Franknakub/driver-drowsiness-detection/hardware/README.md

# Hardware

## ไฟล์ล่าสุด (v2, 3 ต.ค. 2026)

| ไฟล์ | ใช้ทำอะไร |
|---|---|
| `fabrication/2026-10-03_v2/Gerber_PCB1_1_v2_2026-10-03.zip` | อัปโหลดสั่งผลิต PCB ที่ JLCPCB |
| `fabrication/2026-10-03_v2/BOM_PCB1_1_v2_2026-10-03.xlsx` | รายการชิ้นส่วน + รหัส LCSC สำหรับ PCBA |
| `fabrication/2026-10-03_v2/PickAndPlace_PCB1_1_v2_2026-10-03.xlsx` | ตำแหน่งวางชิ้นส่วนสำหรับ PCBA |
| `easyeda/DriverDrowsiness_v2_2026-10-03.epro2` | ไฟล์โปรเจกต์ EasyEDA Pro เปิดด้วย File → Import |

## บอร์ด PCB1_1 v2

| รายการ | ค่า |
|---|---|
| ขนาด | 58.55 × 73.03 มม. 2 ชั้น FR4 |
| ชิ้นส่วน | 37 ชิ้น ประกอบด้านบนทั้งหมด |
| DRC | 0 error |
| กฎออกแบบ | เส้นสัญญาณ 0.30 มม. · ระยะห่าง 0.20 มม. · via 0.61/0.30 มม. |
| เส้นไฟ | 0.80 มม. เท่าที่ระยะห่างยอมให้ (ความยาวที่ได้ 0.80 มม.: 5V 62% · GND 46% · 3V3 38% · VIN 34%) ส่วนที่เหลือ 0.30–0.60 มม. |
| ทองแดง | GND เททั้งสองชั้น + via เย็บ GND 58 ตัว (ห่างกัน ~8.4 มม.) รวม via 82 ตัว |
| รูยึด | M3 (Ø3.2) 4 มุมที่ (11.2, −19.5), (61.8, −19.5), (11.2, −84.5), (61.8, −84.5) + MOUNT1 Ø7.5 ที่ (36.4, −83.2) สำหรับขาตั้งกระจก |
| ไฟเข้า | USB-C (USB1) → CH221K ขอ 5V → สวิตช์ SW1 → ราง 5V |

### เปลี่ยนจาก v1

| # | v1 (31 ส.ค.) | v2 |
|---|---|---|
| 1 | **header U5/U6 เป็นภาพกระจกของโมดูล** เสียบโมดูลหงายแล้วขาไม่ตรง | สลับ U5/U6 ให้ตรงกับโมดูลที่เสียบหงาย (กล้องขึ้น) ปลาย USB หันขอบบน |
| 2 | บอร์ดยาว 65.66 มม. | ยาว 73.03 มม. ย้าย MOUNT1 ลงให้พ้นปลายโมดูลที่ยื่น ~10 มม. |
| 3 | ไม่มีรู M3 | เพิ่มรู M3 สี่มุม และย้าย H2 เป็นแนวนอนที่ (14.1, −24.5) |
| 4 | H2 (buzzer) เลี้ยงด้วย 5V | เลี้ยงด้วย **3V3** ให้ GPIO 3.3V ปิดเสียงได้แน่นอน |
| 5 | เส้นตามกฎ JLCPCB ขั้นต่ำ | เส้น 0.30 มม. / ระยะห่าง 0.20 มม. ตามกฎอาจารย์ |
| 6 | — | silkscreen ลูกศร `MODULE USB` + `CAMERA SIDE UP` และ `DDD v2 2026-10` |

⚠️ **ห้ามเสียบโมดูลบนบอร์ด v1** ขา 5V/GND ของโมดูลไปตกที่เน็ต GND/5V ของบอร์ด ไฟจะเข้ากลับขั้ว

### การวางโมดูล ESP32-S3-CAM

- เสียบหงาย กล้องหันขึ้น ปลาย USB หันขอบบนของบอร์ด (ตามลูกศรบน silkscreen)
- ปลาย USB เสมอแถวขาบนสุด ปลายฝั่ง 3V3 ยื่นเลยแถวขาล่าง ~10 มม. กว้าง ~20 มม. ส่วนนี้คือเสาอากาศ WiFi
- ตอนเสียบสายคอมเข้าพอร์ต USB ของโมดูล ให้เลื่อน SW1 ไปที่ OFF ก่อน (ขา 5V ของโมดูลต่อตรงกับราง 5V ของบอร์ด)

## ไฟล์เก่า

| โฟลเดอร์ | เนื้อหา |
|---|---|
| `fabrication/archive/2026-08-31_v1_ordered/` | v1 ที่สั่งผลิตไปแล้ว (header เป็นภาพกระจก) |
| `fabrication/archive/2026-08-31_1142/` | export ระหว่างทาง ก่อนแก้ C7/H2 |
| `fabrication/archive/2026-08-28/` | ชุดแรก |
| `easyeda/archive/DriverDrowsiness_v1_2026-08-31.epro2` | โปรเจกต์ v1 |

## ประเด็นที่ยังเปิดอยู่

1. **โมดูล buzzer จริง** ยังไม่ได้ดูว่าใช้ทรานซิสเตอร์ PNP หรือไม่ ถ้าไม่ใช่ เสียงที่ไฟ 3V3 อาจเบากว่าเดิม และต้องเช็คลำดับขาก่อนเสียบ
2. **ไฟเขียว LED1 หรี่** R11 = 470Ω ได้กระแส ~1 mA ถ้าต้องการให้สว่างขึ้น เปลี่ยนเป็น 120Ω ตอนบัดกรีได้
3. **IR LED ใน BOM** TSAL6200 เป็น 940 nm (Vishay doc 81010) ไม่ใช่ 850 nm ถ้าต้องการ 850 nm ใช้ TSHG6400 แทน เป็น through-hole เปลี่ยนเองได้
4. **IR-cut filter ของกล้อง** ยังทดสอบไม่จบ ถ้ากล้องมีฟิลเตอร์ IR LED จะไม่มีผล ใช้ `firmware/DrowsinessDiag` ทดสอบ
5. **อุณหภูมิ** ชิปรับได้ถึง 65°C แต่ในรถกลางแดดถึง 70–80°C ต้องถอดเก็บเมื่อจอด
