Franknakub/driver-drowsiness-detection/enclosure/README.md

# กล่อง 3D

> ⚠️ **ไฟล์ใน `cad/out/` เป็นฉบับร่าง (18 ต.ค. 2026) ยังห้ามสั่งปริ้นตัวจริง** — ยังมีค่าสมมติ (ดูหัวข้อ "ก่อนสั่งปริ้น")

| ไฟล์ | เนื้อหา |
|---|---|
| [DESIGN_INPUTS.md](DESIGN_INPUTS.md) | ค่าที่เชื่อได้ (Gerber v2 + ค่าวัดจริง) · ค่าที่ขัดกัน C1–C6 · ค่าที่ต้องวัดใหม่ |
| [DESIGN_PROPOSAL.md](DESIGN_PROPOSAL.md) | แบบที่ผู้ใช้อนุมัติแล้ว 17 ต.ค. (ผังรวม, หน้าตัดความสูง, รายละเอียดทุกช่อง) |
| `cad/enclosure.py` | สคริปต์ build123d — ค่าทุกตัวอยู่หัวไฟล์ พร้อมป้าย `MEAS` / `DESIGN` / `ASSUMED` |
| `cad/check.py` | ตรวจการชนกับหุ่นจำลองชิ้นส่วน + ส่ง SVG มุมมองบน |
| `cad/out/` | `lid` (ฝาหน้า) · `base` (ฐาน) · `sw1_extender` (ด้ามต่อสวิตช์) เป็น `.step` และ `.stl` (สร้างใหม่ทุกครั้งที่รันสคริปต์) |
| `print_2026-10-18/` | **ชุดส่งร้านปริ้น** (สำเนาคงที่ของ cad/out 18 ต.ค.) + `ข้อความส่งร้าน.txt` · ด้ามต่อ SW1 ในชุดนี้ใช้ไม่ได้ (ดูแถวล่าง) |
| `print_2026-10-26/` | **ด้ามโยก SW1** (`sw1_rocker`) + **ขาแขวนหมุด** (`sw1_bracket`) แทนด้ามต่อแบบเลื่อน + `ข้อความส่งร้าน.txt` · ฝา/ฐานใช้ชุด 18 ต.ค. · **ปริ้นแล้วพัง (4 พ.ย.) ไม่ได้ใช้** |

แบบร่างเก่า https://claude.ai/artifact/W44j3wrijPSJBLZRLcjgHY ใช้ขนาดเดา **เลิกใช้แล้ว**

## สร้างไฟล์ใหม่หลังแก้ค่า

```bash
uv venv --python 3.12 "$LOCALAPPDATA/ddd-enclosure-venv"
uv pip install --python "$LOCALAPPDATA/ddd-enclosure-venv/Scripts/python.exe" build123d
cd enclosure/cad
PYTHONIOENCODING=utf-8 "$LOCALAPPDATA/ddd-enclosure-venv/Scripts/python.exe" enclosure.py
PYTHONIOENCODING=utf-8 "$LOCALAPPDATA/ddd-enclosure-venv/Scripts/python.exe" check.py
```

ต้องได้ `lid solids 1 valid True` และ `no clashes` ก่อนส่งไฟล์ (venv ที่ `%LOCALAPPDATA%\ddd-enclosure-venv` ติดตั้งไว้แล้ว)

## ฉบับร่างปัจจุบัน

- ภายนอก **64.5 × 120.3 × 36.8 มม.** (ค่าวัดถึง 18 ต.ค.) (ไม่รวมหูรัดสาย USB1 ที่ยื่นจากฐาน 12 มม.)
- ความสูง (z จากผิวพื้นใน): หลังกล่อง −6 · ผิวบน PCB 7.69 · ยอดเลนส์ 28.46 · ผิวในฝา 28.76 · ผิวนอกฝา 30.76
- หูรัดสาย USB-C ยกขึ้นเป็นก้อนตันถึงใต้หัวสาย ห่าง 0.8 มม. (18 ต.ค.) · เคเบิลไทร์ลอดร่องบนหู อ้อมปลายหู แล้วพาดข้ามหัวสาย
- จอ OLED หมุน 90° ในส่วนต่อขยาย (18 ต.ค.): ตอนติดตั้ง ขาจออยู่บน ภาพแนวนอน 128×64 ปกติ ไม่ต้องหมุนภาพใน firmware
- ติดตั้งแนวนอน **แถว IR อยู่บน** (ผู้ใช้เลือก 18 ต.ค.): น็อตขาดูดอยู่บน · สาย USB-C เข้าจากล่าง · จอ OLED อยู่ขวามือคนขับ · ช่อง USB โมดูลอยู่ซ้าย · ป้ายสลักอ่านแนวนอน
- **ทดสอบแล้ว 18 ต.ค.:** ทิศนี้ (กล้องหันหาคนขับ ช่อง USB โมดูลอยู่ซ้าย) ภาพดิบตะแคง 90° → firmware ใช้ `CAM_ROTATE_CW 270` ตามเดิม ภาพบน `/snapshot.jpg` ตั้งตรง · ผู้ใช้ยืนยันเลือกแนวนอน (ยอมเสียเวลาหมุนภาพ ~31 ms/เฟรม ที่ HVGA) แทนกล่องแนวตั้ง

### ขาติดตั้ง (ผู้ใช้เลือก 18 ต.ค.)

ขาดูดกระจกแบบกล้องหน้ารถ: ถ้วยดูด ~70–80 มม. + คันโยก PRESS → ข้อพับปรับมุมด้วยน็อตปีก 2 ข้อ → แป้นกลมลายตาข่าย **Ø30.36** (วัด) กับเกลียวตัวผู้ **1/4"-20** (วัด Ø 6.3–6.4)

- **หลังกล่องหันเข้ากระจก** หน้ากล่อง (กล้อง/IR/จอ) หันหาคนขับ กล่องห้อยจากขาดูด
- น็อต 1/4"-20 ฝังในฐานที่ (48.0, 47.5) คือราวกลางแนวยาว เยื้องไปฝั่ง IR ห่างขอบโมดูลและเสาอากาศ ~5.5 มม. ในแนวราบ และต่ำกว่าเสาอากาศ ~20 มม.
  - ศูนย์กลางกล่องจริงอยู่ตรงเสาอากาศพอดี จึงไม่ใช้จุดนั้น
- หลังกล่องหนาขึ้นทั้งแผ่นอีก 6 มม. น็อตจึงจมอยู่ใต้ผิวพื้นในทั้งตัว
  - พื้นในเหนือน็อตมีขา THT ของ header/IR โผล่ใต้บอร์ด ทำเสานูนขึ้นไปไม่ได้
  - ทำเป็นแป้นนูนแค่ตรงจุดขันก็ไม่ได้ เพราะต้องใช้ support ตอนปริ้น
- **ความยาวเกลียวที่ใช้ได้:** วัดจากหน้าแป้นลายตาข่ายถึงปลายเกลียว ต้องอยู่ระหว่าง **5.8–11.5 มม.**
  - 5.8 มม. กินเกลียว 3 รอบ ถ้า ≥ 7.6 มม. กินเต็มน็อต
  - ถ้ายาวเกิน 11.5 มม. ปลายเกลียวจะชนใต้ PCB ให้หมุนแหวนล็อกบนขาลงมาบังส่วนเกิน
  - **วัดแล้ว 10.16 มม.** (18 ต.ค.) → กินเต็มน็อต ปลายเกลียวยังห่างใต้ PCB ~1.3 มม.

## อะไหล่

| ของ | จำนวน |
|---|---|
| ✅ ซื้อแล้ว · น็อต M3 × 10 หัวจมหกเหลี่ยม**ทรงกระบอก** (DIN 912 · HSHMS-M3x10 · หัว Ø5.5 สูง 3 · ไม่ใช่หัวเตเปอร์) (MH1–MH4) | 4 |
| ✅ ซื้อแล้ว · น็อต M3 × 6 หัวจมหกเหลี่ยมทรงกระบอก (DIN 912 · HSHMS-M3x6) (มุมส่วนต่อขยาย) | 2 |
| ✅ ซื้อแล้ว · heat-set insert M3 × 5.7 (D1 4.6 · formflex ใน Shopee · รูเจาะ 4.0 ลึก 6.7) · สั่ง 10 ชิ้นเผื่อเสีย | 6 |
| ✅ ซื้อแล้ว · สกรูเกลียวปล่อยหัวจมหกเหลี่ยม M2 × 5 (HSHTS-M2x5 · จอ OLED · จอร่นจากผิวในฝา 0.8 ให้ปลายสกรูเหลือเนื้อหน้าฝา 0.8) | 4 |
| ✅ ซื้อแล้ว · สกรูเกลียวปล่อยหัวจมหกเหลี่ยม M3 × 6 (HSHTS-M3x6 · buzzer) | 1 |
| ✅ ซื้อแล้ว · น็อตหกเหลี่ยม 1/4"-20 ขนาด 7/16" (11.1 มม.) หนา ≤ 5.6 (ฝังในฐาน ใส่จากด้านในก่อนวาง PCB) | 1 |
| ✅ ซื้อแล้ว · แท่งอะคริลิกใส Ø3 (light pipe) · LED1 ยาว ~23.4 มม. ใส่เอียง 15° · LED2 ~22.6 มม. · วัด Ø จริงตอนของถึง (รูบนฝา 3.2) | 2 |
| ✅ ซื้อแล้ว · เคเบิลไทร์เล็ก (รัดสาย USB-C ที่หูฐาน) | 1 |
| ✅ มีแล้ว · ประแจหกเหลี่ยม 2.5 (M3 หัวจม) และ 1.5 (M2 เกลียวปล่อย) | 1 ชุด |
| ✅ ซื้อแล้ว · หัวแร้งปรับอุณหภูมิได้ (TASKTOOL 150W ชุด 18 ชิ้น) | 1 |
| ✅ ซื้อแล้ว · กระดาษทรายน้ำเบอร์ 600 | 1 |
| ✅ ซื้อแล้ว · กาวอีพ็อกซี UHU 5 นาที สีใส (ยึดแท่งอะคริลิก ห้ามกาวตราช้าง) | 1 |

## สั่งปริ้น (ส่งร้าน)

- **ASA สีดำทึบ** (ผู้ใช้เลือก · ทน UV และ ~95°C) — ห้าม PLA (นิ่มที่ 55–60°C รถกลางแดด 70–80°C)
- FDM หัว 0.4 · ชั้น 0.2 มม. · ผนัง (perimeter) ≥ 4 เส้น ให้ผนัง 2 มม. ทึบทั้งหมด (แสง IR 940 nm ทะลุพลาสติกบางได้) · infill 30%
- `lid`: คว่ำหน้าฝาลงฐานพิมพ์ · `base`: วางพื้นลง · ไม่ต้องมี support ทั้งสองชิ้น (ช่อง USB โมดูลเป็นสะพาน ~24 มม.)
- `sw1_rocker`: วางตั้ง ง่ามลงพื้น · `sw1_bracket`: ใส่ support ได้ · `sw1_pin`: วางตั้ง หัวลงพื้น (สั่ง 2 ชิ้น สำรอง 1) · infill 100% ทุกชิ้น · รูหมุดต้องทะลุ
- **ด้ามต่อแบบเลื่อน (18 ต.ค.) ใช้ไม่ได้** (ทดสอบ 26 ต.ค.): ดันที่ปลายแล้วด้ามเอียงงัดก้าน สวิตช์ไม่เลื่อน (ดันที่โคนเลื่อนได้) · ก้าน SW1 เองก็โยกเอียงในตัวสวิตช์ได้ · แบบแผ่นยาวใต้ฝา (commit ce36122) ก็ไม่พอ: หัวด้ามสูงกว่าก้าน ~18 มม. แผ่นยาว 12 มม. → แรงเสียดทานกินแรงดัน (μ ~0.3 ต้องออกแรง ~10 เท่า) ไม่ได้ปริ้น
- **ก้าน SW1 งอ/เอียงได้มาก** (ผู้ใช้ 26 ต.ค.): ดันปลายก้าน ก้านแค่เอียงจนเกือบหัก สวิตช์ไม่เลื่อน · ดันโคนก้านชิดตัวสวิตช์เลื่อนได้ → อะไรก็ตามที่ขับ SW1 ต้องดันที่โคนก้าน
- **ด้ามโยก (26 ต.ค.):** คันโยกหมุนรอบหมุดปริ้น ASA (`sw1_pin` Ø1.8 หัว Ø3.2 × 0.8 · รูแก้ม 1.9 · รูด้าม 2.1 ในปุ่มกลม R2.15 ยอดปุ่มต่ำกว่าแผ่นติดกาว 0.4 · ผู้ใช้เลือกปริ้นหมุดแทนลวดคลิป) ที่สูง z 25.0 ในขาแขวนซึ่งติดอีพ็อกซีใต้ฝารอบร่อง (เดือยสองปลายเข้าร่องฝาไว้จัดตำแหน่ง) · ง่ามแตะก้าน**เฉพาะแถบล่างสูง 1 มม.** (ช่อง 1.95 ผนัง 0.8) ก้นง่ามสูงกว่าหลังตัวสวิตช์ 0.4 · เหนือแถบเว้นช่อง 3.5 ไม่ให้แตะปลายก้าน (ห่าง ≥ 0.28 ตอนโยกสุด) · โยก ±8.9° = ก้านเลื่อน ±1.88 · หัวด้ามขยับ ±1.17 **กลับทิศกับก้าน** (บนโต๊ะ: หัวด้ามไปทางโมดูล = OFF) · แรงที่หัวด้าม ~1.6 เท่าแรงสวิตช์ · โยกได้สุด ~15° ก่อนชนขาแขวน · ง่ามห่างตัวสวิตช์ ≥ 0.28 ทุกมุม · `check.py` ไม่ชนทุกมุม ขาแขวนห่างเสา MH3 0.28 มม. · ขาแถบสัมผัสบาง 0.8 อาจเปราะ · **ปริ้นแล้วพัง (4 พ.ย.)**
- ประกอบ: สอดหัวด้ามขึ้นผ่านช่องขาแขวน → เสียบหมุดจากแก้มฝั่ง y น้อย (ฝั่งไกลจากเสา MH3) ผ่านแก้ม-ด้าม-แก้ม ปลายหมุดโผล่ 0.3 แต้มอีพ็อกซีติดแก้ม (ห้ามโดนด้าม) → สอดหัวด้ามขึ้นร่องฝาจากด้านใน ให้เดือยลงร่อง → ทาอีพ็อกซีเฉพาะผิวแผ่นติดกาว (ห้ามโดนหมุด) · ตอนปิดฝา โยกด้ามให้ง่ามตรงก้าน (SW1 = OFF) · สาย dupont ห้ามพาดผ่านขาแขวน
- **ที่ใช้จริงตอนนี้:** **4 พ.ย. (ผู้ใช้): ชิ้น SW1 ที่ปริ้น 3D พัง และสวิตช์ใหม่ที่ซื้อมาใช้ไม่ได้ → ใช้ SW1 เดิมบนบอร์ด เลื่อนด้วยไม้จิ้มฟันแหย่ผ่านร่องฝา ดันที่โคนก้าน**

## ประกอบ

1. ใส่ insert M3 ในเสาของฝา 6 ตัว (หัวแร้ง) · ใส่น็อต 1/4"-20 ในช่องหกเหลี่ยมของฐานจากด้านใน
2. ยึดจอ OLED ใต้ฝา (กระจกแนบหน้าต่าง) ด้วย M2 × 4 · ยึด buzzer บนเสาฐาน
3. เสียบโมดูลบน PCB → วาง PCB บนเสาฐาน · ต่อสาย dupont H1→จอ, H2→buzzer (ลำดับขาตาม CLAUDE.md ประเด็นค้าง #1, #7)
4. SW1 ไม่ต้องใส่ด้ามต่อ (เปิด/ปิดด้วยไม้จิ้มฟันแหย่ผ่านร่องฝา ดันที่โคนก้าน) · สอดแท่งอะคริลิกในรู LED · ปิดฝา ขันน็อตจากด้านหลัง 6 ตัว
5. ขันกล่องเข้าเกลียวขาดูด หมุนให้ภาพตั้งตรงแล้วล็อกแหวน
6. ⛔ **SW1 = OFF ก่อนเสียบสาย USB เข้าโมดูลเสมอ** (มีป้ายสลักบนฝา)

## ก่อนสั่งปริ้น

ผู้ใช้ตัดสิน 18 ต.ค.: **ไม่ปริ้นทดลอง · วัดค่าสมมติให้ครบก่อน แล้วสั่ง ASA** (ระยะเผื่อ 0.45 มม.)

1. กรอกช่องป้าย "วัดใหม่" ใน[ตารางวัดขนาด](https://claude.ai/artifact/4DLjDZ4ykqrCnTMR8mrWsw) แล้วให้ Claude อ่าน db ใส่หัว `enclosure.py`:
   ก้าน SW1 (`sw_lw`, `sw_lt`) · แผ่น PCB จอ (`oled_pt`) · ตำแหน่งรูจอ (`oled_hx`, `oled_hy`) · พื้นที่แสดงผล (`view_w/h`, `view_dx/dy`) · หัว dupont ของ buzzer (`bz_dup`) · (insert เลือกแล้ว: M3 × 5.7 ไม่ต้องกรอก `ins_spec`)
2. ~~ทดสอบทิศภาพ~~ ✅ ทำแล้ว 18 ต.ค. (firmware ไม่ต้องแก้)
3. ทดสอบมุมกล้องในรถจริงด้วยขาดูด — กล่องจะอยู่สูงกว่าตาคนขับและมองลง ซึ่งยังไม่เคยทดสอบหาหน้า (ทดสอบแล้วแค่ระดับตา 100% และมองขึ้นจากต่ำ 20%)
4. รัน `enclosure.py` + `check.py` ใหม่ ต้องได้ `no clashes` และ LED rod ทั้งสองข้าง `ok`

ค่าวัดชุด 17 ต.ค. (ความสูงเลนส์, ตำแหน่งเลนส์, USB, SW1, หัวสาย) และความยาวเกลียวขาดูด 10.16 ใส่แล้ว · LED1 อยู่ใต้มุมโมดูล จึงใช้แท่งเอียง 15° ไปทางขอบล่างบอร์ด (ยาว ~23.4 มม.)
