Franknakub/driver-drowsiness-detection/enclosure/DESIGN_INPUTS.md

# ข้อมูลตั้งต้นสำหรับออกแบบกล่อง (17 ต.ค. 2026)

แหล่งข้อมูล: Gerber/PickAndPlace `FinalV2/` (3 ต.ค.) · db ของตารางวัดขนาด (`plan/measure` v332, กรอกล่าสุด 14 ต.ค.) · CLAUDE.md ชั้นบน · ผลทดลองหาหน้า (FaceSpike)

**ระบบพิกัด:** วางบอร์ดด้านชิ้นส่วนขึ้น ลูกศร `MODULE USB` ชี้ขึ้น · x = มม. จากขอบซ้าย · y = มม. จากขอบบน · z = สูงจากผิวบน PCB
**สูตรแปลงจาก EasyEDA ยืนยันจาก Gerber แล้ว** (ขอบบอร์ด X 7.239…65.786, Y −15.494…−88.519): `x = X − 7.239` · `y = −15.494 − Y` → รูยึดห่างขอบ 4.00 มม. จริง ไม่ใช่ค่าสมมติแล้ว

---

## 1. ค่าที่มีแล้วและเชื่อได้

### จากไฟล์ผลิต v2 (Gerber + PnP)

| ชิ้น | x, y (มม.) | หมายเหตุ |
|---|---|---|
| บอร์ด | 58.55 × 73.03 | |
| MH1–MH4 NPTH Ø3.20 | (4.00, 4.00) (54.55, 4.00) (4.00, 69.02) (54.55, 69.02) | **v1 ไม่มีรูเหล่านี้** |
| MOUNT1 NPTH Ø7.50 | (29.21, 67.69) | |
| U6 header (ซ้าย) | รู x 13.08 / 15.62 · y 2.29 … 50.55 | 2×20 ระยะ 2.54 |
| U5 header (ขวา) | รู x 41.02 / 43.56 · y 2.29 … 50.55 | ขาโมดูลลงแถวใน (15.62 / 41.02 ห่าง 25.40) → แนวกลางโมดูล x = 28.32 |
| IR1–IR4 | x 53.76 · y 12.51 / 26.51 / 40.51 / 54.51 | ขา x 52.49 / 55.03 |
| LDR (R2) | (5.59, 31.37) | ขา y 29.67 / 33.07 |
| USB1 (USB-C รับไฟ) | (3.68, 17.40) หมุน 270° | รูยึดเปลือก x 2.38 / 6.08, y 13.08 / 21.72 |
| SW1 SS-12D01 | (7.49, 62.49) | ขาเรียงแนว x 4.99 / 7.49 / 9.99 → ก้านเลื่อนแนวซ้าย–ขวา |
| H1 (OLED 4 ขา) | x 5.33 · y 38.23 … 45.85 | แนวตั้ง |
| H2 (buzzer 3 ขา) | y 9.02 · x 4.32 / 6.86 / 9.40 | แนวนอน |
| LED1 เขียว / LED2 แดง | (41.15, 58.04) / (46.48, 57.92) | SMD 0805 / 0603 |
| C7 (ตัวเก็บประจุทรงกระบอก Ø5) | (4.95, 54.99) | ความสูงยังไม่ได้วัด (ต่ำกว่า header แน่นอน) |

### จากการวัดจริง (ผู้ใช้ · ค่าในวงเล็บคือค่าที่อ่านได้)

| id | ค่า | หมายเหตุ |
|---|---|---|
| pcb_t | 1.69 | |
| pcb_w | 58.55 (58.547) | ตรงแบบ |
| ir_h1–4 | 9.31 (11 − 1.69) | ตั้งตรงทั้ง 4 ดวง |
| ir_d | 5.9 | ปีกโคน TSAL6200 (ค่าแบบ 5.0 เป็นค่าเดาเก่า) |
| sw_h | 8.31 (10 − 1.69) | |
| usb1_h | 3.11 (4.8 − 1.69) | |
| usb1_over | 0.95 (59.5 − 58.55) | USB1 ยื่นเลยขอบซ้าย |
| hdr_h | 11.7 | |
| h12_h | 10.1 | ปลายขา H1 |
| ldr_h | 2.01 (3.7 − 1.69) | |
| bot_h | 2.6 (4.29 − 1.69) | ขาใต้บอร์ดยาวสุด |
| mod_t / mod_w / mod_l | 1.6 / 28.25 / 57 | |
| mod_pin | 8.35 | ขาใต้โมดูลรวมพลาสติก |
| ant_len | 6.1 | เสาอากาศยื่นเลยขาแถวล่าง |
| usbm_w / usbm_over | 9.1 / 0 | USB โมดูลเสมอขอบแผ่น (ผู้ใช้ยืนยัน) |
| btn_side | ด้านกล้อง | ปุ่ม BOOT/RST กดจากด้านบนได้ |
| lens_d / cam_w × cam_l | 7.1 / 8.5 × 8.5 | |
| lens_x | 28.17 | ตรงกับแนวกลางโมดูล 28.32 |
| cam_fix | วางบนฝาโลหะ สายแพพับเข้าช่องเสียบ | |
| led_block | ไม่โดนบัง | |
| oled_w × oled_h × oled_t | 28.9 × 27.46 × 3.21 | |
| glass_w × glass_h | 26.6 × 19.2 · ห่างขอบซ้าย 1.4 / ขวา 0.9 / บน 4.8 | 1.4 + 26.6 + 0.9 = 28.9 ตรงกัน |
| oled_hd / oled_cx / oled_cy | 2.1 / 23.04 / 23.59 | |
| oled_pins | VCC GND SCL SDA · ขาชี้ไปด้านหลังจอ | |
| bz_w × bz_h / bz_d / bz_hgt | 12.95 × 32 / 12 / 11 | |
| bz_hole | Ø3.24 ที่ (6.36, 15.58) | 1 รู กลางแผ่น |
| bz_pins | VCC I/O GND | |

**ค่าที่คำนวณได้:**
- โมดูลวางกลาง header → ขอบซ้าย 14.20 ขวา 42.45 (ดู conflict C1)
- ปลายเสาอากาศ = แถวขาล่าง 50.55 + 6.1 = **y 56.65** → ปลาย USB = 56.65 − 57 = **y −0.35** (USB โมดูลเสมอขอบบน PCB โดยประมาณ ยื่นออก ~0.35)
- LED1 อยู่ใต้ปลายเสาอากาศแค่ **1.4 มม.** (y 58.04 vs 56.65) และอยู่ในแนว x ของโมดูล → light pipe ต้องเลี่ยงหรือสอดใต้

---

## 2. ค่าที่ขัดกัน

| # | เรื่อง | รายละเอียด |
|---|---|---|
| C1 | `mod_left` 13.2 | แบบ (กลาง header) ให้ 14.20 ต่างกัน 1.0 มม. → วัดซ้ำ หรือเชื่อแบบ |
| C2 | ความสูงชุดโมดูล (ขั้น 4 vs ขั้น 2–3) | `st_mod` 14.2 · `st_can` 15.7 · `st_lens` 20.66 → ฝาโลหะสูงเหนือแผ่น 1.5 แต่ `mod_top` = 3.27 · เลนส์สูงเหนือแผ่นโมดูล 6.46 แต่ `lens_h` = 7.1 (8.7 − 1.6) หรือ 11.97 ตามที่ form คำนวณ (ใช้สูตรผิด) · และ `hdr_h` 11.7 + พลาสติกขาโมดูล + 1.6 น่าจะ ≥ 15 ไม่ใช่ 14.2 · **`st_lens` กำหนดความสูงฝา ต้องได้ค่าที่ลงตัวก่อน** |
| C3 | `pcb_h` 73.03 และ `mh_*` | คัดลอกจากแบบ ไม่ได้วัด (บอร์ดในมือคือ v1 = 65.66) — ตอนนี้ไม่ใช่ปัญหาแล้วเพราะ Gerber ยืนยันให้ แต่ต้องวัด v2 ยืนยันเมื่อมาถึง |
| C4 | `view_w` 26.66 > `glass_w` 26.6 | พื้นที่แสดงผลกว้างกว่ากระจกเป็นไปไม่ได้ → น่าจะวัดขอบดำของกระจก ไม่ใช่ส่วนที่ติดสว่าง |
| C5 | `sw_travel` 8.6 | SS-12D01 ก้านเลื่อนได้ราว 2 มม. ตามปกติ (ยังไม่ได้ดู datasheet) · 8.6 น่าจะเป็นค่าอื่น → วัดซ้ำ |
| C6 | `lens_x` N/F = 25.34 / 31 → กว้าง 5.66 | แต่ `lens_d` = 7.1 · ศูนย์กลางใช้ได้ แต่ Ø ไม่ตรงกัน |

---

## 3. ค่าที่ต้องวัดใหม่ / ยังไม่ได้วัด

ทำบน **บอร์ด v1 ได้ทุกข้อ** (header, ขอบบน/ซ้าย และชิ้นส่วนอยู่ตำแหน่งเดียวกับ v2) **ห้ามจ่ายไฟ v1 ขณะเสียบโมดูล**

| ลำดับ | id | ทำไมต้องใช้ |
|---|---|---|
| 1 | `st_mod`, `st_can`, `st_lens` (วิธี C หนีบจากใต้ PCB, อ่าน − 1.69) | ความสูงฝา + ตำแหน่ง z ของปุ่ม/USB โมดูล |
| 2 | `lens_y` (จากขอบล่าง v1 = 65.66 แล้วแปลง) | ตำแหน่งช่องกล้อง — ตอนนี้มีแค่ค่าประเมิน y ≈ 42.5 |
| 3 | `usbm_x`, `usbm2_x` + ทั้งสองพอร์ตอยู่ด้านกล้องหรือด้านใต้โมดูล + `usbm_hh` | ช่องแฟลชที่ผนังบน · ตอนนี้มี 20.3 / 8.93 จากขอบซ้ายโมดูล แต่ CLAUDE.md ให้วัดใหม่ |
| 4 | `boot_x/y`, `rst_x/y` | ช่องกดปุ่ม · ตอนนี้ (6.07, 12.78) / (23.24, 12.78) |
| 5 | `mod_left`, `mod_topedge`, `mod_bot` บนบอร์ด v1 | ยืนยันตำแหน่งโมดูล + ระยะเสาอากาศถึง LED1 |
| 6 | `view_w`, `view_h` (ส่วนที่ติดสว่างตอนจอเปิด) | ขนาดหน้าต่าง OLED |
| 7 | `sw_travel` + หน้าตัดก้าน SW1 (กว้าง × หนา) | ร่องบนฝา + รูสวมของด้ามต่อ (ตอนนี้สมมติ 3.0 และ 2.0 × 1.6) |
| 8 | ขั้น 7 ทั้งหมด: หัว USB-C สายไฟ (`usbc_w/t/l`) · หัวสายแฟลช (`usbm_plug`) · `dup_l` | ขนาดช่อง USB1, ช่องแฟลช และความสูงสาย dupont ที่ H1/H2 |
| 9 | ความสูง C7 | ถ้าจะทำผนังกั้นใกล้ C7 |
| — | FOV (ขั้น 8) | ข้ามได้ ใช้ช่องกรวย 120° ตามที่ตกลงไว้ |

---

## 4. อัปเดต 18 ต.ค. — ค่าชุดใหม่จากหน้าเว็บ (db v466 กรอกล่าสุด 17 ต.ค.) ใส่ใน `cad/enclosure.py` แล้ว

| id | เดิม | ใหม่ | หมายเหตุ |
|---|---|---|---|
| pcb_t | 1.69 | **1.6** | |
| hdr_h | 11.7 | **8.51** | |
| st_mod / st_can / st_lens | 14.2 / 15.7 / 20.66 | **12.68 / 15.85 / 20.77** | **C2 ปิดแล้ว**: 12.68 + mod_top 3.27 = 15.95 ≈ 15.85 · 15.85 + เลนส์เหนือฝา 4.95 = 20.80 ≈ 20.77 |
| lens_x, lens_y | 28.17, (ประเมิน 42.5) | **28.79, 40.11** | |
| mod_left | 13.2 | 13.2 | **C1: ใช้ค่าวัด** (แบบกลาง header ให้ 14.20) |
| mod_topedge / mod_bot | (คำนวณ −0.35 / 56.65) | **0.65 / 58.22** | ยาวรวม 57.57 เทียบ mod_all 57 ต่าง 0.57 |
| sw_travel · ตัว SW1 | (8.6 ขัดกัน) | **3.76** · 8.55 × 3.85 × 4.3 | **C5 ปิดแล้ว** |
| หัว USB-C ไฟเข้า / สายแฟลช | สมมติ 12.5 × 7 | **11 × 6.52** ทั้งคู่ | ยาว 21.6 |
| dup_l | สมมติ 17 | **18.05** | |
| glass_dx | 1.4 | **0.72** | |
| ir_d / ir_h / ldr_h / usb1_h / bot_h / sw_h | 5.9 / 9.31 / 2.01 / 3.11 / 2.6 / 8.31 | 5.8 / 9.05 / 2.1 / 3.2 / 2.69 / 8.3 | |
| พื้นที่แสดงผล OLED | สมมติ 22 × 11.2 | ค่าสเปก 21.74 × 10.86 | หน้าเว็บตกลงให้ข้ามการวัด (C4) |

**ยังเป็นค่าสมมติ:** หน้าตัดก้าน SW1 (2.0 × 1.6) · ความหนาแผ่น PCB จอ (1.0) · รูจออยู่กึ่งกลางแผ่น · พื้นที่แสดงผลอยู่กึ่งกลางกระจก · ระยะหัว dupont บนขางอของ buzzer (ใช้ dup_l แทน) · ขนาด heat-set insert M3

**⚠️ ปัญหาใหม่: LED1 อยู่ใต้มุมโมดูล** — ตามค่าวัดใหม่ โมดูลกินพื้นที่ x 13.2–41.45, y 0.65–58.22 แต่ LED1 อยู่ที่ (41.15, 58.04) คือเข้าไปใต้มุมขวาล่างของโมดูล (ปลายเสาอากาศ) 0.3 × 0.18 มม. แท่งนำแสง Ø3 ที่ตั้งตรงจะทะลุแผ่นโมดูล (ชน 4 mm³ จาก `check.py`) · LED2 ไม่มีปัญหา

## 5. อัปเดต 18 ต.ค. (รอบ 2) — ช่องค่าสมมติที่ผู้ใช้กรอก (db v485)

| id | ค่า | ใช้ใน CAD |
|---|---|---|
| sw_lw × sw_lt | 1.5 × 1.5 | รูสวมด้ามต่อ SW1 |
| oled_pt | 1.6 | เสายึดจอสูง 3.21 − 1.6 = 1.61 |
| oled_hx | ขอบรู 1.2 / 4.55 → **2.875** | ตรงกับสมมติฐานรูกึ่งกลาง (2.93) |
| oled_hy | ขอบรู 1.2 / 4.55 → 2.875 | **ไม่ใช้**: ค่าเท่ากับแนวนอนทุกตัว และถ้าจริง รูล่างจะห่างขอบแผ่นแค่ 0.99 กับรัศมีรู 1.05 คือทะลุขอบ → ยังใช้กึ่งกลาง 1.935 (ASSUMED) |
| view_dx / view_dy | 0.8 / 3.9 | dy ขัดกับรูปถ่าย (~1.1) → หน้าต่างจอครอบทั้งแผ่นดำ (กว้างกระจก − 1.0, สูง 15 มม. จากขอบบนกระจก) ซึ่งครอบพิกเซลได้ทั้งสองกรณี |
| bz_dup | 17.45 | + 3 ที่ให้สายงอ → ส่วนต่อขยายยาวขึ้น กล่องเป็น 120.3 มม. |
| ins_spec | M3 × 5.7 · Ø4.6 | รูเจาะ 4.0 ลึก 6.7 ผนัง 1.6 |
