Franknakub/driver-drowsiness-detection/docs/reviews/2026-08-14_review-schematic1-pcb1_1.md

# Review — Schematic1 + PCB1_1 (ตรวจใหม่ทั้งหมด)
**วันที่:** 14 ส.ค. 2026 · **โปรเจกต์:** `Driver drowsiness detection` (`6e6f4621...`)
**ช่องทาง:** raw bridge พอร์ต 49620 (easyeda-agent MCP หลุด — ใช้ bridge แทน)

> เอกสารนี้**แทนที่** ข้อ B3 และรายละเอียดวงจรปุ่มใน `REVIEW_2026-08-14.md` ทั้งหมด — ดูหัวข้อ "แก้ข้อมูลเดิม" ท้ายเอกสาร

---

## เอกสารในโปรเจกต์ — ต้นตอของความสับสนทั้งหมด

| ประเภท | uuid | ชื่อ | ผูกกับ Board |
|---|---|---|---|
| Schematic | `9caf9f1539bfeee8` | **Schematic1** (หน้า P1 = `6dd8b81d63c2c1a9`) | Board1 |
| PCB | `efaaedaf8f524fe3` | **PCB1_1** | **Board1** ✅ |
| PCB | `9c4a26bbfe44b0bd` | **PCB1** | ❌ **ไม่ผูกกับ board ใดเลย — เอกสารกำพร้า** |

`Board1` = Schematic1 + PCB1_1 → **คู่นี้เท่านั้นที่เป็นของจริง**

⚠️ **`PCB1` เป็นไฟล์ลอย** ที่มี layout คนละแบบ (บอร์ดใหญ่กว่า, 33 ชิ้นส่วน, มี `C3`) ข้อมูลที่ผมรายงานไปรอบก่อนหน้าปนกันระหว่าง PCB1 กับ PCB1_1 เพราะ MCP กับ bridge เกาะคนละหน้าต่าง
**แนะนำ: ลบ PCB1 ทิ้ง** ถ้าไม่ได้ใช้แล้ว ไม่งั้นจะสับสนซ้ำอีก

---

## ผลการตรวจอัตโนมัติ

| การตรวจ | คำสั่ง | ผล |
|---|---|---|
| Schematic ERC | `eda.sch_Drc.check()` | `true` |
| PCB DRC | `eda.pcb_Drc.check()` | `true` |
| **SCH ↔ PCB netlist** | `eda.sys_Tool.netlistComparison()` + เทียบเน็ตลิสต์ตรง | ✅ **ตรงกันทุก net ทุกขา ไม่มีข้อต่างเลย** |
| จำนวนชิ้นส่วน | — | Schematic 31 · PCB1_1 31 ✅ |

> ค่า `true` ที่ ERC/DRC คืนมายังไม่มีเอกสารระบุความหมายแน่ชัด แต่ทั้งสองตัวคืนค่าเดียวกันและไม่มี error object กลับมา — น่าจะหมายถึงผ่าน ถ้าอยากชัวร์ให้เปิดหน้าต่าง DRC/ERC ใน EasyEDA ดูว่ารายการว่างจริง

---

# 🔴 BLOCKER

## B1 — SW2 ใช้ tact switch มาตัดไฟหลัก (ใหม่ ร้ายแรงสุด)

**Netlist:** `VIN ; R7.1 SW2.1 USB1.A9 USB1.B9` และ `5V ; R16.1 R17.1 R18.1 R19.1 SW2.2 U1.1 U5.39 U5.40`

SW2 ต่อ**อนุกรมคั่นระหว่าง VBUS กับราง 5V** = เป็นสวิตช์เปิด/ปิดไฟทั้งบอร์ด แต่ตัวที่เลือกคือ **TS-1088-AR02016**

| ประเด็น | สเปกจริงของ TS-1088-AR02016 | ภาระจริงบนบอร์ด | ผล |
|---|---|---|---|
| ชนิดสวิตช์ | **tact switch แบบกด-ปล่อย (SPST-NO momentary)** | ต้องการค้างสถานะเปิด | ❌ **ไฟติดเฉพาะตอนกดค้างเท่านั้น บอร์ดทำงานต่อเนื่องไม่ได้** |
| กระแสหน้าสัมผัส | **50mA @ 12VDC** | โมดูล ESP32-S3 พีคตอน WiFi TX ~500mA + IR 116mA | ❌ **เกินพิกัด ~10 เท่า** → หน้าสัมผัสไหม้/เชื่อมติด |
| อายุใช้งาน | ~100,000 ครั้ง (ที่โหลด logic-level) | สวิตช์กำลัง | ❌ ลดฮวบเมื่อใช้เกินพิกัด |

แหล่งข้อมูลระบุตรงๆ ว่าเหมาะกับ *"logic-level circuits and microcontroller applications rather than direct power switching"*

**ทางแก้ (เลือกอย่างใดอย่างหนึ่ง):**
1. เปลี่ยนเป็น **slide switch / latching switch** ที่รับได้ ≥1A (เช่น SS-12D00 series) — ง่ายสุด
2. เก็บ tact switch ไว้แต่ให้ไปคุม **P-MOSFET high-side** แทน (SW2 → gate driver → MOSFET ตัดไฟ) — กระแสไหลผ่าน MOSFET ไม่ผ่านสวิตช์
3. ถ้าไม่ได้ตั้งใจให้มีสวิตช์ตัดไฟ ให้ลัด VIN↔5V ตรงๆ แล้วเอา SW2 ออก

**หมายเหตุที่ออกแบบถูกแล้ว:** `R7.1` (ตัวป้อน VDD ของ CH221K) อยู่ฝั่ง **VIN คือก่อนสวิตช์** → ชิป PD ยังมีไฟตอนสวิตช์ปิด ทำให้เจรจา PD ได้ปกติ ✅ ถูกต้อง

---

## B2 — บัซเซอร์จะดังตลอดเวลา ปิดไม่ได้ (ยังคงอยู่)

**Netlist:** `5V ; ... U1.1 ...` · `GND ; ... U1.2 ...` · `GPIO14 ; U1.3 U5.37 U5.38` — **ยืนยันว่ายังไม่ได้แก้**

โมดูล Active Buzzer ขับด้วย **S8550 = PNP** ต่อ high-side + active-LOW

| GPIO14 | V_EB | ผล |
|---|---|---|
| LOW (0V) | 5.0V | ดัง (ตามต้องการ) |
| HIGH (3.3V) | **1.7V** > V_BE(on) 0.7V | **ยังดังอยู่** |

**แก้:** ย้าย `U1.1` จาก net `5V` → `3V3` (สเปกโมดูลรองรับ 3.3V)

---

## B3 — ขั้ว OLED สลับ เสียบแล้วจอพัง (ยังคงอยู่)

**Netlist:** `3V3 ; P1.1 ...` · `GND ; ... P1.2 ...` · `GPIO01 ; P1.3 ...` · `GPIO42 ; P1.4 ...`

| ตำแหน่ง | P1 บนบอร์ด | โมดูล SSD1315 | ผล |
|---|---|---|---|
| 1 | 3V3 | **GND** | ❌ |
| 2 | GND | **VCC** | ❌ |
| 3 | GPIO1 | SCL | ✅ |
| 4 | GPIO42 | SDA | ✅ |

**แก้:** สลับ P1 pin1 ↔ pin2

---

## B4 — ไม่มีรูสกรู M3

ทั้งบอร์ดมีรูเจาะ ≥2mm อยู่ **รูเดียว** คือ MOUNT1 (⌀7.5mm ขาตั้งกระจก)

**แก้:** เพิ่ม pad non-metallized ⌀3.2mm ที่ 4 มุม เว้นขอบ ~3.5mm

---

# ❓ ต้องยืนยันเจตนา

## Q1 — ปุ่ม USER หายไปจากดีไซน์

`GPIO41 ; U6.11 U6.12` — เหลือแค่ขา header ไม่มีอะไรต่อ

ดีไซน์เดิมเคยมี `SW1` + `R10` (pull-up 10k) + `C5` (debounce 100nF) บน GPIO41 แต่**ตอนนี้ไม่มีทั้ง 3 ตัวแล้ว** ทั้งใน Schematic1 และ PCB1_1

ตั้งใจเอาออกเพื่อเปลี่ยนไปใช้ SW2 เป็นสวิตช์ไฟแทนหรือเปล่า? ถ้ายังต้องการปุ่มสั่งงาน ต้องเพิ่มกลับเข้าไป (GPIO41 ว่างอยู่ ใช้ได้เลย)

---

# 🟡 WARNING

| # | หัวข้อ | รายละเอียด | ข้อเสนอ |
|---|---|---|---|
| W1 | **LED1 หรี่มาก** | KT-0805G เขียว Vf 2.6–3.1V + R11 470Ω → **0.96mA** (แย่สุด 0.43mA) สเปกใช้ที่ 5mA | ลด R11 → **100–150Ω** |
| W2 | **ไม่มี bulk cap บนราง 5V** | ราง 5V เลี้ยงโมดูล WiFi (พีค ~500mA) + IR พัลส์ 116mA + บัซเซอร์ แต่ไม่มี cap เลย (C1 อยู่ที่ VDD ของ CH221K, C2 = ฟิลเตอร์ LDR) | เพิ่ม **10–100µF + 100nF** ใกล้ U5.39/40 |
| W3 | **ไม่มี decoupling บนราง 3V3** | 3V3 เลี้ยง OLED + pull-up + LDR | เพิ่ม **100nF + 10µF** ใกล้ P1 |
| W4 | **ไม่มี Net Class เลย** | `pcb_Drc.getNetByNetRules()` → `{"Safe Spacing":[], "Creepage Distance":[]}` — ว่างเปล่า | สร้าง POWER = {VIN, 5V, 3V3, GND} @ 0.80mm |
| W5 | **track power ไม่ถึง 0.80mm** | 5V/VIN = 0.61mm · 3V3 = 0.486/0.61 · CC1/CC2 = 0.479/0.61 · **GND ปนกัน 3 ค่า (0.479/0.585/0.61)** | ตั้ง Net Class แล้ว re-route |
| W6 | **มุม 90° 3 จุด** (อยู่บนราง 5V ทั้งหมด) | (881, −2905) · (2337, −2480) · (2332, −1929) หน่วย mil | แก้เป็น 45° |
| W7 | มุมองศาแปลก 1 จุด | ไม่ใช่ทั้ง 45° และ 90° | ตรวจและแก้ |
| W8 | **GPIO3 เป็น strapping pin** | ESP32-S3 strapping = GPIO0, **GPIO3**, GPIO45, GPIO46 — มี LDR divider คาอยู่ | ไม่กระทบ boot mode (เสี่ยงต่ำ) — ถ้าย้ายได้ใช้ GPIO41 (ว่างแล้ว) หรือ GPIO47 |
| W9 | **ใช้ขา JTAG 2 เส้น** | GPIO40 = MTDO (LED2), GPIO42 = MTMS (I2C) | debug ผ่าน JTAG ไม่ได้ — ถ้าโปรแกรมผ่าน USB ก็ไม่มีปัญหา |
| W10 | **IR ส่องไม่แรงนัก** | TSAL6200 ให้ 40mW/sr @100mA แต่ขับที่ ~29mA → ~11mW/sr | ถ้าระยะ 50–70cm ไม่พอ ค่อยลด R16–19 |

---

# 🟢 PASS — ตรวจแล้วถูกต้อง

## โครงสร้าง PCB1_1

| รายการ | ค่าที่วัดได้ | ผล |
|---|---|---|
| **Board outline** | polyline layer 11, สี่เหลี่ยม `R 285,−610,2305,2585` mil = **58.55 × 65.66 mm** | ✅ **มีจริง** |
| Copper pour GND | POUR1 (Top) + POUR2 (Bottom) กรอบเท่ากับ outline เป๊ะ | ✅ |
| ชิ้นส่วนอยู่ในกรอบบอร์ด | bbox ชิ้นส่วน 10.9–61.1mm × −21.7 ถึง −77.0mm — **ไม่มีตัวไหนหลุดออกนอก outline** | ✅ |
| MOUNT1 (ขาตั้งกระจก) | ⌀7.5mm, pad 8.99mm @ (35.6, −72.5)mm — กึ่งกลางแนวนอนพอดี, ห่างขอบล่าง 8.6mm | ✅ |
| MOUNT1 clearance | ห่าง track ใกล้สุด **2.58mm** (net 5V) | ✅ ปลอดภัย |
| Routing | 321 track (layer 1: 206, layer 2: 115) + 29 via — **ทุก net มีความยาว > 0 ไม่มี net ค้าง** | ✅ |
| มุม 45° | 195 จาก 199 จุด (98%) | ✅ |
| via | 29 ตัว ขนาดเดียวกันหมด | ✅ |

## การจ่าย GPIO — ไม่ชนขากล้องแม้แต่ขาเดียว

| GPIO | ใช้ทำอะไร | สถานะบนโมดูล | ผล |
|---|---|---|---|
| 1 | I2C → OLED | ADC1_CH0 / T1 | ✅ |
| 3 | LDR (ADC) | JTAG EN / **strapping** / **ADC1_CH2** | ⚠️ ดู W8 — แต่เป็น **ADC1** ใช้ร่วมกับ WiFi ได้ ✅ |
| 14 | บัซเซอร์ | ว่าง | ✅ |
| 21 | ขับ IR ผ่าน Q3 | ว่าง | ✅ |
| 40 | LED2 | SD_DATA / MTDO | ✅ |
| 42 | I2C → OLED | MTMS | ✅ |
| 47 | LED1 | ว่าง | ✅ |

**ปล่อยว่างถูกต้องครบ:** GPIO4–13, 15–18 (ขากล้อง CAM_*) · 35/36/37 (PSRAM octal) · 19/20 (USB D±) · 43/44 (UART0) · 0/45/46 (strapping) · 48 (WS2812) · 2 (LED ON) · **41 (ว่างแล้ว)**

## วงจรขับ IR — คำนวณผ่านทุกจุด

`5V → R16-19 (120Ω) → IR1-4 → Q3.3 (C) → Q3.2 (E) → GND`, `GPIO21 → R3 1kΩ → Q3.1 (B)`

| รายการ | คำนวณ | เกณฑ์ | ผล |
|---|---|---|---|
| กระแสต่อดวง | (5 − 1.35 − 0.15)/120 = **29mA** | TSAL6200 If max 100mA | ✅ |
| กำลังที่ R16–19 | 0.029² × 120 = **0.10W** | R1206 = 0.25W | ✅ |
| Ic รวมที่ Q3 | **116mA** | SS8050 Ic max 1.5A | ✅ |
| forced β | 116 / 2.55mA = **45** | hFE 200–350 | ✅ อิ่มตัวสบาย |
| Pd ที่ Q3 | ~17mW | max 300mW | ✅ |

## USB-PD

| รายการ | ผล |
|---|---|
| **R6 = 10kΩ (CFG→VDD) = ขอ 5V** | ✅ ถ้าใส่ผิดเป็น 20k/47k จะขอ 9V/12V แล้วเผาทั้งโมดูลและ IR |
| CH221K ขาครบ `1=VDD 2=GND 3=PG 4=CC1 5=CC2 6=CFG` | ✅ ขา 3 = Power Good ติดธง No-Connect ตั้งใจ |
| R8/R9 = 5.1kΩ บน CC1/CC2 | ✅ Rd มาตรฐาน sink |
| R7 1kΩ + C1 1µF ที่ VDD | ✅ ตรงวงจรอ้างอิง |
| USB1 A9 + B9 อยู่บน net VIN ทั้งคู่ | ✅ **แก้แล้ว** (รอบก่อนแยกเป็น 2 net) |

## วงจรอื่น

| วงจร | ผล |
|---|---|
| **LDR** `3V3 → R1 10k → GPIO3 → GL5528 → GND` + C2 100nF | ✅ สว่างจัด ≈0.3V, 10 lux ≈2.0V, มืด ≈3.27V, RC = 1ms |
| **I2C pull-up** R4/R5 = 4.7kΩ | ✅ |
| **LED2** แดง R12 470Ω → 2.55mA | ✅ |
| **GND** ครบทุกจุดรวม USB1.A12 + B12 | ✅ |

---

# รอบตรวจเพิ่มเติม — Manufacturing & Mechanical (PCB1_1)

## ✅ ผ่าน

| การตรวจ | ค่าที่วัดได้ | เกณฑ์ | ผล |
|---|---|---|---|
| **Track → ขอบบอร์ด** | ต่ำสุด **0.637mm** (net GPIO3, layer 1 @ 41.5, −16.4mm) | design rule 0.30mm | ✅ |
| **Via → ขอบบอร์ด** | ต่ำสุด **4.06mm** (net CC1) | 0.30mm | ✅ |
| **Pad → ขอบบอร์ด** | ต่ำสุด **0.683mm** (ขายึด USB1) | 0.30mm | ✅ |
| **Silkscreen** | 140 ชิ้น (string 47 + attribute 93) **อยู่บน Top Silkscreen ทั้งหมด ไม่มีตกไปชั้นล่าง** | — | ✅ |
| **Copper pour → ขอบบอร์ด** | กรอบ pour วาดทับ outline พอดี แต่ design rule Copper Zone→Board Outline = 10 mil และ DRC ผ่าน | 10 mil | ✅ (ยืนยันจาก gerber อีกทีจะชัวร์กว่า) |
| **กระแสที่ราง 5V รับได้** | track 0.61mm บน 1oz → **~1.65A** (IPC-2221, ΔT 10°C) | ต้องการพีค ~0.7A | ✅ เหลือเฟือ |

## ✅ ไม่มีชิ้นส่วนชนใต้โมดูล — จุดนี้ออกแบบดีมาก

โมดูลเสียบบน header (insulation height 8.5mm) → แผ่น PCB ของโมดูลลอยสูงจากบอร์ดเรา **~8.5mm**

ชิ้นส่วน **14 ตัว** ที่อยู่ใต้เงาโมดูล (x 20.32–50.80mm, y −66.04 ถึง −17.78mm) เป็น **SMD ล้วน**:
`Q1 · Q3 · C1 · C2 · R3 · R4 · R5 · R6 · R8 · R9 · R11 · R12` (0402/0603/0805/SOT-23 สูงสุด ~1.3mm) + `U5 · U6` เอง

ชิ้นส่วนสูงทุกตัวถูกวางนอกเงาโมดูลหมด: `IR1–4` (5mm TH, x=61mm) · `R2` LDR · `P1` · `U1` · `USB1` (x≈11–13mm) ✅

---

## ⚠️ ประเด็นเชิงกล — ต้องวัดโมดูลจริงยืนยัน

**ตัวเลขที่วัดได้จากบอร์ด:**

| จุด | พิกัด y | ระยะจาก pin ล่างสุดของ header (y = −66.04mm) |
|---|---|---|
| pin ล่างสุดของ header | −66.04mm | 0 |
| **MOUNT1** (รูขาตั้ง ⌀7.5mm) | −72.50mm | **6.46mm** |
| **SW2** | −73.80mm | **7.76mm** |
| ขอบล่างบอร์ด | −81.15mm | 15.11mm |

- header span = **48.26mm** (2×20 pin, pitch 2.54mm) แต่โมดูล ESP32-S3-CAM ยาว **67mm** → มีตัวโมดูล **18.74mm ที่ยื่นเลย pin ออกไป** (แบ่งไปหัว-ท้ายอย่างไรขึ้นกับตำแหน่ง pin บนโมดูล)

**🔺 ความเสี่ยง: ถ้าโมดูลยื่นเลย pin ล่างสุดเกิน 6.46mm ตัวโมดูลจะบังรู MOUNT1 → เสียบสกรูขาตั้งกระจกไม่ได้** และถ้าเกิน 7.76mm จะกดทับ SW2 ด้วย

หมายเหตุใน `CLAUDE.md` เคยบันทึกว่าวัดจริงแล้วโมดูลยื่นเลย header **~2mm** — ถ้าเป็น 2mm ที่ปลายล่าง ก็**ปลอดภัย** แต่ตัวเลข 67mm vs 48.26mm บอกว่ารวมสองด้านต้องยื่น 18.74mm จึงควรวัดซ้ำว่า **แต่ละด้านยื่นเท่าไหร่**

**วิธีเช็คเร็วที่สุด:** วัดจากรูพินล่างสุดของโมดูลถึงขอบล่างสุดของแผ่นโมดูล ถ้า **< 6.4mm** ผ่าน

- ด้านบน: pin บนสุด (y = −17.78mm) ห่างขอบบอร์ดบนแค่ **2.29mm** → โมดูลจะยื่นพ้นขอบบอร์ดด้านบนแน่นอน (ปกติไม่เป็นปัญหาเพราะลอยอยู่ในอากาศ แต่ต้องเผื่อพื้นที่ตอนติดตั้งจริง)

## ⚠️ silkscreen ใกล้ pad

ข้อความ `USB1` ที่ (13.9, −28.1)mm อยู่ใกล้ pad `13` ของ USB1 มาก
**ความมั่นใจต่ำ** — วิธีตรวจของผมใช้ระยะจากจุดยึดข้อความ ไม่ได้คำนวณกล่องตัวอักษรจริง แนะนำซูมดูด้วยตา

---

# แก้ข้อมูลเดิม (`REVIEW_2026-08-14.md`)

| ข้อเดิม | สถานะ |
|---|---|
| "ไม่มี board outline" | ❌ **ผิด** — PCB1_1 มี outline จริง (58.55×65.66mm) รอบก่อน query ตอน canvas เป็น schematic ทำให้ API คืน error แล้วผมตีความว่า "ไม่มี" |
| "B3 designator C3/C5 ไม่ตรง" | ❌ **ไม่ใช่ปัญหา** — Schematic1 ↔ PCB1_1 ตรงกัน 100% ข้อมูล `C3` มาจาก **PCB1** ซึ่งเป็นไฟล์กำพร้าคนละตัว |
| "วงจรปุ่ม SW1 + R10 + C5" | ❌ ไม่มีอยู่ในดีไซน์ปัจจุบันแล้ว → กลายเป็นคำถาม Q1 |
| "W5 VBUS แยกเป็น 2 net" | ✅ **แก้แล้ว** — ตอนนี้ A9 + B9 อยู่บน VIN ทั้งคู่ |
| "W8/W9 R10/SW1 ไม่มีรหัส LCSC" | — ตกไปเพราะไม่มีชิ้นส่วนนี้แล้ว |
| B1 บัซเซอร์ / B2 OLED | ✅ **ยังจริงทั้งคู่** ยืนยันซ้ำจากเน็ตลิสต์ปัจจุบัน |

**สาเหตุรากของความสับสน:** easyeda-agent MCP กับ raw bridge เกาะคนละหน้าต่าง EasyEDA และโปรเจกต์มี PCB 2 ไฟล์ → ข้อมูลปนข้ามเอกสารโดยไม่มีสัญญาณเตือน
**วิธีป้องกัน:** เรียก `eda.dmt_SelectControl.getCurrentDocumentInfo()` ยืนยัน uuid ทุกครั้งก่อนเชื่อข้อมูล

---

# ลำดับการแก้ที่แนะนำ

1. **B1** SW2 — ตัดสินใจก่อนว่าจะเอาสวิตช์ไฟไหม (ถ้าไม่เอา ลัด VIN↔5V ง่ายสุด)
2. **B2** ย้าย U1.1 → 3V3
3. **B3** สลับ P1 pin1 ↔ pin2
4. **Q1** ตัดสินใจเรื่องปุ่ม USER
5. **W1** ลด R11 → 100–150Ω · **W2/W3** เพิ่ม cap
6. **B4** เพิ่มรู M3 4 มุม
7. **W4/W5** ตั้ง Net Class POWER 0.80mm แล้ว re-route
8. **W6/W7** แก้มุม 90° 3 จุด + มุมแปลก 1 จุด
9. รัน DRC/ERC ใหม่ → ลบ `PCB1` ทิ้ง

## แหล่งอ้างอิงเพิ่ม
- [TS-1088-AR02016 @ LCSC C720477](https://www.lcsc.com/product-detail/C720477.html) — 50mA/12VDC, momentary SPST-NO
- [TS-1088-AR02016 datasheet — GlobalSpec](https://datasheets.globalspec.com/ds/dongguan-xunpu-electronic-technology/ts-1088-ar02016/4c712a43-5dfc-4fbd-9ca2-f0bc9b29c043)
