Franknakub/driver-drowsiness-detection/GLOSSARY.md

# Driver Drowsiness Detection

อุปกรณ์ติดในรถที่เฝ้าดวงตาของคนขับ เตือนเมื่อมีอาการง่วง และเก็บประวัติให้คนขับย้อนดูทีหลัง

## ผู้เกี่ยวข้องและอุปกรณ์

**Device**:
อุปกรณ์ 1 ชุด ประกอบด้วย PCB และโมดูล ESP32-S3-CAM ติดตั้งอยู่ในรถ 1 คัน
_Avoid_: บอร์ด (ถ้าหมายถึงทั้งชุด), ตัวเครื่อง

**Driver**:
คนขับที่ Device เฝ้าดู และเป็นคนเดียวกับที่เปิดดูประวัติของตัวเอง โดย 1 Device มี 1 Driver
_Avoid_: ผู้ใช้, user (ใช้ได้เฉพาะตอนพูดถึงหน้าเว็บ)

## การเฝ้าดู

**Eye Region**:
กรอบสี่เหลี่ยมรอบตาข้างหนึ่งในภาพจากกล้อง ซึ่งเป็นส่วนที่ถูกตัดออกมาส่งให้โมเดลตัดสิน Eye State
_Avoid_: ROI, กรอบ crop

**Eye State**:
ผลตัดสินต่อเฟรมว่าตาใน Eye Region เปิด ปิด ไม่แน่ใจ หรือมองไม่เห็น
_Avoid_: สถานะตา (ถ้าหมายถึง Drowsiness Level)

**PERCLOS**:
สัดส่วนเวลาที่ตาปิดในหน้าต่างเวลาย้อนหลังที่กำหนด (ค่าเริ่มต้น 60 วินาที)
_Avoid_: P80, อัตราการปิดตา

**Drowsiness Level**:
ระดับความง่วง ณ ขณะหนึ่ง มี 4 ระดับ: 0 ปกติ, 1 เริ่มล้า, 2 ง่วง, 3 Microsleep
_Avoid_: ระดับเตือน, alert level, stage

**Microsleep**:
ตาปิดต่อเนื่องนานถึงเกณฑ์ (ค่าเริ่มต้น 3 วินาที) และเป็น Drowsiness Level 3
_Avoid_: หลับ, sleep

**Distraction**:
ช่วงที่มองไม่เห็นตาใน Eye Region ต่อเนื่องนานถึงเกณฑ์ เช่น หันหน้าออกหรือก้มดูมือถือ นับแยกจากความง่วง
_Avoid_: No Face, NO_FACE, ไม่เจอหน้า

**Unmonitored**:
ช่วงที่เห็นหน้า Driver แต่ตัดสิน Eye State ไม่ได้ต่อเนื่องนานถึงเกณฑ์ เช่น ใส่แว่นดำ หรือภาพมืด/สว่างเกินไป ระหว่างนั้นไม่มี Alert เรื่องความง่วง
_Avoid_: ตรวจไม่ได้ (ใช้ได้เฉพาะเป็นข้อความบนจอ), error, Distraction

## การเตือนและประวัติ

**Alert**:
การเตือนที่ Device ส่งออกไปยัง Driver ผ่าน buzzer, LED หรือ OLED ขณะกำลังขับ
_Avoid_: แจ้งเตือน (ถ้าหมายถึงข้อความที่ส่งเข้ามือถือ)

**Trip**:
ช่วงเวลาตั้งแต่ Device ได้รับไฟจนถึงไฟถูกตัด เป็นหน่วยของประวัติ
_Avoid_: session, การขับ, รอบ

**Sample**:
ค่าสรุปประจำ 1 วินาทีภายใน Trip (Eye State, PERCLOS, Drowsiness Level, ความสว่าง, สถานะ IR)
_Avoid_: log line, record

**Event**:
สิ่งที่เกิดขึ้น ณ จุดเวลาหนึ่งใน Trip เช่น Drowsiness Level เปลี่ยน, เกิด Microsleep หรือเกิด Distraction
_Avoid_: incident, เหตุการณ์ (ถ้าหมายถึง Sample)

**Trip Summary**:
ตัวเลขสรุปของ Trip หนึ่ง เช่น เวลาขับ, สัดส่วนเวลาที่ง่วง, จำนวน Microsleep และตาปิดนานที่สุด
_Avoid_: report, รายงานทริป

**Sync**:
การส่ง Sample, Event และ Trip Summary ที่ยังไม่เคยส่ง จาก Device ขึ้น cloud เมื่อ Device ต่อเน็ตได้
_Avoid_: upload, backup

**Device Dashboard**:
หน้าเว็บที่ Device เสิร์ฟเอง ใช้ดูสถานะสด ตั้งค่า และดู Trip ที่ยังไม่ได้ Sync
_Avoid_: local web, หน้าเว็บบนบอร์ด

**Cloud Dashboard**:
หน้าเว็บบน cloud ที่ Driver ใช้ดูประวัติทุก Trip และแนวโน้มข้าม Trip
_Avoid_: web app, หน้าประวัติ
