Franknakub/driver-drowsiness-detection/docs/STATUS.md

# สถานะโปรเจกต์ — ทำอะไรไปแล้ว · เหลืออะไร

สถานะ ณ **3 พ.ย. 2026** · กำหนดส่ง **3–5 พ.ย. 2026** · ⚠️ ส่วนที่ 1 (ทำเสร็จแล้ว) ยังเป็นข้อมูล 23 ต.ค. เป็นหลัก มีเติมแค่ไทม์ไลน์ 27 ต.ค.–3 พ.ย.

| | ตอนนี้ |
|---|---|
| บนบอร์ด | DrowsyFW **0.3.8-oled-info** (แฟลช 3 พ.ย.) |
| PCB | **v2** = บอร์ดสุดท้าย · ทดสอบฮาร์ดแวร์ผ่านครบ 23 ต.ค. |
| Cloud Dashboard | <https://franknakub.github.io/driver-drowsiness-detection/dashboard/> (GitHub Pages จาก `main` /docs) |
| branch ที่ทำงาน | `main` = งานเพื่อน (PR #6) + จอ OLED 0.3.7 (PR #7) · `oled-info` = จอ OLED 0.3.8 · `firmware` = งานเก่า เก็บไว้อ้างอิง |
| Supabase | โปรเจกต์ `iatzjmxj…` (ของเพื่อน) · บอร์ดต้องลงทะเบียนใหม่ใน Cloud Dashboard |

```
OV5640 → ESP-DL หาหน้า → ตัดตา 32×32 → CNN INT8 → Eye State
  → logic ความง่วง (PERCLOS, ระดับ 1–3, Distraction, Unmonitored) → buzzer / LED
  → ประวัติ Trip บน FFat → Sync ขึ้น Supabase → Cloud Dashboard
```

ไฟล์นี้เป็นสรุป รายละเอียดอยู่ในไฟล์ที่ลิงก์ไว้ในหัวข้อ [ข้อมูลละเอียดอยู่ที่ไหน](#ข้อมูลละเอียดอยู่ที่ไหน)

---

## ส่วนที่ 1 — ทำเสร็จแล้ว

### ไทม์ไลน์

| วันที่ | สิ่งที่เสร็จ |
|---|---|
| 31 ส.ค. | PCB v1 ผลิตแล้ว · พบว่า header ของโมดูลเป็นภาพกระจก (5V↔GND สลับ) → **ห้ามเสียบโมดูลแล้วจ่ายไฟ** ใช้วัดขนาดและทดสอบอุปกรณ์รอบตัวด้วยการต่อสาย |
| 3 ต.ค. | สั่งผลิต PCB v2 (PCB 5 + ประกอบสำเร็จ 2 แผ่น) · DRC 0 error · แก้ป้าย H2 เป็น 3V3 |
| 7 ต.ค. | ทำ v3 (ย้าย R3, R11 = 100Ω) ใน EasyEDA · **ตัดสินใจไม่สั่งผลิต** (23 ต.ค.) |
| 8 ต.ค. | DrowsyFW รุ่นแรก (PlatformIO, MobileNetV2 96×96 ~3 fps) จาก PR #1 · ภายหลังย้ายไป `firmware/archive/DrowsyFW-pio/` |
| 16 ต.ค. | ออกแบบ firmware: [GLOSSARY.md](../GLOSSARY.md), ADR 0001–0003 · ผังต่อสายบอร์ด v1 + สเก็ตช์ `BenchTest` |
| 17 ต.ค. | ทดลอง ESP-DL หาหน้าผ่าน · โครง DrowsyFW (partition custom, แบ่ง task ตาม core, OTA ผ่านเว็บ) · 0.2.3 หาหน้า + โมเดลตา + ภาพสด |
| 18 ต.ค. | 0.2.5 หมุนภาพรวมในขั้นหาหน้า + โมเดล `deep2_half` · ML pipeline + เทสต์ preprocess · CAD กล่อง + ส่งร้านปริ้น · 0.2.8–0.2.9 logic ความง่วง · 0.3.1 ประวัติ Trip + Sync Supabase + Cloud Dashboard · 0.3.2–0.3.3 แก้เตือนผิดจาก Trip #411 / #412 |
| 19 ต.ค. | 0.3.4 ปลดระดับที่ค้างเมื่อไม่เห็นตานาน (Trip #413) |
| 22 ต.ค. | merge PR #2 (`firmware` → `main`) · GitHub Pages เปลี่ยนไปดึงจาก `main` /docs |
| 23 ต.ค. | ได้รับ PCB v2 และทดสอบฮาร์ดแวร์ผ่านครบ · ปิดเรื่องทดสอบ IR-cut filter |
| 27 ต.ค. | (เพื่อน) 0.3.5-hw: จอ OLED แบบดีบัก, โหมด IR auto/on/off, ปุ่มทดสอบฮาร์ดแวร์บนเว็บ, ปุ่ม BOOT ปิดเสียง, Device Dashboard ใหม่ · ย้ายไป Supabase โปรเจกต์ใหม่ · `samples.ldr` เป็น integer · Cloud Dashboard สำหรับผู้ใช้ทั่วไป (คะแนนความปลอดภัย 0–100, คำแนะนำ, ลบ Trip ได้) · (เรา) ทดสอบห้องมืด: IR บนบอร์ดอ่อนเกินสำหรับกลางคืน |
| 28 ต.ค. | (เพื่อน) 0.3.6-wifi: หน้า `/wifi` สแกน/เพิ่ม/ลบ WiFi เก็บใน NVS |
| 2 พ.ย. | revert OLED/camtest ของเราออกจาก `main` (PR #5) แล้ว merge งานเพื่อนเข้า `main` (PR #6) · 0.3.7-oled: จอสำหรับคนขับ แสดงทีละหน้า (branch `oled-phases`) |
| 3 พ.ย. | merge 0.3.7-oled เข้า `main` (PR #7) · 0.3.8-oled-info: จอหน้าเดียว สถานะ + ตา + เสียง + ชื่อ AP + URL · แฟลชและทดสอบบนบอร์ดผ่าน |

### Firmware (DrowsyFW)

| ส่วน | สถานะ | รายละเอียด |
|---|---|---|
| โครงระบบ | ✅ | ESP32-S3 N16R8 · Arduino core esp32 3.3.12 · partition app 6 MB × 2 + FFat 3.9 MB · Core 1 = vision/alert/sensor · Core 0 = net/log/sync/เว็บ |
| หาหน้า | ✅ | ESP-DL HumanFaceDetect · หมุนภาพ 270° รวมในขั้น preprocess (rotate + detect 82.7 → 52 ms) · ~7 fps ที่ HVGA |
| โมเดลตา | ✅ | ตัดตาด้าน 0.8 × ระยะระหว่างตา → 32×32 int8 → CNN → P(ตาปิด) |
| logic ความง่วง | ✅ โค้ด + เทสต์ | นับเป็นเวลา (ไม่นับเฟรม) · PERCLOS 60 วิ (ระดับ 1 ≥15%, ระดับ 2 ≥25%) · ตาปิดต่อเนื่อง 1.5 วิ = ระดับ 2, 3 วิ = ระดับ 3 (Microsleep) · Distraction เมื่อไม่เห็นตา ≥3 วิ · Unmonitored เมื่อไม่แน่ใจ ≥5 วิ |
| การเตือน | ✅ โค้ด | ระดับ 1 = LED แดงกะพริบ · ระดับ 2 = buzzer เป็นจังหวะ (ปิดเสียงได้) · ระดับ 3 = buzzer ยาว (ปิดเสียงไม่ได้) · Distraction = เสียงสั้น |
| ประวัติ Trip | ✅ | บันทึกลง FFat ทุก 1 วิ + Event + Trip Summary · ลบ Trip ที่ Sync แล้วเมื่อเต็ม 80% · หน้า `/trips` |
| Sync | ✅ | ส่งขึ้น Supabase ผ่าน RPC `ingest` ทีละ ≤300 Sample · Trip ปัจจุบันส่งทุก 30 วิ |
| Device Dashboard | ✅ บางส่วน | สถานะสด · ภาพสดพร้อมกรอบหน้า/ตา · ภาพตา 32×32 ที่เข้าโมเดล · ปุ่มปิดเสียง |
| OTA | ✅ | อัปโหลด firmware ผ่าน `/update` |
| เทสต์บน PC | ✅ | `drowsiness_test.cpp` 102 ข้อ (รวม Trip #411, #412) · `trip_record_test.cpp` 34 ข้อ |

**แก้การเตือนผิดที่เจอบนบอร์ดจริง**

| เวอร์ชัน | ปัญหา | วิธีแก้ |
|---|---|---|
| 0.2.9 | เปิดเครื่องตอนยังไม่มีคนนั่งแล้วเตือน Distraction | เริ่มนับ Distraction หลังเห็นตาครั้งแรก · หยุดเตือนเมื่อไม่เห็นใครนาน 60 วิ |
| 0.3.2 | Trip #411: Microsleep ผิด เพราะนำเฟรมที่ไม่เห็นตาหรือไม่แน่ใจมาต่อเป็นตาปิด | นับตาปิดต่อเนื่องเฉพาะเมื่อมีเฟรมตาปิดจริงเป็นส่วนใหญ่ |
| 0.3.3 | Trip #412: ก้มหน้าแล้วเตือนผิด | ต้องเห็นหน้า ≥40% ของช่วงที่นับว่าตาปิด |
| 0.3.4 | Trip #413: ระดับค้างตอนคนขับไม่อยู่ | ไม่เห็นตานานเกิน 60 วิ ปลดระดับ 2 · นานเกิน 5 นาที ปลดระดับ 3 |

### ML

| รายการ | ผล |
|---|---|
| โมเดล `deep2_half` | 18,409 พารามิเตอร์ · 27.5 KB · train จากชุดข้อมูล MRL แบ่งตามคน |
| ความแม่นบนชุดทดสอบ MRL | 96.2% · จับตาปิดได้ 94.3% |
| บนบอร์ดจริง | จับตาปิดได้ 14/17 ครั้ง · **ตาซ้ายของภาพ (ไกลกล้อง) ตอบว่าปิดถูกแค่ 19–29%** |
| ทดลอง fine-tune ด้วยภาพที่โต๊ะ | ตาซ้ายดีขึ้นเป็น 93–95% · **ไม่ได้ใช้จริง** เพราะตัดสินใจให้โมเดลที่ใช้งานจริง train ด้วยภาพในรถเท่านั้น |
| preprocess | Python กับ C ให้ผลตรงกันทุกไบต์ (`ml/test_preprocess.py`) |

### Cloud

| รายการ | สถานะ |
|---|---|
| Supabase (Singapore) | ✅ ตาราง devices / trips / samples / events · view `trip_summary` · RLS · ดู [cloud/README.md](../cloud/README.md) และ ADR 0003 |
| Sync จากบอร์ดจริง | ✅ Trip #410 ขึ้น cloud และ Summary ตรงกับบนบอร์ด |
| Cloud Dashboard | ✅ login ด้วยอีเมล · รายการ Trip · กราฟราย Trip |

### ฮาร์ดแวร์ PCB v2 (ทดสอบ 23 ต.ค.)

ผ่าน: บูต · กล้อง · IR LED ×4 · buzzer · LED เขียว/แดง · LDR · OLED (เจอที่ 0x3C) · รับไฟผ่าน USB-C บน PCB + SW1 · WiFi + Sync · ความร้อนที่อุณหภูมิห้อง

- **SW1:** ขวา = ON, ซ้าย = OFF (มองจากด้านบน โมดูลกล้องหงาย)
- **กล้องเห็น IR 940 nm** (ไม่มี IR-cut) เปิด IR แล้วภาพสว่างขึ้น +12 / +31 ระดับ · ยังไม่ได้ทดสอบที่ระยะหน้าคนขับ
- **LDR:** ห้องมืด ~2900–3000 · ปิดด้วยมือ ~3900–4095 · ห้องสว่าง ~500–700

### กล่อง 3D

| รายการ | สถานะ |
|---|---|
| CAD (build123d) | ✅ ตรวจการชนผ่าน · ค่าทุกตัวมาจากการวัดบอร์ดจริง |
| การติดตั้ง | ✅ ตัดสินแล้ว: ขาดูดกระจก เกลียว 1/4"-20 · ติดด้านซ้ายคนขับ ใกล้กระจกมองหลัง · กล่องแนวนอน แถว IR อยู่บน |
| ปริ้น | ✅ ส่งร้านแล้ว (ASA ดำ) · ไฟล์ชุดที่ส่งอยู่ใน `enclosure/print_2026-10-18/` |
| อะไหล่ | ✅ ซื้อครบ: insert M3, สกรู, ประแจหกเหลี่ยม, กระดาษทรายน้ำเบอร์ 600 |

---

## ส่วนที่ 2 — งานที่เหลือ

**สถานะ:** 🔴 ยังไม่เริ่ม · 🟡 รอสิ่งอื่นก่อน · 🟠 รอผู้ใช้ตัดสินใจ · ⚪ ไม่รีบ / ทำหรือไม่ทำก็ได้ · ✅ เสร็จ

### 1. ทดสอบในรถและโมเดล (สำคัญที่สุด)

| # | งาน | สถานะ | อธิบาย | ใครทำ |
|---|---|---|---|---|
| 1.1 | เก็บภาพตาในรถตอนจอด | 🔴 | โมเดลตอนนี้ train จาก MRL ซึ่งพลาดกับกล้องเรา ต้องใช้ภาพจริงจากตำแหน่งติดกระจก · สคริปต์เก็บภาพเตรียมไว้แล้ว | ผู้ใช้ |
| 1.2 | ทดสอบหาหน้าจากมุมกล้องจริง | 🔴 | กล้องบนกระจกอยู่สูงกว่าตาและมองลง มุมนี้ยังไม่เคยลอง ถ้าหาหน้าไม่เจอ ระบบทั้งหมดก็ใช้ไม่ได้ · ทำพร้อม 1.1 | ผู้ใช้ |
| 1.3 | fine-tune โมเดลแล้วใส่ลงบอร์ด | 🟡 รอ 1.1 | train ต่อจากโมเดลเดิมด้วยภาพในรถเท่านั้น | Claude |
| 1.4 | ปรับเกณฑ์จากข้อมูลจริง (วิธี ข) | 🟡 รอ 1.1 | เกณฑ์ส่วนใหญ่ตั้งไว้ที่โต๊ะ ต้องเล่นข้อมูลในรถซ้ำเพื่อหาค่าที่เตือนพลาดน้อยสุด | Claude |
| 1.5 | คาลิเบรต LDR ในรถ | 🔴 | ห้องมืดอ่านได้ ~2900 ส่วนเกณฑ์เปิด IR คือ 2800 · ในรถกลางวันกับกลางคืนอาจต่างจากนี้มาก | ผู้ใช้วัด · Claude แก้ค่า |
| 1.6 | ขับจริง 20–30 นาที | 🟡 รอ 1.3 + 4.1 | ทดสอบว่าเตือนผิดบ่อยแค่ไหนตอนขับปกติ · **ห้ามหลับตาขณะรถวิ่ง** ให้ทดสอบหลับตาตอนจอดเท่านั้น | ผู้ใช้ |

### 2. เรื่องที่รอผู้ใช้ตัดสินใจ

| # | เรื่อง | สถานะ | อธิบาย |
|---|---|---|---|
| 2.1 | ก้มหัวหลับทันที | 🟠 | ถ้าตาปิดไม่ถึง ~1.2 วิแล้วหน้าหายไปเลย ระบบเตือนแค่ Distraction (เสียงสั้น) · ข้อเสนอคือ "ตาปิดแล้วหน้าหาย ≥3 วิ = ระดับ 3" |
| 2.2 | ท่าเพิ่มในสคริปต์เก็บภาพ | 🟠 | เพิ่ม "หลับแล้วก้ม" และ "ก้มดูมือถือ" เพื่อใช้แยกสองกรณีนี้ใน 1.4 · **ควรตัดสินก่อนทำ 1.1** จะได้ไปรถครั้งเดียวจบ |

### 3. Firmware

| # | งาน | สถานะ | อธิบาย | ใครทำ |
|---|---|---|---|---|
| 3.1 | จอ OLED | ✅ | 0.3.8-oled-info (branch `oled-info`): แถบสถานะ `AWAKE` / `SLEEPY` / `WAKE UP!` / `LOOK AHEAD` / `UNCLEAR` / `NO DRIVER` + บรรทัดตา, เสียง, ชื่อ AP, URL ผ่าน AP และผ่าน WiFi · ทดสอบบนบอร์ดผ่าน 3 พ.ย. | Claude |
| 3.2 | ทดสอบ buzzer/LED กับ DrowsyFW | 🔴 | ที่ผ่านเมื่อ 23 ต.ค. คือ BenchTest ยังไม่ได้ดูว่าหลับตาแล้วไฟและเสียงเป็นไปตามระดับไหม · ใช้เวลาไม่ถึง 10 นาทีที่โต๊ะ | ผู้ใช้ + Claude |
| 3.3 | แจ้งเตือนผ่าน Telegram | 🔴 | อยู่ในแผนเดิม (LINE Notify ปิดบริการแล้ว) · ถ้าเวลาไม่พอตัดออกได้ | Claude |
| 3.4 | ปุ่มบนบอร์ด | ✅ | (เพื่อน 0.3.5-hw) กดปุ่ม BOOT บนโมดูล = ปิดเสียง 5 นาที | — |
| 3.5 | เฟรมกล้องเสีย ~17% | ⚪ | ไม่เกี่ยวกับ PCB และยังได้ ~7 fps ไม่กระทบการทำงาน | — |
| 3.6 | buzzer เบาที่ 3.3V | ⚪ | ตัวเป็นรุ่น 5V ถ้าในรถได้ยินไม่ชัดให้เปลี่ยนเป็น TMB12A03 | ผู้ใช้ |

### 4. กล่อง

| # | งาน | สถานะ | อธิบาย | ใครทำ |
|---|---|---|---|---|
| 4.1 | รับกล่องจากร้านแล้วประกอบ | 🟡 รอร้าน | ขัดกระดาษทราย → ใส่ insert M3 → ใส่บอร์ด → ติดขาดูดกระจก | ผู้ใช้ |
| 4.2 | ป้าย SW1 | 🔴 | กล่องวางแนวนอนโดยแถว IR อยู่บน ต้องหมุนทิศ ON/OFF ตามก่อนเขียนป้าย | ผู้ใช้ |

### 5. Cloud และเว็บ

| # | งาน | สถานะ | อธิบาย | ใครทำ |
|---|---|---|---|---|
| 5.1 | Device Dashboard: หน้าตั้งค่า + กราฟ | ✅ | (เพื่อน) การ์ดสถานะ + กราฟสด 2 นาที · โหมด IR · ปุ่มทดสอบ · หน้า `/wifi` | — |
| 5.2 | Cloud Dashboard | ✅ | (เพื่อน) หน้าสำหรับผู้ใช้ทั่วไป: คะแนนความปลอดภัย, คำแนะนำ, ลบ Trip · ใช้ Supabase โปรเจกต์ใหม่ | — |
| 5.3 | ลงทะเบียนบอร์ดใน Supabase ใหม่ | 🟠 ถามเพื่อน | ต้องรู้ว่าลงทะเบียนแล้วหรือยัง และ `DEVICE_SECRET` ค่าไหน ไม่งั้น Sync ไม่ผ่าน | ผู้ใช้ + เพื่อน |

### 6. เอกสารที่ล้าสมัย

| # | ไฟล์ | สถานะ | ผิดตรงไหน |
|---|---|---|---|
| 6.1 | [firmware-plan.html](firmware-plan.html) | 🔴 | หัวข้อ 1–9 ยังเป็นสถานะ 18 ต.ค. ไม่มีบอร์ด v2 และ 0.3.2–0.3.4 |
| 6.2 | [firmware/README.md](../firmware/README.md) | 🔴 | หัวข้อกล้องเขียน SVGA และ 96×96 (ของจริงคือ HVGA และ 32×32) |
| 6.3 | BOM | 🔴 | เขียนว่า TSAL6200 = 850nm ที่ถูกคือ 940nm |
| 6.4 | `PCB_REVIEW_PROMPT.md` (นอก repo) | ⚪ | อ้าง uuid โปรเจกต์ EasyEDA ที่เลิกใช้แล้ว |

### 7. ส่งงาน

| # | งาน | สถานะ | อธิบาย | ใครทำ |
|---|---|---|---|---|
| 7.1 | วิดีโอสาธิต | 🟡 รอ 1.6 | ถ่ายตอนจอด หลับตาให้ดูการเตือนครบ 3 ระดับ | ผู้ใช้ |
| 7.2 | รายงาน | ❌ ตัดออก | ผู้ใช้ตัดออก 1 พ.ย. (ไม่ต้องทำรายงาน) · ข้อจำกัดไปอยู่ในสไลด์แทน | — |
| 7.3 | merge เข้า `main` | 🟡 | งานเพื่อน (PR #6) และ 0.3.7-oled (PR #7) merge แล้ว · เหลือ `oled-info` (งานใน `docs/` ขึ้นเว็บหลัง merge) | Claude |

### 8. เก็บกวาด

| # | งาน | สถานะ | อธิบาย |
|---|---|---|---|
| 8.1 | ลบสำเนาโมเดลชั่วคราว | ⚪ รออนุญาต | `~/Documents/Arduino/DrowsyFW_model` เลิกใช้แล้ว |
| 8.2 | ปิด session Claude ที่ไม่ใช้ | ⚪ | ตอนนี้ว่างอยู่ 8 session |

### ลำดับที่แนะนำ

1. ตัดสินใจข้อ **2.1–2.2**
2. ทำ **3.2** ที่โต๊ะ
3. ทำ **1.1–1.2** ในรถ
4. ระหว่างนั้น Claude ทำ **1.3–1.4, 3.1**, หมวด **6** และร่างรายงาน (**7.2**)
5. รับกล่องมาแล้วทำ **1.6** และ **7.1**

---

## ข้อมูลละเอียดอยู่ที่ไหน

| ไฟล์ | เนื้อหา |
|---|---|
| [CLAUDE.md](../CLAUDE.md) | คำสั่ง build/flash/test · สถาปัตยกรรม DrowsyFW · ผลทดสอบบอร์ด v2 |
| [firmware-plan.html](firmware-plan.html) | แผน, ผลทดลอง และการตัดสินใจ (หัวข้อ 0 = ตารางงานที่เหลือชุดเดียวกับไฟล์นี้) |
| [GLOSSARY.md](../GLOSSARY.md) · [adr/](adr/) | คำศัพท์ · การตัดสินใจหลัก 0001–0003 |
| [firmware/README.md](../firmware/README.md) | สเก็ตช์แต่ละตัว · ขั้นแฟลชผ่าน USB |
| [ml/README.md](../ml/README.md) | วิธี train และเทสต์โมเดล |
| [cloud/README.md](../cloud/README.md) | ตั้งค่า Supabase และ Cloud Dashboard |
| [enclosure/README.md](../enclosure/README.md) | ข้อกำหนดกล่อง · อะไหล่ · วิธีประกอบ |
| [bench-wiring-v1.md](bench-wiring-v1.md) | ผังต่อสายทดสอบบนบอร์ด v1 |
| `git log` | ประวัติทุกเวอร์ชัน |
| [PROJECT_STATUS.md](PROJECT_STATUS.md) | ⚠️ ล้าสมัย (ส.ค.) · ใช้ได้แค่ GPIO map |
