Franknakub/driver-drowsiness-detection/docs/reviews/2026-08-14_review-round1.md

# Design Review — Driver Drowsiness Detection
**วันที่:** 14 ส.ค. 2026 · **โปรเจกต์:** `Driver drowsiness detection` (uuid `6e6f4621...`) · **ผู้ตรวจ:** Claude ผ่าน easyeda-agent MCP

---

## แหล่งข้อมูลที่ใช้ตรวจ

| ข้อมูล | สถานะ |
|---|---|
| Netlist จาก schematic (Allegro) | ✅ อ่านครบ ใช้เป็นหลักฐานหลัก |
| รายการชิ้นส่วน 33 ตัว + LCSC part + ดาต้าชีต | ✅ อ่านครบ |
| ดาต้าชีต CH221K / SS8050 / TSAL6200 / GL5528 / KT-0805G / KT-0603R / UC17-0B06F68011 | ✅ ตรวจแล้ว |
| Pinout ESP32-S3-CAM (GOOUUU) | ✅ จากรูปที่ผู้ใช้ให้ |
| สเปกโมดูลนอกบอร์ด (OLED SSD1315 / Active Buzzer S8550) | ✅ จากลิงก์ที่ผู้ใช้ให้ |
| Geometry ของ PCB (ตำแหน่ง/รู/มุม) | ⚠️ **ข้อมูลไม่สอดคล้องกันระหว่างการอ่าน 2 ครั้ง — ต้องอ่านใหม่** (ดูท้ายเอกสาร) |

---

# 🔴 BLOCKER

## B1 — บัซเซอร์จะดังตลอดเวลา ปิดไม่ได้

**Netlist:** `5V ; U1.1 ...` · `GND ; U1.2 ...` · `GPIO14 ; U1.3 U5.37 U5.38`

โมดูล Active Buzzer ที่จะใช้ขับด้วย **S8550 = ทรานซิสเตอร์ PNP** ต่อแบบ high-side (emitter → VCC) และสเปกระบุ *"When the I/O port input low, the buzzer Sound"* → active-LOW

ปัญหา: บอร์ดจ่าย **VCC = 5V** แต่ ESP32-S3 ขับ I/O ได้สูงสุด **3.3V**

| สถานะ GPIO14 | V_EB ของ S8550 | ผล |
|---|---|---|
| LOW (0V) | 5.0V | ทรานซิสเตอร์นำ → บัซเซอร์ดัง (ตามต้องการ) |
| HIGH (3.3V) | **5 − 3.3 = 1.7V** | ยังมากกว่า V_BE(on) ≈ 0.7V → **ทรานซิสเตอร์ยังนำอยู่ → บัซเซอร์ยังดัง** |

**สั่งให้เงียบไม่ได้เลย** และตอน boot ที่ GPIO14 เป็น high-Z ก็จะดังด้วย

**วิธีแก้:** ย้าย `U1.1` จาก net `5V` → net `3V3`
สเปกโมดูลระบุ *"can be directly connected with the 5V microcontroller and 3.3V microcontroller"* → รองรับ 3.3V อยู่แล้ว เมื่อ VCC = 3.3V และ GPIO = 3.3V จะได้ V_EB = 0V → ปิดสนิท

---

## B2 — ขั้ว OLED สลับ เสียบแล้วจอพัง

**Netlist P1:** pin1 = `3V3` · pin2 = `GND` · pin3 = `GPIO01` · pin4 = `GPIO42`

โมดูล OLED 0.96" SSD1315 ที่จะใช้ silkscreen เรียงว่า **`GND` `VCC` `SCL` `SDA`**

| ตำแหน่ง | บอร์ดเรา (P1) | โมดูล OLED | ผล |
|---|---|---|---|
| 1 | 3V3 | **GND** | ❌ 3.3V เข้าขา GND |
| 2 | GND | **VCC** | ❌ GND เข้าขา VCC |
| 3 | GPIO1 | SCL | ✅ ใช้ได้ |
| 4 | GPIO42 | SDA | ✅ ใช้ได้ |

เสียบตรงๆ = **ป้อนกลับขั้ว จอเสียทันที**

**วิธีแก้:** สลับ P1 pin1 ↔ pin2 ในschematic (pin1 = GND, pin2 = 3V3)
ขา 3/4 ไม่ต้องแก้ — SCL/SDA บน ESP32 remap ได้อิสระ กำหนดใน firmware ได้เลย

---

## B3 — designator ไม่ตรงกันระหว่าง schematic กับ PCB

- Schematic มี **`C5`** (100nF, ต่อกับ GPIO41/SW1/R10)
- PCB มี **`C3`** แทน

จำนวนเท่ากัน (33/33) แต่ชื่อไม่ตรง → PCB ยังไม่ได้ sync กับ schematic รอบล่าสุด

**วิธีแก้:** กด `Design → Import Changes from Schematic` → `Apply Changes` **ผ่าน GUI เท่านั้น** (API `importChanges()` คืน `true` แต่ไม่ทำงานจริง — บั๊กที่บันทึกไว้แล้ว)

---

## B4 — Schematic ERC: ผลยังสรุปไม่ได้ ต้องดูด้วยตา

`sch_run_drc(strict: true)` คืนค่า **`false`** ทั้งแบบ `userInterface: false` และ `true` (รัน 3 ครั้ง ผลเดิม ยืนยันว่าไม่ใช่หลุดการเชื่อมต่อ)

⚠️ **แต่ `false` แปลว่าอะไรยังไม่ชัด** — tool นี้ไม่มี schema บอกความหมายของค่าที่คืน และไม่มีโหมด verbose อาจแปลว่า "ERC พบ error" หรือแค่ "รันไม่สำเร็จ/ไม่คืนรายงาน" ก็ได้

**สิ่งที่ตัดออกไปได้แล้ว:** ตรวจขาของทุก component ที่เสี่ยงแล้ว (Q1, Q3, SW1, U1, P1, USB1) — **ไม่มีขาลอยเลยแม้แต่ขาเดียว** ขาที่ไม่ต่อทุกขาถูกติดธง No-Connect ไว้ถูกต้อง และทุก net ในเน็ตลิสต์มีขาเชื่อมอย่างน้อย 2 ขา

**เหลือให้ทำ:** เปิดหน้าต่าง ERC ใน EasyEDA แล้วส่งรายการ error มา ถ้าว่างเปล่า = ผ่านจริง และข้อนี้ตัดทิ้งได้

---

# 🟡 WARNING

| # | หัวข้อ | รายละเอียด | ข้อเสนอ |
|---|---|---|---|
| W1 | **LED1 หรี่มาก** | KT-0805G เขียว Vf = 2.6–3.1V, R11 = 470Ω → I = (3.3−2.85)/470 = **0.96mA** (กรณีแย่สุด Vf=3.1V เหลือ **0.43mA**) ขณะที่สเปกใช้งานที่ 5mA | ลด R11 เหลือ **100–150Ω** |
| W2 | **ไม่มี bulk cap บนราง 5V เลย** | ราง 5V เลี้ยง: โมดูล ESP32-S3+OV5640 (พีคตอน WiFi TX ~500mA) + IR LED 116mA แบบพัลส์ + บัซเซอร์ — แต่ไม่มี cap ตัวไหนอยู่บนราง 5V (C1 อยู่ที่ VDD ของ CH221K, C2 = ฟิลเตอร์ LDR, C5 = debounce ปุ่ม) | เพิ่ม **10–100µF** + 100nF ใกล้ U5.39/40 |
| W3 | **ไม่มี decoupling บนราง 3V3** | 3V3 เลี้ยง OLED + pull-up + LDR divider | เพิ่ม **100nF + 10µF** ใกล้ P1 |
| W4 | **ไม่มี Net Class** | net ทั้ง 53 ตัวใช้ rule `default` — guideline POWER 0.80mm ยังไม่ได้ทำ | สร้าง Net Class POWER = {5V, 3V3, VIN, GND} @ 0.80mm |
| W5 | **VBUS แยกเป็น 2 net** | `USB1.A9 → 5V` แต่ `USB1.B9 → VIN` — คอนเน็กเตอร์ 6P ขา VBUS ทั้งสองไม่ได้เชื่อมกันบนบอร์ด กระแสทั้งหมดวิ่งผ่านหน้าสัมผัสเดียว | รวม A9 + B9 เป็น net เดียว |
| W6 | **GPIO3 เป็น strapping pin** | ESP32-S3 strapping = GPIO0, **GPIO3**, GPIO45, GPIO46 — GPIO3 คุมการเลือกแหล่ง JTAG และโมดูลระบุว่าเป็น "JTAG EN" ตอนนี้มี LDR divider คาอยู่ | ไม่กระทบ boot mode (ความเสี่ยงต่ำ) แต่ควรรู้ไว้ / ถ้าย้ายได้ ใช้ GPIO21 หรือ GPIO47 แทน |
| W7 | **ใช้ขา JTAG หมดทั้ง 3 เส้น** | GPIO40 = MTDO (LED2), GPIO41 = MTDI (ปุ่ม), GPIO42 = MTMS (I2C) | **debug ผ่าน JTAG ไม่ได้** — ถ้าโปรแกรมผ่าน USB อย่างเดียวก็ไม่มีปัญหา |
| W8 | **R10 / SW1 ไม่มีรหัส LCSC** | R10 supplierId = `0603WAF1002T5E.1`, SW1 = `TS-1088-AR02016.1` — ไม่ใช่รหัส `C…` | แก้ให้เป็น C25804 (R10 = 10kΩ) และรหัสจริงของ TS-1088-AR02016 ไม่งั้น JLCPCB assembly หลุด |
| W9 | **ช่อง Value ของ R10 ว่าง** | ตัวจริงคือ 10kΩ (จาก part number `0603WAF1002T5E`) แต่ BOM จะขึ้นว่าง | เติม Value = 10kΩ |
| W10 | **IR ส่องได้ไม่แรงนัก** | TSAL6200 ให้ 40mW/sr @100mA แต่ขับที่ ~29mA → ~11mW/sr มุม ±17° | ถ้าตรวจหน้าคนขับระยะ 50–70cm อาจต้องลด R16–19 (แต่ต้องเช็คงบกระแสก่อน) |

---

# 🟢 PASS — ตรวจแล้วถูกต้อง

## การจ่าย GPIO — ไม่ชนขากล้องแม้แต่ขาเดียว

เทียบกับ pinout ของ GOOUUU ESP32-S3-CAM แล้ว **ขาที่ใช้งานจริง 7 เส้น ไม่มีเส้นไหนไปโดนขากล้อง/PSRAM/USB/strapping ที่ห้ามแตะ**

| GPIO | ใช้ทำอะไร | สถานะบนโมดูล | ผล |
|---|---|---|---|
| 3 | LDR (ADC) | JTAG EN / **strapping** / ADC1_CH2 | ⚠️ ใช้ได้ (ดู W6) — และเป็น **ADC1** ซึ่งใช้ร่วมกับ WiFi ได้ ✅ |
| 14 | บัซเซอร์ | ว่าง | ✅ |
| 21 | ขับ IR (ผ่าน Q3) | ว่าง | ✅ |
| 40 | LED2 | SD_DATA / MTDO | ✅ (SD ไม่ได้ใช้) |
| 41 | ปุ่ม USER | MTDI | ✅ |
| 42 | I2C → OLED | MTMS | ✅ |
| 47 | LED1 | ว่าง | ✅ |
| 1 | I2C → OLED | ADC1_CH0 / T1 | ✅ |

**ขาที่ปล่อยว่างถูกต้องทั้งหมด:** GPIO4–13, 15–18 (ขากล้อง CAM_*), GPIO35/36/37 (PSRAM octal), GPIO19/20 (USB D±), GPIO43/44 (UART0), GPIO0/45/46 (strapping), GPIO48 (WS2812 บนโมดูล), GPIO2 (LED ON บนโมดูล) — ทุกเส้นต่อกับ header เท่านั้น ไม่มีอะไรมาแตะ ✅

## วงจรขับ IR — คำนวณแล้วผ่านทุกจุด

`5V → R16-19 (120Ω) → IR1-4 → รวมที่ Q3.3 (collector) → Q3.2 (emitter) → GND` และ `GPIO21 → R3 (1kΩ) → Q3.1 (base)`

| รายการ | คำนวณ | เกณฑ์ | ผล |
|---|---|---|---|
| กระแสต่อดวง | (5 − 1.35 − 0.15)/120 = **29mA** | TSAL6200 If max 100mA | ✅ |
| กำลังที่ R16–19 | 0.029² × 120 = **0.10W** | R1206 = 0.25W | ✅ |
| Ic รวมที่ Q3 | **116mA** | SS8050 Ic max 1.5A | ✅ |
| Ib | (3.3 − 0.75)/1k = **2.55mA** | — | — |
| forced β | 116/2.55 = **45** | hFE 200–350 | ✅ อิ่มตัวสบายๆ |
| Pd ที่ Q3 | ~17mW | Pd max 300mW | ✅ |

**เลือก SS8050 ถูกต้องมาก** — ถ้าใช้ MMBT3904 (Ic max 200mA) จะเฉียดฉิว

## USB-PD

| รายการ | ผล |
|---|---|
| **R6 = 10kΩ จาก CFG → VDD = ขอ 5V** | ✅ ยืนยัน 2 แหล่ง — ถ้าใส่ผิดเป็น 20kΩ/47kΩ จะขอ 9V/12V แล้ว**เผาโมดูลกับ IR LED ทั้งแผง** |
| **ขาต่อของ CH221K ครบถูกต้องทุกขา** | ✅ อ่านชื่อขาจาก symbol ได้แล้ว: `1=VDD, 2=GND, 3=PG, 4=CC1, 5=CC2, 6=CFG` — ขา 3 = **Power Good (output)** ติดธง No-Connect ไว้ตั้งใจ (`noConnected: true`) ปล่อยลอยได้ปกติ **ไม่กระทบการเจรจา PD** |
| R8/R9 = 5.1kΩ บน CC1/CC2 | ✅ ค่า Rd มาตรฐานของ sink |
| R7 = 1kΩ + C1 1µF ที่ VDD | ✅ ตรงกับวงจรอ้างอิง (จำกัดกระแสเข้า clamp ภายใน) |
| คอนเน็กเตอร์ UC17 rated 5V/3A | ✅ สอดคล้องกับการขอ 5V |

## วงจรอื่น

| วงจร | ผล |
|---|---|
| **LDR** `3V3 → R1 10k → GPIO3 → GL5528 → GND` + C2 100nF | ✅ สว่างจัด ≈ 0.3V, 10 lux ≈ 2.0V, มืด ≈ 3.27V — ครอบคลุมช่วง ADC ดี, RC = 1ms |
| **ปุ่ม** `3V3 → R10 10k → GPIO41 → SW1 → GND` + C5 100nF | ✅ debounce 1ms, กระแสตอนกด 0.33mA |
| **I2C pull-up** R4/R5 = 4.7kΩ ทั้ง 2 เส้น | ✅ (โมดูล OLED มักมี pull-up ในตัวด้วย → ขนานเหลือ ~2.4kΩ ยังอยู่ในเกณฑ์) |
| **LED2** แดง R12 470Ω → 2.55mA | ✅ สว่างพอ |
| **GND** ต่อครบทุกจุด รวม USB1.A12 + B12 | ✅ |

---

# ⚠️ ส่วนที่ต้องตรวจ PCB ใหม่ (ข้อมูลไม่น่าเชื่อถือ)

ระหว่างการตรวจ พบว่า **ตำแหน่ง component กับตำแหน่ง pad ที่อ่านมาไม่สอดคล้องกัน** เช่น ระบบบอกว่า `Q1` อยู่ที่ (2460, −3965) mil แต่ pad ของ CH221K (pin1 = net `$1N74`, pin3 = ไม่มี net) กลับอยู่ที่ ~(1170, −2300) mil

สาเหตุที่เป็นไปได้: การอ่าน 2 ครั้งเกิดคนละช่วงเวลาและอาจเป็น **คนละเอกสาร PCB** (มีการสลับ tab / reconnect คั่นกลาง)

**ผลที่ตามมา — ข้อสรุปเชิงตำแหน่งต่อไปนี้ต้องอ่านใหม่ทั้งหมดก่อนเชื่อ:**
- รูสกรู M3 4 มุม (รอบก่อนสรุปว่าไม่มี)
- รูขาตั้ง ⌀7.5mm MOUNT1 และระยะ clearance
- มุม 90° 5 จุด และพิกัดที่ระบุ
- ระยะ decoupling cap
- board outline

**สิ่งที่ยังเชื่อได้ 100%** คือทุกอย่างในเอกสารนี้ที่มาจาก **netlist และรายการชิ้นส่วน** (B1–B5, W1, W4–W10 และหมวด PASS ทั้งหมด) เพราะมาจากการอ่านครั้งเดียวที่สอดคล้องกันในตัวเอง

**วิธีตรวจใหม่:** เปิด `PCB1_1` ให้ active → กด `Claude → Connect Claude` → อย่าสลับ tab ระหว่างตรวจ

---

# ลำดับการแก้ที่แนะนำ

1. **B1** ย้าย U1.1 → 3V3 (ถ้าไม่แก้ บัซเซอร์ใช้งานไม่ได้เลย)
2. **B2** สลับ P1 pin1 ↔ pin2 (ถ้าไม่แก้ จอพังตอนเสียบครั้งแรก)
3. **B4** เปิดหน้าต่าง ERC ส่งรายการ error มา (หรือยืนยันว่าว่าง)
4. **W1** ลด R11 → 100–150Ω · **W8/W9** แก้รหัส LCSC + Value ของ R10
5. **W2/W3** เพิ่ม bulk + decoupling cap
6. **B3** Import Changes from Schematic ผ่าน GUI
7. **W4** ตั้ง Net Class POWER 0.80mm แล้ว re-route
8. ตรวจ PCB geometry ใหม่ทั้งหมดบน PCB1_1

---

## แหล่งอ้างอิง

- [CH224/CH221K family — DONE.LAND](https://done.land/components/power/powersupplies/usb/usbtriggers/ch224/) — ตาราง CFG resistor ของ CH221K
- [การทดลองจริงกับ CH221K](https://x.com/electrotelecast/status/1830226376416464920) — ยืนยัน 10k → 5V
- [CH221K @ LCSC C5125736](https://www.lcsc.com/product-detail/C5125736.html)
- [USB-C PD Trigger review — Beyondlogic](https://www.beyondlogic.org/review-usb-c-power-delivery-trigger-board-ch224/)
- ดาต้าชีตชิ้นส่วนอื่นดึงจาก property ของแต่ละ component ใน EasyEDA (szlcsc.com)
