Franknakub/driver-drowsiness-detection/docs/archive/early-design/project-plan.html

Group 17 · Embedded System 2026

# Driver Drowsiness Detection .

แผนการทำโปรเจคแบบละเอียดทีละขั้นตอน — ตรวจจับความง่วงของคนขับด้วยกล้อง + TinyML บน custom PCB จนถึงวันส่งจริง

สมาชิก 2 คน 🎯 Deadline ส่งงาน 3–5 พ.ย.

PROJECT PROGRESS 0%

เช็คงานที่ทำเสร็จในแต่ละ phase ด้านล่าง แล้วแถบนี้จะขยับเอง

A

## ระบบทำงานยังไง

หลักการสั้นๆ ก่อนลงมือ — กล้องดูตา, โมเดลตัดสินว่าง่วงไหม, ถ้าง่วงก็เตือน

📷

Camera

จับภาพใบหน้า

👁️

ตรวจดวงตา

เปิด / หลับ

🧠

TinyML

บน ESP32-S3

⏱️

PERCLOS

หลับนานเกิน?

🔔

Alert

Buzzer + LED

B

## แผนงาน 8 Phase

เรียงตาม deliverable ที่อาจารย์ต้องตรวจ — Schematic → PCB → Order → ประกอบ → Doc → ส่ง

C

## แบ่งงาน 2 คน · BOM

โปรเจค 2 คน แบ่งสาย Hardware/PCB กับ Software/ML ให้คู่ขนานกัน จะเสร็จเร็วขึ้น

### 👤 คนที่ 1 — Hardware / PCB

สมาชิกคนที่ 1

EasyEDA SchematicPhase 2

PCB Layout + RoutePhase 3

Order JLCPCB + BOMPhase 4

บัดกรี / ประกอบ PCBAPhase 6

### 👤 คนที่ 2 — Software / TinyML

สมาชิกคนที่ 2

หา Dataset + LabelPhase 1

Train โมเดล Edge ImpulsePhase 5

เขียน Firmware + DeployPhase 6

เขียน Project DocPhase 7

### 📦 BOM — อุปกรณ์หลัก (LCSC/JLCPCB)

เลือกของที่ JLCPCB มีในคลัง จะประกอบ PCBA ได้เลย

ESP32-S3-WROOM-1 (N16R8)MCU

OV2640 + FPC 24p 0.5mmCamera

MPU-6050IMU

MP1584EN12V→5V

AMS1117-3.35V→3.3V

TSAL6200 ×4IR LED

Active Buzzer + MOSFETAlert

USB-C + SM6T15A (TVS)Prog/Protect

### ✍️ กรอกฟอร์มอาจารย์ (กลุ่ม 17)

ช่อง Input / Output ที่ยังว่าง — copy ไปวางได้เลย

ช่อง E · Input (Sensor)

Input (Sensor)
1. OV2640 Camera (จับภาพใบหน้า/ดวงตา)
2. MPU6050 (ตรวจการพยักหน้า/ก้มหลับ)
3. Tact Switch x1 (เปิด-ปิดระบบ)

⧉ copy

ช่อง F · Output (Alert)

Output (Alert)
1. Buzzer (เตือนเสียงเมื่อง่วง)
2. LED x2 (สถานะ Alert/Drowsy)
3. OLED Display (แสดงระดับความง่วง)

⧉ copy

D

## จุดเสี่ยง · กันพลาด

5 เรื่องที่ทำให้ทีมส่วนใหญ่เสียเวลา — รู้ไว้ก่อนจะไม่ตกหลุม

📡

WiFi Antenna Keepoutห้ามมี copper ใต้เสาอากาศ ESP32-S3 เว้น keepout ~3mm ไม่งั้น WiFi ใช้ไม่ได้

🔌

FPC Camera 0.5mm pitchconnector กล้องบัดกรียาก ลอกพินจาก ESP32-S3-EYE schematic ของ Espressif มาเป็น reference

⚡

Decoupling capacitorวาง 100nF ใกล้ทุก VCC + 10µF ใกล้ output DC-DC ป้องกัน noise รีเซ็ต MCU

📅

เผื่อเวลา JLCPCB 7–10 วันสั่งบอร์ดต้องรอ ถ้าสั่งช้าจะไม่ทันส่ง — order ให้เสร็จก่อนกลางต.ค.

🔁

ทำ prototype ก่อนเสมอทดสอบ ML บน ESP32-CAM ให้ work ก่อน ค่อยลงทุนทำ PCB จะได้ไม่ต้องสั่งซ้ำ

Group 17 · Driver Drowsiness Detection with TinyML · การบ้านครั้งนี้แผนนี้ติดตามได้จริง — เช็คงานเสร็จ progress จะ save ในเครื่องอัตโนมัติ

↺ reset progress
