Franknakub/driver-drowsiness-detection/hardware/fabrication/2026-10-03_v2/BOM_PCB1_1_v2_2026-10-03.xlsx

Supplier | Supplier Part | Manufacturer | Manufacturer Part | Value | Footprint | Designator | Comment | Quantity | No. | JLCPCB Stock | LCSC Stock
LCSC | C17702778 | TORCH(火炬) | C0805B105K500NT | 1uF | C0805 | C1 | 1uF | 1 | 1 | 15871
LCSC | C49678 | YAGEO(国巨) | CC0805KRX7R9BB104 | 100nF | C0805 | C2,C3,C5 | 100nF | 3 | 2 | 19193728
LCSC | C15850 | SAMSUNG(三星) | CL21A106KAYNNNE | 10uF | C0805 | C4,C6,C8 | 10uF | 3 | 3 | 4944583
LCSC | C336792 | PANASONIC(松下) | EEEFT1C101AR | 100uF | CAP-SMD_BD5.0-L5.3-W5.3-LS6.5-FD | C7 | 100uF | 1 | 4 | 15744
LCSC | C2691448 | XFCN(兴飞) | PZ254V-11-04P |  | HDR-TH_4P-P2.54-V-M | H1 | PZ254V-11-04P | 1 | 5 | 979535
LCSC | C2937625 | XFCN(兴飞) | PZ254V-11-03P |  | HDR-TH_3P-P2.54-V-M_PZ254V-11-03P | H2 | PZ254V-11-03P | 1 | 6 | 1021650
LCSC | C55528 | VISHAY(威世) | TSAL6200 |  | LED-TH_BD5.0-P2.54-FD | IR1,IR2,IR3,IR4 | TSAL6200 | 4 | 7 | 23482
LCSC | C2297 | KENTO | KT-0805G |  | LED0805-R-RD | LED1 | KT-0805G | 1 | 8 | 3125050
LCSC | C2286 | KENTO | KT-0603R |  | LED-SMD_L1.6-W0.8-R-RD | LED2 | KT-0603R | 1 | 9 | 4812422
LCSC | C5125736 | WCH(南京沁恒) | CH221K |  | SOT-23-6_L2.9-W1.6-P0.95-LS2.8-BL-2 | Q1 | CH221K | 1 | 10 | 29174
LCSC | C2146 | CJ(江苏长电/长晶) | S8050 J3Y(RANGE:200-350) |  | SOT-23-3_L3.0-W1.7-P0.95-LS2.9-BR | Q3 | S8050 J3Y(RANGE:200-350) | 1 | 11 | 1374058
LCSC | C25804 | UNI-ROYAL(厚声) | 0603WAF1002T5E | 10kΩ | R0603 | R1,R6 | 10kΩ | 2 | 12 | 23008785
LCSC | C125627 | 森霸 | GL5528 |  | RES-TH_L5.1-W4.3-P3.40-D0.5 | R2 | GL5528 | 1 | 13 | 10589
LCSC | C11702 | UNI-ROYAL(厚声) | 0402WGF1001TCE | 1kΩ | R0402 | R3 | 1kΩ | 1 | 14 | 7140517
LCSC | C25900 | UNI-ROYAL(厚声) | 0402WGF4701TCE | 4.7kΩ | R0402 | R4,R5 | 4.7kΩ | 2 | 15 | 15448200
LCSC | C2907232 | FOJAN(富捷) | FRC0805F1001TS | 1kΩ | R0805 | R7 | 1kΩ | 1 | 16 | 7604994
LCSC | C27834 | UNI-ROYAL(厚声) | 0805W8F5101T5E | 5.1kΩ | R0805 | R8,R9 | 5.1kΩ | 2 | 17 | 3408892
LCSC | C25117 | UNI-ROYAL(厚声) | 0402WGF4700TCE | 470Ω | R0402 | R11,R12 | 470Ω | 2 | 18 | 839148
LCSC | C17909 | UNI-ROYAL(厚声) | 1206W4F1200T5E | 120Ω | R1206 | R16,R17,R18,R19 | 120Ω | 4 | 19 | 535285
LCSC | C2876014 | G-Switch(品赞) | SS-12D01-G040 |  | SW-TH_SS-12D01-GX | SW1 | SS-12D01-G040 | 1 | 20 | 271
LCSC | C2977589 | ZHOURI(洲日) | 2.54-2*20 |  | HDR-TH_40P-P2.54-V-F-R2-C20-S2.54 | U5,U6 | 2.54-2*20 | 2 | 21 | 34998
LCSC | C36936554 | BXCONN(宝讯) | UC17-0B06F68011 |  | USB-C-SMD_UC17-0B06F68011 | USB1 | UC17-0B06F68011 | 1 | 22 | 5319
