Franknakub/driver-drowsiness-detection/enclosure/cad/out/assembly/switch_knob.stl

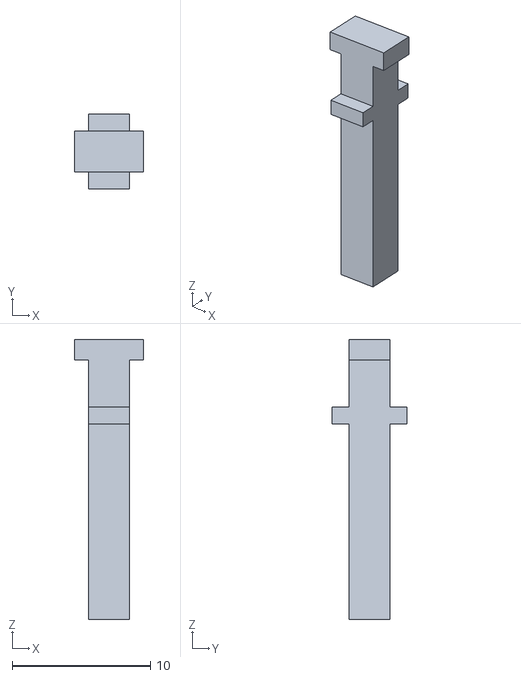
[picture p1: CAD file, 2026-10-19]
enclosure/cad/out/assembly/switch_knob.stl
5.00 x 5.40 x 20.3
