Franknakub/driver-drowsiness-detection/enclosure/cad/out/sw1_pin.step

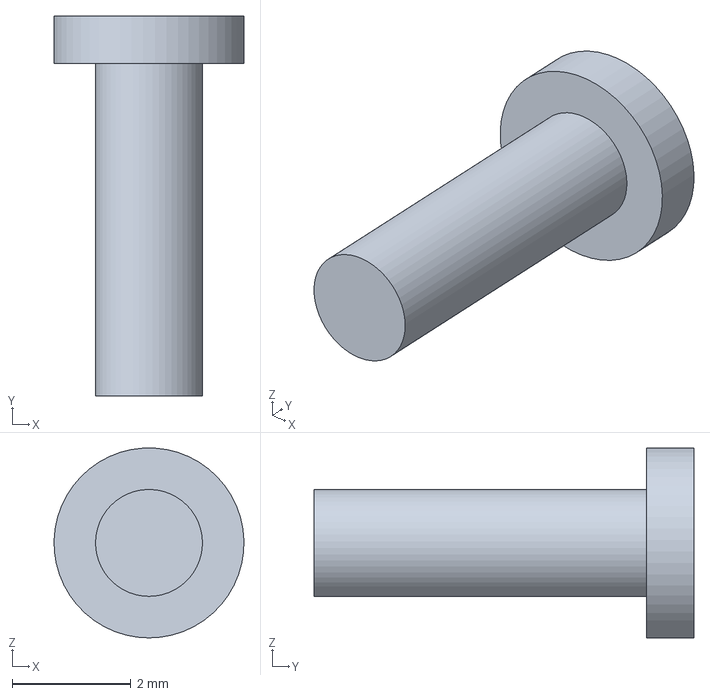
[picture p2: CAD file, 2026-11-01]
enclosure/cad/out/sw1_pin.step
3.20 x 6.40 x 3.20 mm
