Franknakub/driver-drowsiness-detection/enclosure/print_2026-10-18/lid.step

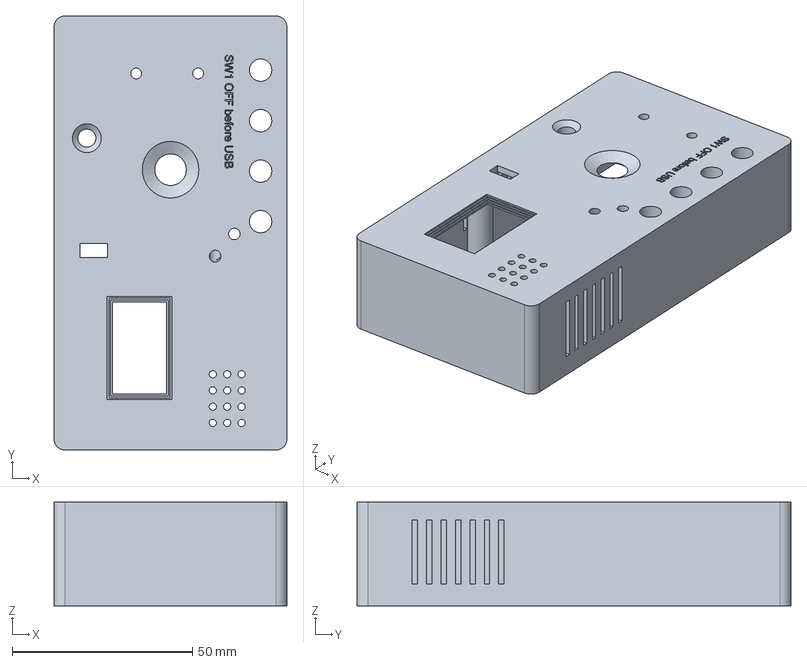
[picture p3: CAD file, 2026-10-19]
enclosure/print_2026-10-18/lid.step
64.5 x 120.3 x 28.8 mm
