Franknakub/driver-drowsiness-detection/enclosure/print_2026-10-26/sw1_bracket.step

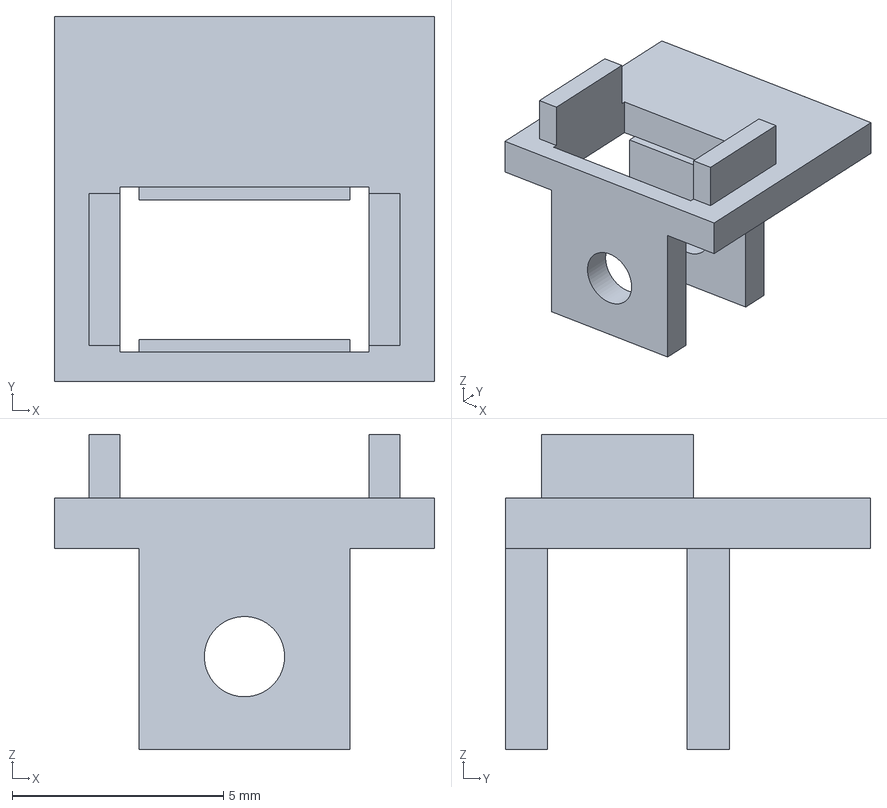
[picture p4: CAD file, 2026-11-01]
enclosure/print_2026-10-26/sw1_bracket.step
9.00 x 8.64 x 7.46 mm
