Franknakub/driver-drowsiness-detection/enclosure/cad/out/assembly/base.stl

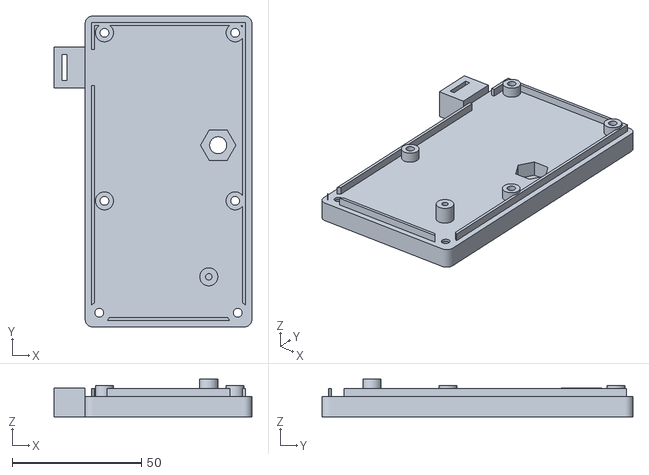
[picture p5: CAD file, 2026-10-19]
enclosure/cad/out/assembly/base.stl
76.5 x 120.3 x 14.7
