Franknakub/driver-drowsiness-detection/enclosure/cad/out/assembly/metal.stl

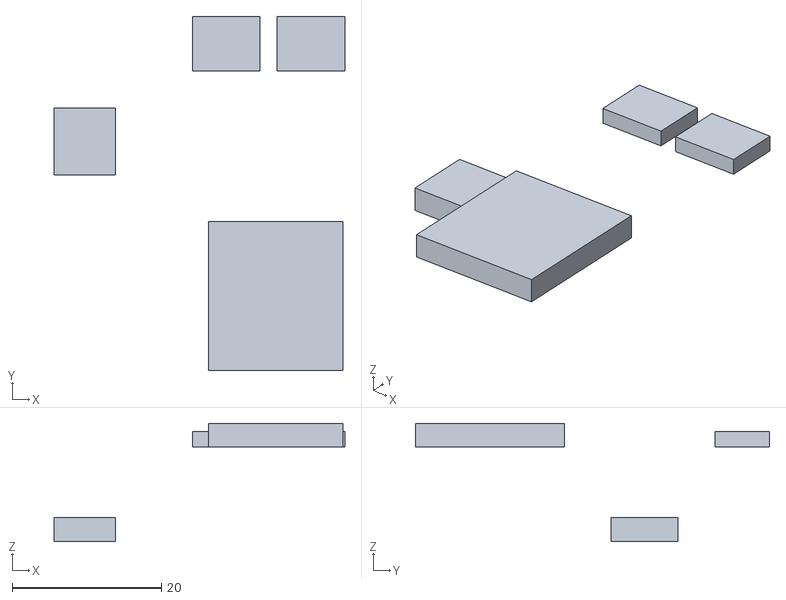
[picture p6: CAD file, 2026-10-19]
enclosure/cad/out/assembly/metal.stl
39.0 x 47.5 x 15.9
