Franknakub/driver-drowsiness-detection/enclosure/cad/out/assembly/usb_cable.stl

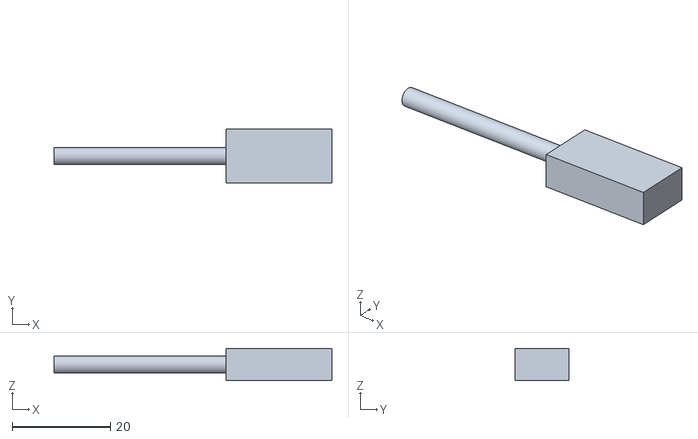
[picture p7: CAD file, 2026-10-19]
enclosure/cad/out/assembly/usb_cable.stl
56.6 x 11.0 x 6.52
