Franknakub/driver-drowsiness-detection/enclosure/cad/out/assembly/buzzer.stl

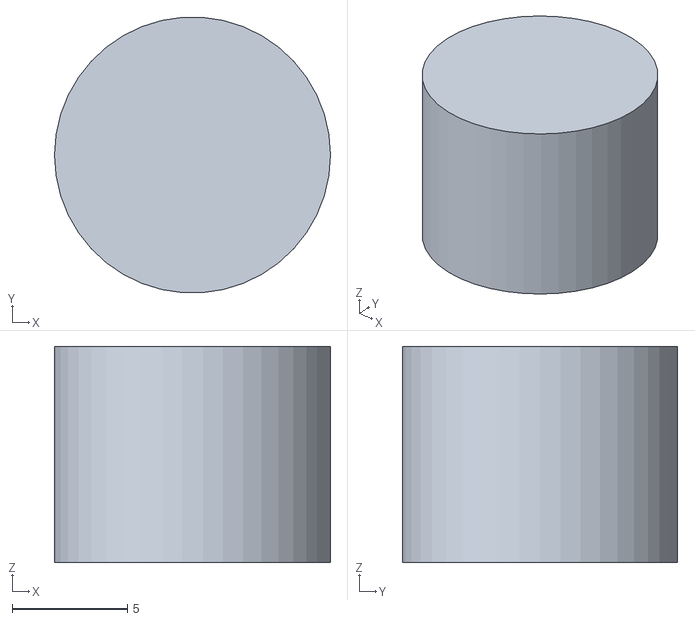
[picture p8: CAD file, 2026-10-19]
enclosure/cad/out/assembly/buzzer.stl
12.0 x 12.0 x 9.40
