Franknakub/driver-drowsiness-detection/enclosure/cad/out/assembly/oled_pcb.stl

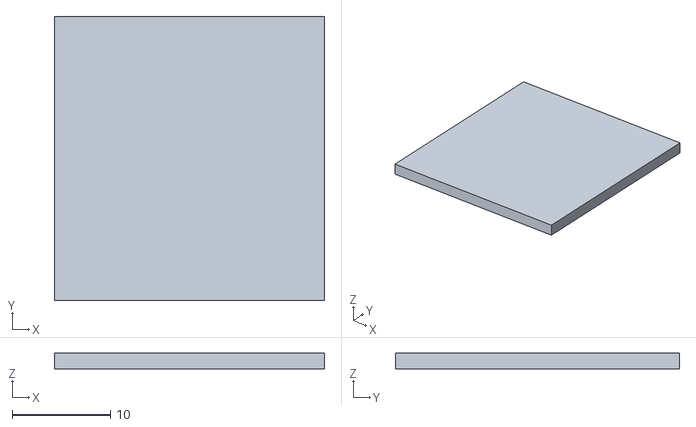
[picture p9: CAD file, 2026-10-19]
enclosure/cad/out/assembly/oled_pcb.stl
27.5 x 28.9 x 1.60
