Franknakub/driver-drowsiness-detection/(list of files, cad)

Other CAD files:
enclosure/cad/out/lid.step
enclosure/print_2026-10-26/sw1_bracket.stl
