Franknakub/driver-drowsiness-detection/docs/hardware/bench-wiring-v1.md

# ผังต่อสายทดสอบบนบอร์ด v1 (ไม่เสียบโมดูล)

ใช้ระหว่างรอ PCB v2 เพื่อทดสอบ firmware กับ IR LED, LDR, LED, OLED และ buzzer ของจริง

**ข้อมูลที่ใช้:** netlist จากไฟล์โปรเจกต์ v1 จริง `hardware/easyeda/archive/DriverDrowsiness_v1_2026-08-31.epro2` (export 31 ส.ค. 23:02 ตรงกับชุดที่สั่งผลิต) และชนิดชิ้นส่วนจาก metadata ในไฟล์เดียวกัน

## กฎ 3 ข้อ

1. **ห้ามเสียบโมดูลลงบน header ของ v1** เพราะ header เป็นภาพกระจก 5V↔GND จะกลับขั้ว ให้วางโมดูลไว้ข้างบอร์ดแล้วต่อสายแทน
2. **ห้ามเสียบสาย USB-C เข้าบอร์ด v1 (USB1)** ไฟทั้งหมดมาจากโมดูลที่เสียบคอมผ่าน USB ของโมดูล
3. **ห้ามใช้ H2 ขา 3 ของ v1** เพราะเป็น **5V** (v2 เปลี่ยนเป็น 3V3 แล้ว) ถ้าเลี้ยงโมดูล buzzer ด้วย 5V มันจะดังค้างปิดไม่ได้

## วิธีหาตำแหน่งบนบอร์ด v1

วางบอร์ดหงายด้านที่มีชิ้นส่วนขึ้น ให้ **IR LED 4 ดวงอยู่ขวา** และ **USB-C อยู่ซ้าย** ตอนนี้ LED1/LED2 กับสวิตช์ SW1 จะอยู่ขอบล่าง

- **header ซ้าย (U5)** และ **header ขวา (U6)** เป็น header ตัวเมีย 2×20
- **ทั้ง 2 คอลัมน์ของแถวเดียวกันเป็นเน็ตเดียวกัน** เสียบรูไหนในแถวนั้นก็ได้
- "แถว 1" คือแถวบนสุด ฝั่งที่ห่างจาก LED1/LED2 และนับลงไปจนถึง "แถว 20" ที่อยู่ล่างสุด

| แถว | header ซ้าย (U5) | header ขวา (U6) |
|---|---|---|
| 1 | **5V** | **GND** |
| 2 | GPIO14 | GPIO19 |
| 4 | GPIO12 | **GPIO21** (IR) |
| 5 | GPIO11 | **GPIO47** (LED เขียว) |
| 9 | **GPIO3** (LDR) | GPIO35 |
| 14 | GPIO15 | **GPIO40** (LED แดง) |
| 16 | GPIO6 | **GPIO42** (OLED SDA) |
| 18 | GPIO4 | **GPIO1** (OLED SCL) |
| 20 | **3V3** | GPIO43 |

ตัวหนา = แถวที่ใช้ในผังนี้ (ตารางเต็ม 20 แถวอยู่ท้ายไฟล์)

## สายที่ต้องต่อ

ต้องใช้สายผู้–เมีย 10 เส้น และเมีย–เมีย 6 เส้น โมดูลมีขา 3V3, GND และ 5V อย่างละ**ขาเดียว** ไฟเลี้ยงของ OLED และ buzzer จึงต้องดึงจากบอร์ด v1 แทน

### A. โมดูล → บอร์ด v1 (ผู้–เมีย: ปลายเมียเสียบขาโมดูล ปลายผู้เสียบรู header ของ v1)

| # | ขาโมดูล | ไปที่ v1 | ใช้ทำอะไร |
|---|---|---|---|
| 1 | GND | ขวา แถว 1 | กราวด์ร่วม **ต่อเส้นนี้ก่อนเส้นอื่น** |
| 2 | 3V3 | ซ้าย แถว 20 (รูที่ 1) | LDR, pull-up I2C, OLED |
| 3 | GPIO47 | ขวา แถว 5 | LED1 เขียว (ผ่าน R11 470Ω) |
| 4 | GPIO40 | ขวา แถว 14 | LED2 แดง (ผ่าน R12 470Ω) |
| 5 | GPIO3 | ซ้าย แถว 9 | LDR GL5528 (R1 10k ขึ้น 3V3, LDR ลง GND) |
| 6 | GPIO1 | ขวา แถว 18 | OLED SCL → H1 ขา 3 |
| 7 | GPIO42 | ขวา แถว 16 | OLED SDA → H1 ขา 4 |
| 8 | GPIO21 | ขวา แถว 4 | IR: R3 1k → ขา base ของ S8050 (Q3) |
| 9 | 5V | ซ้าย แถว 1 | ไฟ IR LED 4 ดวง (~115 mA) **ต่อเป็นเส้นสุดท้าย** |

### B. OLED → H1 ของ v1 (เมีย–เมีย · H1 เป็น pin header ตัวผู้ 4 ขา ขา 1 = pad สี่เหลี่ยม)

| ขา OLED | H1 | เน็ต |
|---|---|---|
| VCC | ขา 1 | 3V3 |
| GND | ขา 2 | GND |
| SCL | ขา 3 | GPIO1 |
| SDA | ขา 4 | GPIO42 |

ลำดับขาตรงกันทุกเส้น และได้ pull-up 4.7k (R4/R5) บนบอร์ดมาด้วย

### C. โมดูล buzzer

| ขา buzzer | ไปที่ | สาย |
|---|---|---|
| VCC | v1 ซ้าย แถว 20 (รูที่ 2 · 3V3) | ผู้–เมีย |
| GND | v1 H2 ขา 1 (pad สี่เหลี่ยม · GND) | เมีย–เมีย |
| I/O | **ขา GPIO14 ของโมดูลโดยตรง** | เมีย–เมีย |

ไม่ต้องต่อ H2 ขา 2 และ**ห้ามต่อ H2 ขา 3 (5V)**

## ลำดับการต่อและทดสอบ

ต่อสายทุกเส้นตอน**ถอดสาย USB ของโมดูลออกแล้วเท่านั้น** และทดสอบทีละขั้น

1. **GND + 3V3 + LED (สาย 1–4)** → เสียบ USB → เขียว/แดงต้องกระพริบตามที่สั่ง
2. **LDR (สาย 5)** → ค่า ADC ต้องเปลี่ยนเมื่อเอามือบัง (มืดลง ค่าจะ**สูงขึ้น** เพราะ LDR อยู่ฝั่ง GND)
3. **OLED (สาย 6–7 + ชุด B)** → I2C scan ต้องเจอ `0x3C` และจอขึ้นข้อความ
4. **buzzer (ชุด C)** → `HIGH` = เงียบ, `LOW` = ดัง · ตอนบูตต้องไม่ดังค้าง
5. **IR (สาย 8 แล้วตามด้วยสาย 9)** → ตาคนมองไม่เห็นแสง 940 nm ให้ดูผ่านกล้องหน้าของมือถือ หรือหันกล้อง OV5640 เข้าหา IR แล้วนับพิกเซลสว่างตอนเปิด/ปิด **ใช้ข้อนี้แทนการทดสอบ IR filter ด้วยรีโมททีวีได้เลย**

**ก่อนเสียบ USB ทุกครั้ง ให้ตรวจ 2 เส้นนี้ซ้ำ:** 5V อยู่**ซ้าย**แถว 1 และ GND อยู่**ขวา**แถว 1 ถ้าสลับกันจะทำให้ไฟ USB ลัดวงจร และถ้าสาย GPIO เส้นไหนเสียบผิดไปลงแถว 5V ขานั้นของ ESP32 จะเสีย

## ตาราง header v1 ครบ 20 แถว

| แถว | ซ้าย (U5) | ขวา (U6) |
|---|---|---|
| 1 | 5V | GND |
| 2 | GPIO14 | GPIO19 |
| 3 | GPIO13 | GPIO20 |
| 4 | GPIO12 | GPIO21 |
| 5 | GPIO11 | GPIO47 |
| 6 | GPIO10 | GPIO48 |
| 7 | GPIO9 | GPIO45 |
| 8 | GPIO46 | GPIO0 |
| 9 | GPIO3 | GPIO35 |
| 10 | GPIO8 | GPIO36 |
| 11 | GPIO18 | GPIO37 |
| 12 | GPIO17 | GPIO38 |
| 13 | GPIO16 | GPIO39 |
| 14 | GPIO15 | GPIO40 |
| 15 | GPIO7 | GPIO41 |
| 16 | GPIO6 | GPIO42 |
| 17 | GPIO5 | GPIO2 |
| 18 | GPIO4 | GPIO1 |
| 19 | RST | GPIO44 |
| 20 | 3V3 | GPIO43 |
