Franknakub/driver-drowsiness-detection/docs/archive/early-design/build-guide-lcsc.html

Group 17 · Build Guide

# 🔧 คู่มือประกอบ + LCSC Part

Driver Drowsiness Detection · ESP32-S3 + OV5640 · แต่ละบล็อกมีทั้ง รายการอุปกรณ์ (พร้อมรหัส LCSC) และ ผังต่อสาย อยู่ด้วยกัน — วาดใน EasyEDA ตามได้เลยทีละบล็อก

PCB 80×70mm 2-Layer FR4 6 บล็อก ~37 parts Trace 12mil (0.30mm) 🖱️ คลิกรหัส C… = copy

🔴 อ่านก่อนเริ่ม: รหัส LCSC ด้านล่างเป็นรหัสที่ใช้กันทั่วไป แต่ stock เปลี่ยนตลอด — ก่อนสั่งจริงให้เข้า jlcpcb.com/parts ค้นทีละรหัสยืนยันว่า Stock > 0
ช่องที่เป็น ค้นด้วยชื่อ คือ part ที่รหัสไม่นิ่ง ให้พิมพ์ชื่อค้นใน EasyEDA แทน

🏷️ ป้ายกำกับ: Basic ฟรีค่า setup · Extended มีค่า setup ~$3/ตัว · ซื้อแยก JLCPCB ไม่มี ต้องบัดกรีเอง

1

## ⚡ Power Supply

12V จากรถ → 5V → 3.3V · วาดบล็อกนี้ก่อนเสมอ ถ้าผิดทั้งบอร์ดใช้ไม่ได้

อุปกรณ์ที่ต้องใช้

REF | LCSC | ชื่อ Part | QTY | ประเภท | หน้าที่
J1 | DC Jack 5.5 2.1 | DC Barrel Jack | 1 | ซื้อแยก | รับไฟ 12V
D1 | SMBJ15A | TVS Diode 15V | 1 | Extended | ป้องกัน surge
U1 | C133974 | MP1584EN | 1 | Extended | Buck 12V→5V 3A
L1 | 4.7uH 3A inductor | Power Inductor 4.7µH | 1 | Extended | Isat ต้อง > 3A
D2 | C8678 | SS34 Schottky 40V 3A | 1 | Basic | Freewheeling
U2 | C6186 | AMS1117-3.3 | 1 | Basic | LDO 5V→3.3V
R1 | C25741 | Resistor 100kΩ 0402 | 1 | Basic | FB divider บน
R2 | C25768 | Resistor 22kΩ 0402 | 1 | Basic | FB divider ล่าง → 5V
C1,C2 | C16780 | Cap 100µF 25V | 2 | Extended | Bulk in/out
C3–C6 | C15850 | Cap 10µF 25V 0805 | 4 | Basic | Bypass ทุก rail
C7 | C1548 | Cap 3.3nF 0402 | 1 | Basic | MP1584 COMP

ผังต่อสาย

J1 (12V IN) │ ├──[D1 TVS]──GND ← ขนานกับไฟเข้า ├──[C1 100µF]──GND │ └──► U1 MP1584EN VIN ── 12V EN ── 12V ← เปิดตลอด SW ──┬──[L1 4.7µH]──┬──► +5V │ │ └──[D2 SS34]─── GND (cathode ชี้ไป SW) FB ──[R1 100k]── +5V └───[R2 22k]─── GND COMP ──[C7 3.3nF]── GND GND ── GND +5V ──[C2 100µF]──GND +5V ──[C3 10µF]───GND │ └──► U2 AMS1117-3.3 IN ── +5V ──[C4 10µF]──GND OUT ── +3.3V ──[C5 10µF]──GND GND ── GND ─────────── ไฟไปไหนบ้าง ─────────── +5V ──► Buzzer, IR LED, OV5640 module +3.3V ──► ESP32-S3, OLED, LDR

⚠️ สูตรคำนวณ output voltage: Vout = 0.8 × (1 + R1/R2) = 0.8 × (1 + 100k/22k) ≈ 4.44V — ถ้าอยากได้ 5V เป๊ะให้ใช้ R1=100k, R2=19.1k หรือ R1=105k, R2=20k

2

## 🧠 MCU — ESP32-S3

สมองของระบบ + วงจร reset/boot + decoupling

อุปกรณ์ที่ต้องใช้

REF | LCSC | ชื่อ Part | QTY | ประเภท | หน้าที่
U3 | C2913202 | ESP32-S3-WROOM-1-N16R8 | 1 | Extended | ⭐ MCU หลัก ✅ยืนยันแล้ว
R3–R5 | C25744 | Resistor 10kΩ 0402 | 3 | Basic | EN + BOOT pull-up
C8 | C15850 | Cap 10µF 0805 | 1 | Basic | EN reset delay
C9–C11 | C1525 | Cap 100nF 0402 | 20 | Basic | ⭐ Decoupling ทุก VCC
SW1,SW2 | C318884 | Tact Switch 6×6mm | 2 | Basic | RESET + BOOT

ผังต่อสาย

U3 ESP32-S3-WROOM-1-N16R8 3V3 ──┬── +3.3V ├──[C9 100nF]──GND ← วางติด pin ห่างไม่เกิน 2mm! ├──[C10 100nF]─GND └──[C11 10µF]──GND EN ──┬──[R3 10k]── +3.3V ├──[C8 10µF]── GND ← หน่วงเวลา reset └──[SW1 RESET]─ GND GPIO0 ┬──[R4 10k]── +3.3V └──[SW2 BOOT]── GND GND ── GND plane (ต่อทุก GND pin + thermal pad ใต้ module)

🚫 GPIO ห้ามใช้เด็ดขาด: 26–37
GPIO 26–32 = SPI Flash ภายใน · GPIO 33–37 = Octal PSRAM ของรุ่น R8
ถ้าต่ออะไรเข้าไป บอร์ดจะ boot ไม่ขึ้น — ในตาราง pinout บล็อกถัดไปผมเลี่ยงให้หมดแล้ว

3

## 📷 Camera — OV5640

5MP Autofocus · DVP 8-bit interface · FPC 24-pin

🔴 จุดที่พลาดกันมากที่สุด!
OV5640 sensor เปล่าต้องการ 3 แรงดัน: AVDD 2.8V + DOVDD 1.8V + DVDD 1.5V → ต้องออกแบบ LDO เพิ่ม 3 ตัว
👉 ทางแก้ที่แนะนำ: ซื้อ OV5640 module ที่มี LDO onboard มาแล้ว — จ่ายแค่ 3.3V เข้าไปพอ ประหยัดเวลาไปเยอะมาก

อุปกรณ์ที่ต้องใช้

REF | LCSC | ชื่อ Part | QTY | ประเภท | หน้าที่
CAM1 | OV5640 DVP module | OV5640 Camera Module | 1 | ซื้อแยก | ⭐ เลือกแบบมี LDO onboard
J2 | FPC 24P 0.5mm | FFC/FPC Connector 24P ZIF | 1 | Extended | ⚠️ เช็ค top/bottom contact
R6,R7 | C25900 | Resistor 4.7kΩ 0402 | 2 | Basic | SCCB pull-up
C12–C16 | C52923 | Cap 1µF 0402 | 5 | Basic | Bypass camera rail
FB1,FB2 | ferrite bead 600R 0402 | Ferrite Bead 600Ω | 2 | Basic | กรอง noise เข้ากล้อง

ตารางต่อสาย FPC → ESP32-S3

FPC PIN | สัญญาณ | → GPIO | ทิศทาง | หมายเหตุ | Net Name
9 | XCLK | GPIO 15 | OUT | Clock 20MHz ป้อนกล้อง | CAM_XCLK
19 | PCLK | GPIO 13 | IN | Pixel clock | CAM_PCLK
21 | VSYNC | GPIO 6 | IN | Frame sync | CAM_VSYNC
20 | HREF | GPIO 7 | IN | Line valid | CAM_HREF
11 | Y2 (D0) | GPIO 11 | IN | Data bit 0 | CAM_D0
12 | Y3 (D1) | GPIO 9 | IN | Data bit 1 | CAM_D1
13 | Y4 (D2) | GPIO 8 | IN | Data bit 2 | CAM_D2
14 | Y5 (D3) | GPIO 10 | IN | Data bit 3 | CAM_D3
15 | Y6 (D4) | GPIO 12 | IN | Data bit 4 | CAM_D4
16 | Y7 (D5) | GPIO 18 | IN | Data bit 5 | CAM_D5
17 | Y8 (D6) | GPIO 17 | IN | Data bit 6 | CAM_D6
18 | Y9 (D7) | GPIO 16 | IN | Data bit 7 | CAM_D7
3 | SIOD (SDA) | GPIO 4 | I/O | + pull-up 4.7k | CAM_SDA
4 | SIOC (SCL) | GPIO 5 | OUT | + pull-up 4.7k | CAM_SCL
8 | PWDN | GPIO 21 | OUT | Power down control | CAM_PWDN
6 | RESET | +3.3V | — | ผ่าน R 10k + C 100nF | CAM_RST
1,10,22–24 | GND | GND | — | ต่อ ground plane | GND
2,5,7 | VDD rails | +3.3V | — | ถ้า module มี LDO onboard | +3V3

⚠️ ก่อนวาดจริง: pinout FPC ต่างกันตามผู้ผลิต module — ต้องหา datasheet ของ module ที่จะซื้อจริง มายืนยันก่อนเสมอ ตารางนี้เป็น pinout มาตรฐาน OV5640

4

## 🖥️ I2C Bus — OLED + LDR

OLED แสดงผล · LDR วัดแสงคุม IR LED · ไม่ใช้ IMU

อุปกรณ์ที่ต้องใช้

REF | LCSC | ชื่อ Part | QTY | ประเภท | หน้าที่
R8,R9 | C25900 | Resistor 4.7kΩ 0402 | 2 | Basic | I2C pull-up สำหรับ OLED
J3 | C2337 | Pin Header 2.54mm 1×4 | 1 | Basic | ต่อ OLED module
OLED1 | OLED 0.96 I2C SSD1306 | OLED 128×64 | 1 | ซื้อแยก | แสดงผล (addr 0x3C)
LDR1 | GL5528 | LDR Photoresistor | 1 | ซื้อแยก | วัดระดับแสง
R10 | C25744 | Resistor 10kΩ 0402 | 1 | Basic | LDR voltage divider

ผังต่อสาย

+3.3V ├──[R8 4.7k]──┬──► I2C_SDA ──► GPIO 1 ├──[R9 4.7k]──┼──► I2C_SCL ──► GPIO 2 │ │ │ └──► J3 Header → OLED addr 0x3C │ 1 VCC ─ +3.3V │ 2 GND ─ GND │ 3 SDA ─ I2C_SDA │ 4 SCL ─ I2C_SCL │ GND ──────────── LDR วัดแสง ──────────── +3.3V ──[LDR1]──┬──► GPIO 3 (ADC1_CH2) │ [R10 10k] │ GND มืด → LDR ต้านทานสูง → ADC ต่ำ → เปิด IR LED สว่าง → LDR ต้านทานต่ำ → ADC สูง → ปิด IR LED

⚠️ ตัด IMU ออกแล้ว — GPIO 21, 22 ที่เคยจอง I2C ไว้ตอนนี้ว่างขึ้น เอาไปใช้กับอย่างอื่นได้ (เช่น vibration motor หรือ SD card)
ระบบตรวจจับความง่วงจากกล้องอย่างเดียว ผ่าน EAR + PERCLOS + blink rate + การหาว

5

## 🔔 Output — Buzzer + LED + IR

แจ้งเตือนเมื่อตรวจพบง่วง + ไฟส่องกลางคืน

อุปกรณ์ที่ต้องใช้

REF | LCSC | ชื่อ Part | QTY | ประเภท | หน้าที่
BZ1 | active buzzer 5V | Active Buzzer 5V | 1 | ซื้อแยก | ⚠️ ต้อง Active ไม่ใช่ Passive
Q1 | C20917 | AO3400A N-MOSFET | 1 | Basic | สวิตช์ Buzzer
Q2 | C2150 | S8050 NPN 500mA | 1 | Basic | สวิตช์ IR LED array
R11,R12 | C25744 | Resistor 10kΩ 0402 | 2 | Basic | Gate + pull-down
R13 | C11702 | Resistor 1kΩ 0402 | 1 | Basic | NPN base resistor
D3 | C2297 | LED Green 0805 | 1 | Basic | สถานะ Alert (ตื่น)
D4 | C2286 | LED Red 0805 | 1 | Basic | สถานะ Drowsy (ง่วง)
R14,R15 | C25117 | Resistor 220Ω 0402 | 2 | Basic | LED current limit
IR1–IR4 | TSAL6200 | IR LED 850nm | 4 | Extended | ส่องหน้ากลางคืน
R16–R19 | C25076 | Resistor 100Ω 0402 | 4 | Basic | IR LED current limit

ผังต่อสาย

━━━━━━ BUZZER ━━━━━━ +5V ──► BZ1(+) BZ1(−) ──► Drain Q1 AO3400A Source ── GND Gate ──[R11 10k]── GPIO 14 Gate ──[R12 10k]── GND ↑ R12 pull-down กัน buzzer ดังตอน boot ━━━━━━ LED สถานะ ━━━━━━ GPIO 47 ──[R14 220Ω]──►|── GND D3 เขียว (Alert) GPIO 48 ──[R15 220Ω]──►|── GND D4 แดง (Drowsy) ━━━━━━ IR LED ARRAY ━━━━━━ +5V ──┬──[R16 100Ω]──►|── ┐ IR1 ├──[R17 100Ω]──►|── ┤ IR2 ├──[R18 100Ω]──►|── ┤ IR3 └──[R19 100Ω]──►|── ┘ IR4 │ Collector Q2 S8050 Emitter ── GND Base ──[R13 1k]── GPIO 42 กระแสรวม IR = 4 × ~30mA = 120mA S8050 รับได้ 500mA ✓ เหลือเฟือ

6

## 🔌 USB-C + ปุ่มกด

Programming, debug และปุ่มควบคุม

อุปกรณ์ที่ต้องใช้

REF | LCSC | ชื่อ Part | QTY | ประเภท | หน้าที่
J4 | C165948 | USB-C Receptacle 16P | 1 | Basic | Programming + Debug
U5 | C2827693 | USBLC6-2SC6 | 1 | Basic | ESD protection
R20,R21 | C25905 | Resistor 5.1kΩ 0402 | 2 | Basic | ⚠️ CC1/CC2 ขาดไม่ได้!
D5 | C8678 | SS34 Schottky | 1 | Basic | กัน backfeed จาก USB
SW3 | C318884 | Tact Switch 6×6mm | 1 | Basic | ปุ่ม USER (เปิด/ปิด)
J5,J6 | C124378 | Pin Header 2.54mm 1×8 | 2 | Basic | Debug / Test point

ผังต่อสาย

J4 USB-C Receptacle (16P) VBUS ──[D5 SS34]──► +5V ← กัน backfeed GND ──► GND CC1 ──[R20 5.1k]── GND ← ขาดไม่ได้! CC2 ──[R21 5.1k]── GND ← ขาดไม่ได้! D− ──► U5 USBLC6 ──► GPIO 19 D+ ──► U5 USBLC6 ──► GPIO 20 SHIELD──[C 100nF]── GND ━━━━━━ ปุ่มกด 3 ตัว ━━━━━━ SW1 RESET ── EN ── GND SW2 BOOT ── GPIO 0 ── GND SW3 USER ── GPIO 41 ── GND (pull-up internal)

🔴 R 5.1kΩ ที่ CC1/CC2 = จุดพลาดอันดับ 1 ของมือใหม่
ถ้าลืมใส่ 2 ตัวนี้ USB-C charger/คอมจะไม่จ่ายไฟให้บอร์ดเลย เพราะไม่รู้ว่ามีอุปกรณ์ต่ออยู่ — เช็คให้ดีก่อนสั่ง PCB

07

## 📐 ผังวาง PCB (80×70mm)

◄─────────────── 80 mm ───────────────► ┌──────────────────────────────────────────┐ ▲ │ ╔══════════╗ │ │ │ ║ ANTENNA ║ ┌────────────────┐ │ │ │ ║ KEEPOUT ║ │ J2 FPC 24P │ │ │ │ ║ ห้ามมี ║ │ → OV5640 │ │ │ │ ║ copper! ║ └────────────────┘ │ │ │ ╚══════════╝ │ │ │ ┌──────────────────┐ ◉ ◉ ◉ ◉ │ 70 │ │ U3 ESP32-S3 │ IR1 IR2 IR3 IR4 │ mm │ │ WROOM-1 N16R8 │ │ │ │ │ │ ┌──────────┐ │ │ │ └──────────────────┘ 🌗 LDR1 │ │ │ └──────────┘ │ │ │ ┌────────────┐ 🔔BZ1 ┌────────────┐ │ │ │ │ POWER │ │ J3 → OLED │ │ │ │ │ U1 MP1584 │ └────────────┘ │ │ │ │ U2 AMS1117 │ ●● [SW1][SW2][SW3] │ │ │ └────────────┘ D3D4 │ │ │ [J1 DC] [J4 USB-C] │ ▼ └──────────────────────────────────────────┘ ↑ 12V เข้า ↑ programming

08

## 📏 Design Rules (ตามที่อาจารย์กำหนด)

🔴 อาจารย์กำหนดเข้มกว่า JLCPCB minimum
JLCPCB ทำได้ต่ำสุด 4mil (0.10mm) แต่อาจารย์เขียนโน้ตไว้ว่า 6mil = ขั้นต่ำที่ยอมรับ และ 12mil ++ = ค่าที่ควรใช้จริง
เหตุผล: track width tolerance ของโรงงานคือ ±20% — ถ้าออกแบบ 4mil อาจได้จริงแค่ 3.2mil เส้นบางเกินไป เสี่ยงขาด/กระแสไม่พอ

ตารางเทียบ — ค่าที่เราต้องใช้

รายการ | JLCPCB MIN | อาจารย์กำหนด | ที่เราใช้ | = mil | สถานะ
Signal trace ทั่วไป | 0.10mm (4mil) | 12 mil ++ | 0.30 mm | 11.8 | ✅ ผ่าน
Clearance (ระยะห่าง) | 0.10mm (4mil) | 6 mil ขั้นต่ำ | 0.20 mm | 7.9 | ✅ ผ่าน
Power trace 3.3V | 0.10mm | 12 mil ++ | 0.50 mm | 19.7 | ✅ ผ่าน
Power trace 5V / 12V | 0.10mm | 12 mil ++ | 0.80 mm | 31.5 | ✅ ผ่าน
PTH Annular Ring | ≥0.20mm | ≥0.20mm | 0.25 mm | 9.8 | ✅ เผื่อแล้ว
Drill Diameter (via) | 0.15mm | ยิ่งใหญ่ยิ่งถูก | 0.30 mm | 11.8 | ✅ ถูกกว่า
Via Diameter (pad) | — | drill + 2×ring | 0.60 mm | 23.6 | ✅ ผ่าน
FPC 0.5mm pitch zone | 0.10mm | 6 mil ขั้นต่ำ | 0.15 mm | 5.9 | ⚠️ เฉพาะจุด

⚠️ ข้อยกเว้นเดียว — FPC Connector
FPC 24-pin pitch 0.5mm มี pin ห่างกันแค่ 0.5mm → route ด้วย 0.30mm ไม่ได้ ต้องใช้ 0.15mm เฉพาะช่วงสั้นๆ ใกล้ connector แล้วขยายเป็น 0.30mm ทันทีที่พ้นออกมา
👉 วิธีทำ: ตั้ง Net Class แยกใน EasyEDA (ดูขั้นตอนด้านล่าง)

ค่าที่ต้องตั้งใน EasyEDA

Design → Design Rule → Rule Setting ━━ Default Rule (ใช้กับ net ทั่วไป) ━━ Track Width .............. 0.30 mm (12 mil) Clearance ................ 0.20 mm (8 mil) Via Diameter ............. 0.60 mm Via Drill Diameter ....... 0.30 mm Hole to Hole Clearance ... 0.50 mm Track to Hole ............ 0.25 mm ━━ Net Class: POWER ━━ (กำหนดให้ net: +12V, +5V, +3V3, GND) Track Width .............. 0.80 mm (31 mil) Clearance ................ 0.25 mm ━━ Net Class: FPC_CAM ━━ (กำหนดให้ net: CAM_D0–D7, CAM_PCLK, CAM_XCLK, CAM_VSYNC, CAM_HREF, CAM_SDA, CAM_SCL) Track Width .............. 0.15 mm (6 mil — ขั้นต่ำ) Clearance ................ 0.15 mm ⚠️ ใช้เฉพาะช่วงใกล้ connector เท่านั้น พ้นออกมาแล้วขยายเป็น 0.30 mm ทันที

วิธีตั้ง Net Class ใน EasyEDA

เปิด Design Rule Managerเมนู Design → Design Rule → จะเห็นแท็บ Rule / Net Class

สร้าง Rule ใหม่ 2 อันกด + เพิ่ม rule ชื่อ POWER และ FPC_CAM แล้วใส่ค่าตามตารางด้านบน

สร้าง Net Class แล้วผูกกับ Ruleแท็บ Net Class → สร้าง class ชื่อเดียวกัน → ลาก net ที่เกี่ยวข้องเข้าไป → เลือก Rule ที่ตรงกัน

รัน DRC ตรวจสอบCtrl+Shift+D หรือ Design → Check DRC — ต้องได้ 0 error ก่อนส่ง Gerber

09

## ⚠️ กฎ Layout ที่ห้ามพลาด

Antenna Keepout — พลาดแล้ว WiFi ตายเว้นพื้นที่ใต้และรอบเสาอากาศ ESP32-S3 อย่างน้อย 3mm ห้ามมี copper pour / trace / via ทั้ง top และ bottom layer

Decoupling cap ต้องติดชิด pinC 100nF ห่างจาก VCC pin ไม่เกิน 2mm — ถ้าวางไกลจะไม่มีผลเลย

Camera DVP ความยาวใกล้เคียงกันเส้น D0–D7 + PCLK ควรยาวต่างกันไม่เกิน ±5mm กัน timing skew

GND Plane เต็ม bottom layerเท copper pour GND ทั้งชั้นล่าง + โรย via stitching ทุกๆ 5–10mm (via 0.6/0.3mm)

Power trace ใช้ Net Class POWER12V/5V/3.3V/GND ตั้งเป็น 0.80mm ผ่าน Net Class — อย่า route ด้วยค่า default

Switching loop ของ DC-DC ให้เล็กวง VIN → SW → L1 → C2 ให้สั้นที่สุด และวางห่างจาก ESP32 กับกล้อง

USB D+/D− เป็น differential pairวางขนานกัน ระยะห่างคงที่ ความยาวเท่ากัน (90Ω differential)

10

## 🚀 ลำดับการทำใน EasyEDA

เช็ค stock ทุก part ก่อนเข้า jlcpcb.com/parts ค้นทีละรหัส ดู Stock > 0 — ถ้าหมดต้องหาตัวแทนตั้งแต่ตอนนี้ ไม่ใช่ตอน order

สร้าง Project + เปิด Library แท็บ LCSCeasyeda.com → New Project → New Schematic → กด Shift+F → เลือกแท็บ LCSC (สำคัญ! จะได้ symbol + footprint + part number ครบ)

วาด Block 1 (Power) ให้เสร็จก่อนตรวจ 2 รอบก่อนไปต่อ ถ้า power ผิดทั้งบอร์ดใช้ไม่ได้

วาด Block 2–6 ตามลำดับใช้ Net Label (กด N) แทนลากสายยาว — ชื่อเดียวกันเชื่อมกันอัตโนมัติ อ่านง่ายกว่ามาก

รัน ERC ให้ได้ 0 errorDesign → Check ERC — warning พอรับได้ แต่ error ต้องเป็น 0

Convert to PCB + ตั้ง Design Rule ก่อน routeตั้ง board outline 80×70mm → ตั้ง Design Rule ตามตารางข้อ 08 ก่อน → วางตามผัง → route ด้วยมือ (อย่าใช้ auto-route)

DRC → Export Gerber + BOM + CPL → JLCPCBOne-click order จาก EasyEDA ได้เลย เลือก PCBA assembly

✅ ทางลัดที่แนะนำมาก: เปิด ESP32-S3-EYE schematic ของ Espressif ควบคู่ไปด้วย (github.com/espressif/esp-who) — เป็น reference design ที่ผ่านการทดสอบจริงแล้วสำหรับ ESP32-S3 + camera โดยเฉพาะ

Group 17 · Driver Drowsiness Detection · Build Guide v1.0 · ตรวจ stock ที่ jlcpcb.com/parts ก่อนสั่งทุกครั้ง

💡 คลิกรหัส C… เพื่อ copy
