Franknakub/driver-drowsiness-detection/docs/archive/early-design/schematic-guide.html

Embedded System 2026 · กลุ่ม 17 · ม.เกษตรศาสตร์ ศรีราชา

# Driver Drowsiness Detection ระบบตรวจจับความง่วงของคนขับด้วยกล้อง + TinyML — แนวทางต่อ Schematic

กล้องจับภาพ→วัดการหลับตา→รวมกับ IMU→ตัดสินระดับ→เตือนด้วยเสียง

## 01ระบบทำงานยังไง

อุปกรณ์แบ่งเป็น 3 กลุ่ม — ตัวรับข้อมูล ตัวประมวลผล และตัวแจ้งเตือน โดยมี IR LED เป็นตัวช่วยพิเศษที่ทำงานเฉพาะตอนมืด

ผังการทำงาน — INPUT / PROCESS / OUTPUT และวงจร Night Mode

ทำไมไม่ใช้ไฟส่องหน้าปลุก

ตาที่ปรับให้ชินกับความมืดแล้ว เจอไฟสว่างจ้าจะมองไม่เห็นถนนไปราว 5–10 วินาที และคนที่กำลังงีบจะสะดุ้งจนอาจหักพวงมาลัย คนง่วงที่มองไม่เห็นถนน อันตรายกว่าคนง่วงที่ยังมองเห็น ระบบนี้จึงใช้เสียงเป็นตัวปลุกหลัก และ IR LED ทำหน้าที่ให้กล้องมองเห็นเท่านั้น

## 02อุปกรณ์แต่ละตัวทำอะไร

สรุปหน้าที่ ขา GPIO ที่ใช้ และวิธีเชื่อมต่อบนบอร์ด

อุปกรณ์ | หน้าที่ | ขาที่ใช้ | ต่อผ่าน
OV5640 | ถ่ายภาพใบหน้าส่งให้โมเดลวัดการหลับตา | 16 ขา DVP | FPC 24P
MPU-6050 | ตรวจหัวตกและหัวเอียง เสริมตอนกล้องมองไม่ชัด | GPIO1 GPIO42 | Header 1×4
OLED | แสดงค่า EAR และระดับการเตือน | GPIO1 GPIO42 | Header 1×4 (P1)
Buzzer | เสียงเตือน — ตัวปลุกหลัก | GPIO14 | Header 1×3
LED เขียว | บอกว่าระบบทำงานปกติ | GPIO47 | บน PCB
LED แดง | กะพริบเตือนที่ขอบสายตา | GPIO40 | บน PCB
IR LED ×4 | ส่องหน้าให้กล้องเห็นตอนกลางคืน | GPIO21 | บน PCB
ปุ่ม USER | รีเซ็ต / สลับโหมด | GPIO41 | บน PCB

ทำไม OLED กับ MPU6050 ใช้ขาเดียวกันได้ — I2C เป็นบัสที่ต่อขนานกันได้หลายตัว แต่ละตัวมีที่อยู่ไม่ซ้ำกัน (OLED = 0x3C, MPU6050 = 0x68) ESP32 จึงเรียกทีละตัวได้บนสายคู่เดียว

## 03ตรรกะการเตือน 4 ระดับ

คะแนนความง่วงมาจาก EAR ของกล้อง 70% รวมกับสัญญาณจาก IMU 30% แล้วแมปเป็นระดับ

0ปกติ

#### ตื่นดี

EAR ≥ 0.20 · ศีรษะตรง

บัซเซอร์ เงียบLED เขียว ติดค้างOLED แสดง OK

1เริ่มล้า

#### กะพริบตาช้าลง

ตาหลับต่อเนื่อง 0.5–1.0 วินาที

ปี๊บสั้น 1 ครั้งLED เขียว กะพริบ

2ง่วง

#### หลับตานาน

ตาหลับต่อเนื่อง 1.0–2.0 วินาที

ปี๊บ 2 ครั้ง/วินาทีLED แดง กะพริบ

3อันตราย

#### หลับแล้ว

ตาหลับ > 2.0 วินาที หรือ IMU ตรวจพบหัวตก

เสียงยาวต่อเนื่องLED แดง ติดค้างแจ้งเตือนออนไลน์

ทำไมต้องมี IMU ด้วย — กล้องพลาดได้หลายกรณี เช่น คนขับใส่แว่นกันแดด แสงจากไฟหน้ารถสวนทำให้ภาพขาว หรือหันหน้าออกจากกล้อง IMU ไม่สนใจแสงเลย จับได้แค่การเคลื่อนไหว จึงเป็นตัวสำรองที่ทำงานได้เสมอ

## 04แนวทางต่อ Schematic

แยกเป็นบล็อก ทำทีละบล็อกแล้วตรวจก่อนไปบล็อกถัดไป ป้ายชื่อ net ให้สะกดเหมือนกันเป๊ะทุกที่ ตัวพิมพ์ใหญ่เล็กมีผล

หลักการที่ใช้ทั้งบอร์ด — บอร์ด GOOUUU เสียบลงบน socket U5/U6 ซึ่งทำให้รูเต็ม อุปกรณ์ที่จะเสียบเพิ่มทีหลังจึงต้องมี header ของตัวเองบน PCB โดยลากสายจาก socket มาเข้า header นั้น

### A · I2C — OLED และ MPU-6050

P1 เสร็จแล้ว

บัส I2C เส้นเดียวรองรับทั้งสองตัว วาง header สองชุดขนานกันบนเส้นเดิม

ขา Header | Net | หมายเหตุ
1 | 3V3 | ห้ามใช้ 5V — MPU6050 พัง
2 | GND
3 | GPIO01 | SDA
4 | GPIO42 | SCL

1. วาง header 1×4 ตัวใหม่ ตั้งชื่อ J4 (ค้นหา HDR-TH_4P-P2.54-V-M)
2. ลากสายจาก J4 ไปเข้า net ทั้ง 4 ตามตาราง — ใช้ net เดียวกับ P1 ได้เลย
3. Pull-up R4/R5 4.7kΩ มีอยู่แล้ว ไม่ต้องเพิ่มอีก

ก่อนวาด หยิบโมดูลจริงมาอ่านตัวหนังสือข้างขา ลำดับขาไม่เหมือนกันทุกยี่ห้อ — ต่อ VCC กับ GND สลับกันคือพังทันทีที่เสียบ

### B · Buzzer

ต้องเพิ่ม

ใช้โมดูลสำเร็จรูป KY-012 Active Buzzer ซึ่งมีทรานซิสเตอร์ขับในตัวแล้ว จึงไม่ต้องมี MOSFET บนบอร์ด

ขา Header | Net
1 | 5V
2 | GND
3 | GPIO14

1. ลบ Q2 (AO3400A), R1, R2 ออก — บั๊ก gate ลอยจะหายไปพร้อมกัน
2. วาง header 1×3 ตั้งชื่อ J2 (HDR-TH_3P-P2.54-V-M)
3. เพิ่ม R 10kΩ 0805 จาก GPIO14 ลง GND กันบัซเซอร์ร้องตอนบูต

ต้องเป็น Active ไม่ใช่ Passive — KY-012 คือ active (จ่ายไฟแล้วร้องเลย) ส่วน KY-006 เป็น passive ต้องส่ง PWM ถึงจะมีเสียง

### C · IR LED — วงจรขับ

เสร็จแล้ว

เป็น low-side switch มาตรฐาน กระแสไหลลงจาก 5V ผ่าน LED แล้วออกที่ทรานซิสเตอร์

จุด | ต่อกับ
รางบน | 5V → R16–R19 120Ω 1206
IR1–IR4 | anode รับจาก R · cathode ลงรางล่าง
รางล่าง | Q3 collector
Q3 emitter | GND
Q3 base | R3 1kΩ ← GPIO21

กระแสต่อดวง ≈ 29mA รวม 4 ดวง ≈ 116mA ซึ่ง SS8050 รับได้ถึง 700mA

### D · LED สถานะ

เสร็จแล้ว

LED | เส้นทาง
เขียว (LED1) | GPIO47 → R11 470Ω → LED1 → GND
แดง (LED2) | GPIO40 → R12 470Ω → LED2 → GND

ตอนวาง PCB วาง LED แดงไว้ริมบอร์ดหันออกด้านข้าง อย่าหันเข้าหน้าคนขับ — ให้เห็นด้วยหางตาก็พอ

### E · ปุ่ม USER

ต้องเพิ่ม

1. วาง Tactile switch 6×6mm ตั้งชื่อ SW1 ขาหนึ่งไป GPIO41 อีกขาไป GND
2. เพิ่ม R 10kΩ จาก GPIO41 ขึ้น 3V3 เป็น pull-up
3. เพิ่ม C 100nF คร่อมปุ่ม ช่วย debounce

ในโค้ดใช้ INPUT_PULLUP แล้วอ่านค่า LOW เมื่อกด

### F · กล้อง OV5640 — FPC 24P

เสี่ยงสุด

สายกล้อง 16 เส้นต้องเรียงตรงตาม pinout ที่กำหนดไว้ ตรวจซ้ำทีละเส้นก่อนสั่งผลิต

สัญญาณ | GPIO | สัญญาณ | GPIO
XCLK | 15 | D0 / Y2 | 11
PCLK | 13 | D1 / Y3 | 9
VSYNC | 6 | D2 / Y4 | 8
HREF | 7 | D3 / Y5 | 10
SIOD | 4 | D4 / Y6 | 12
SIOC | 5 | D5 / Y7 | 18
PWDN | ไม่ต่อ | D6 / Y8 | 17
RESET | ไม่ต่อ | D7 / Y9 | 16

จุดที่พลาดแล้วบอร์ดใช้ไม่ได้เลย

คอนเนคเตอร์ FPC มีสองแบบ — top contact กับ bottom contact ถ้าเลือกผิดด้าน สายกล้องจะเสียบกลับข้าง แก้ไม่ได้ ต้องสั่งบอร์ดใหม่ ตรวจให้ชัดในหน้าสินค้า LCSC ก่อนวาง

ต้องทดสอบก่อนสั่ง PCB — โมดูล OV5640 ส่วนใหญ่มี IR-cut filter ที่บล็อกแสงอินฟราเรดทั้ง 850 และ 940nm ถ้าโมดูลที่มีอยู่มีฟิลเตอร์ IR LED ทั้ง 4 ดวงจะไม่ช่วยอะไรเลย ให้ทดลองส่อง IR ในที่มืดแล้วดูว่าภาพสว่างขึ้นไหม ถ้าไม่ ต้องหาโมดูลรุ่น no IR filter หรือ night vision

### G · ภาคจ่ายไฟ

ต้องเพิ่ม

ขั้น | อุปกรณ์ | จ่ายให้
12V → 5V | MP1584EN | ESP32, Buzzer, IR LED
5V → 3.3V | AMS1117-3.3 | MPU6050, OLED

- ใส่ C 100µF ที่อินพุต 12V และ C 22µF ที่เอาต์พุต 5V
- ใส่ C 100nF ใกล้ขาไฟของทุก IC
- ใส่ฟิวส์ 1A และ diode กันต่อกลับขั้วที่อินพุต — ไฟรถมีสัญญาณรบกวนสูงและอาจกระชากถึง 40V ตอนสตาร์ท

ห้ามให้ VBUS จาก USB ต่อตรงกับ net 5V ที่ MP1584EN จ่ายอยู่ ไฟสองแหล่งจะตีกัน ถ้าจะเก็บพอร์ต USB ไว้ต้องมี Schottky diode กั้น หรือตัดภาค USB-C กับ CH221K ออกไปเลยเพราะบอร์ด GOOUUU มี USB ของตัวเองอยู่แล้ว

## 05รายการงานคงเหลือ

เรียงตามลำดับที่ควรทำ — ข้อที่ติ๊กแล้วคือส่วนที่ตรวจ netlist แล้วผ่าน

- I2C — P1 OLED header + pull-up 4.7kΩ ต่อครบ
- IR LED — ขั้ว ทิศกระแส และขา Q3 ถูกต้อง
- LED เขียว GPIO47 · LED แดง GPIO40
- R16–R19 เปลี่ยนเป็น 120Ω ขนาด 1206
- ลบสายค้างที่ทำให้ GPIO21 ลัดกับ GPIO42 — คลิกเส้นที่ออกจาก U6 pin 34 แล้วดูว่าสาย SCL สว่างขึ้นด้วยไหม
- ลบ Q2, R1, R2 แล้ววาง header J2 1×3 สำหรับบัซเซอร์
- วาง header J4 1×4 สำหรับ MPU-6050
- เพิ่มปุ่ม USER + pull-up + debounce cap
- ทดสอบ IR กับกล้องจริง ก่อนตัดสินใจเรื่อง FPC
- วาง FPC 24P — ตรวจ top/bottom contact ให้ชัด
- เพิ่มภาคจ่ายไฟ MP1584EN + AMS1117 + ฟิวส์ + diode
- ตัดภาค USB-C และ CH221K ออก
- ผูก LCSC part number ให้ครบทุกตัว แล้วเช็ค stock
- รัน DRC ให้ผ่านหมด ไม่มี net ที่มีขาเดียว

ก่อนกดสั่งผลิต ตรวจสามอย่างนี้ให้ครบ — ทิศทาง FPC contact, ค่าตัวต้านทานทุกตัวและขนาด package, และ DRC ต้องไม่เหลือ error ทั้งสามข้อนี้คือสาเหตุที่บอร์ดกลับมาแล้วใช้ไม่ได้บ่อยที่สุด

Driver Drowsiness Detection with TinyML · กลุ่ม 17
Embedded System 03603323 · มหาวิทยาลัยเกษตรศาสตร์ วิทยาเขตศรีราชา · 2026
