Franknakub/driver-drowsiness-detection/firmware/DrowsyFW/config.h

// ค่าคงที่ทั้งหมดของ DrowsyFW: ขา GPIO, เกณฑ์เริ่มต้น, การจัด task
// คำศัพท์ตาม GLOSSARY.md ใน repo
#pragma once
#include <Arduino.h>

#define FW_VERSION "0.3.13-raw" // ไม่เกิน 15 ตัว (เก็บในหัวไฟล์ Trip)

// ---- GPIO (GPIO map ใน CLAUDE.md · ห้ามใช้ 26–37) ----
#define PIN_LED_GREEN 47
#define PIN_LED_RED   40
#define PIN_LDR        3    // ADC1 · R1 10k ขึ้น 3V3, LDR ลง GND -> มืด = ค่าสูง
#define PIN_BUZZER    14    // MH-FMD active-LOW: HIGH = เงียบ
#define PIN_IR        21    // base S8050 ผ่าน 1k: HIGH = IR ติด
#define PIN_OLED_SDA  42    // จอจริงต่อแบบนี้: Wire.begin(42, 1)
#define PIN_OLED_SCL   1
#define PIN_BOOT_BTN   0    // ปุ่ม BOOT บนโมดูล (กด = LOW) · ใช้เป็นปุ่มปิดเสียงหลังบูตแล้ว

// ---- กล้อง GOOUUU ESP32-S3-CAM ----
#define CAM_PIN_XCLK  15
#define CAM_PIN_SIOD   4
#define CAM_PIN_SIOC   5
#define CAM_PIN_D7    16
#define CAM_PIN_D6    17
#define CAM_PIN_D5    18
#define CAM_PIN_D4    12
#define CAM_PIN_D3    10
#define CAM_PIN_D2     8
#define CAM_PIN_D1     9
#define CAM_PIN_D0    11
#define CAM_PIN_VSYNC  6
#define CAM_PIN_HREF   7
#define CAM_PIN_PCLK  13

// ---- หาหน้า + ตา (ผล FaceSpike 16 ต.ค.) ----
#define CAM_FRAME_SIZE       FRAMESIZE_HVGA  // 480x320: ตาใหญ่ขึ้น ~1.5 เท่าจาก QVGA · FaceSpike วัดได้ 8.9 fps, หาหน้า ~49 ms
#define CAM_ROTATE_CW        270    // ภาพจากกล้องตะแคง 90° · หมุนรวมกับการย่อตอนหยิบพิกเซลเข้าโมเดลหาหน้า ไม่หมุนทั้งเฟรม
#define FACE_TILT_COMP       1      // หมุนภาพชดเชยหน้าเอียงตามมุมเส้นตา
#define FACE_MSR_SCORE_THR   0.30f  // ค่าเดิม 0.5 ตัดหน้าในภาพที่หมุนชดเชยทิ้ง
#define FACE_ROI             1      // ส่งแค่ส่วน 4:3 รอบหน้า/แถบค้นหาเข้า MSR แทนทั้งเฟรม (หน้าไกลใหญ่ขึ้น 2–4 เท่า) · 0 = ทั้งเฟรมแบบเดิม
#define FACE_ROI_SCALE       2.5f   // ความสูง ROI = 2.5 × ด้านยาวกรอบหน้าเฟรมก่อน (ต่ำสุด 120 = ไม่ขยายภาพ)
#define EYE_CROP_SCALE       0.8f   // ด้าน Eye Region = 0.8 × ระยะระหว่างจุดตา (ให้ใกล้ภาพ MRL · ml/README.md)
#define EYE_MIN_CROP_PX      10     // Eye Region เล็กกว่านี้ถือว่ามองไม่เห็นตา
#define P_CLOSED_ON          0.3f   // P(ตาปิด) ≥ ค่านี้ = ปิด · < P_CLOSED_OFF = เปิด · ผู้ใช้ตั้ง 4 พ.ย.: ตัดช่วงไม่แน่ใจ (0.3–0.5 นับเป็นปิด)
#define P_CLOSED_OFF         0.3f   //   ค่าชั่วคราวจาก ml/output/threshold_note.md (วัดบน MRL) ต้องปรับใหม่ด้วยภาพกล้องเรา

// ---- task: Core 1 = ภาพ/ML/Alert/เซนเซอร์ · Core 0 = WiFi stack, เว็บ, log, Sync ----
#define CORE_VISION 1
#define CORE_NET    0

#include "drowsy_config.h"   // เกณฑ์ความง่วง (แยกไฟล์ให้ทดสอบบน PC ได้)

// ---- LDR -> IR (hysteresis กัน IR กระพริบตอนแสงก้ำกึ่ง) · ยังไม่ได้คาลิเบรตกับของจริง ----
#define LDR_DARK_ON_RAW        2800   // ค่าสูงกว่านี้ = มืด เปิด IR
#define LDR_DARK_OFF_RAW       2400   // ค่าต่ำกว่านี้ = สว่าง ปิด IR
#define LDR_PERIOD_MS          500

// ---- OLED SSD1306 128x64 (I2C ขา 42/1) · ปุ่ม · ทดสอบฮาร์ดแวร์ ----
#define OLED_PERIOD_MS         200    // วาดจอใหม่ทุกเท่านี้ (ส่งทั้งจอ ~25 ms ที่ 400 kHz)
#define OLED_CONTRAST_DAY      0xCF
#define OLED_CONTRAST_DARK     1      // มืด (เกณฑ์ LDR เดียวกับ IR): หรี่จอไม่ให้แยงตาคนขับ
#define OLED_RETRY_MS          5000   // หาจอไม่เจอ: ลองใหม่ทุกเท่านี้ (สาย dupont หลุด/เสียบใหม่)
#define BTN_DEBOUNCE_MS        60     // กด BOOT ค้างเท่านี้จึงนับ = ปิดเสียง MUTE_DEFAULT_MS
#define HW_TEST_MS             3000   // ปุ่มทดสอบในหน้าเว็บ: ทำงานนานเท่านี้

// ---- เครือข่าย ----
#define NET_RETRY_MS           60000  // ลอง WiFi ที่บันทึกไว้ทุก 1 นาที
#define WIFI_SAVED_MAX         5      // WiFi ที่ตั้งจากหน้า /wifi (เก็บใน NVS) · secrets.h เป็นตัวสำรองต่อท้าย
#define WIFI_SCAN_MAX          15     // รายการ WiFi ใกล้เคียงที่ส่งให้หน้าเว็บ
#define WIFI_SCAN_TTL_MS       15000  // ผลสแกนใหม่กว่านี้ใช้ซ้ำ ไม่สแกนใหม่ (สแกนทำให้ AP สะดุดชั่วครู่)
#define MDNS_NAME              "drowsy"
#define TZ_THAILAND            "ICT-7"
#define TIME_VALID_EPOCH       1767225600UL  // 1 ม.ค. 2026: ก่อนหน้านี้ถือว่ายังไม่มีเวลาจริง

// ---- Sync ขึ้น Supabase (ADR 0002) · publishable key เป็นค่าสาธารณะโดยออกแบบ ใส่ใน repo ได้ ----
// สิทธิ์เขียนมาจาก DEVICE_SECRET ใน secrets.h ซึ่งฟังก์ชัน ingest เทียบกับ hash ในตาราง devices
#define SUPABASE_URL             "https://iatzjmxjbxcakotczoko.supabase.co"
#define SUPABASE_PUBLISHABLE_KEY "sb_publishable_ri55GXYeKSjVqd664DQpYg_l-1KVoK6"
#define SYNC_BATCH_SAMPLES     300    // ต่อ 1 ครั้ง (~12 KB JSON)
#define SYNC_BATCH_EVENTS      100
#define SYNC_IDLE_MS           30000  // ส่งของใหม่ทุก 30 วิ เมื่อไม่มีค้าง
#define SYNC_RETRY_MS          60000  // ส่งไม่สำเร็จ: รอเท่านี้ก่อนลองใหม่
