Franknakub/driver-drowsiness-detection/(commit log)

2026-10-02 Initial commit: hardware files, plans, and diagnostic sketch
    - hardware: EasyEDA project, Gerber/BOM/PnP (31 Aug ordered set + archives)
    - docs: firmware/ML/web/enclosure plan, project status, design reviews
    - firmware: DrowsinessDiag board + camera + IR filter test sketch
    - ml, enclosure: dataset notes and enclosure requirements
    [BOM_Board1_PCB1_1_2026-08-28.xlsx, BOM_Board1_PCB1_1_2026-08-31.xlsx, PickAndPlace_PCB1_1_2026_08_28.xlsx, PickAndPlace_PCB1_1_2026_08_31.xlsx]
2026-10-03 Add PCB v2 fabrication files and EasyEDA project
    v2 fixes the mirrored ESP32 module headers from v1, adds four M3
    mounting holes, moves H2 and feeds the buzzer from 3V3, re-routes
    with 0.30 mm tracks / 0.20 mm clearance, and stitches the GND pours.
    v1 files move to archive folders. READMEs updated for v2.
    [BOM_Board1_PCB1_1_2026-08-31.xlsx, BOM_PCB1_1_v2_2026-10-03.xlsx, PickAndPlace_PCB1_1_2026_08_31.xlsx, PickAndPlace_PCB1_1_v2_2026-10-03.xlsx]
2026-10-03 Fix H2 silkscreen label: 5V -> 3V3
    H2 pin 3 is wired to the 3V3 net in v2 but the silkscreen still read 5V.
    Re-exported Gerber/BOM/PnP; only the top silkscreen layer changed
    (BOM differs only in live LCSC/JLCPCB stock counts).
    [BOM_PCB1_1_v2_2026-10-03.xlsx, PickAndPlace_PCB1_1_v2_2026-10-03.xlsx]
2026-10-08 Add DrowsyFW: camera pipeline and eye open/closed model
    PlatformIO firmware for the ESP32-S3-CAM N16R8: OV5640 grayscale SVGA,
    fixed eye box cropped to 96x96, MobileNetV2 INT8 on TFLite Micro giving
    P(eye closed). Includes the MRL training script (91.2% INT8 test accuracy,
    split by subject) and a PC viewer to place the eye box and collect crops.
    Notes the carrier PCB fault: with the module on PCB1_1, camera bit D6
    (GPIO17) reads wrong; images are clean with the module off the carrier.
    [camera.cpp, camera.h, config.h, eye_model.cpp, eye_model.h, eye_viewer.py, main.cpp]
2026-10-16 Add firmware design: glossary, ADRs, and updated plan
    Record the outcome of the firmware/ML/dashboard design session:
    - GLOSSARY.md with the domain terms (Trip, Sample, Event, Drowsiness
    Level, Microsleep, Distraction, Unmonitored, Sync, dashboards)
    - ADR 0001: decide and alert on the device
    - ADR 0002: device-first history synced to Supabase
    - firmware-plan.html rewritten with the end-to-end workflow, decisions,
    task layout, ML training steps, schedule to Nov 3-5, and test script
    - ml/README.md: ESP-DL and TFLite Micro ship with Arduino core 3.3.12
    - .gitignore: keep secrets.h out of the public repo
2026-10-16 Add v1 bench wiring map and BenchTest sketch
    PCB v2 has not arrived, so firmware is tested on the v1 board without
    plugging the module in (v1 headers are mirrored). The wiring map comes
    from the v1 project netlist and routes module pins to the v1 header
    rows with dupont wires. BenchTest exercises LEDs, LDR, OLED (raw
    SSD1306, no library), buzzer and IR, and counts bright camera pixels
    with exposure locked to tell whether the OV5640 sees 940 nm IR.
2026-10-16 Update firmware plan with ESP-DL spike results and partition choice
    Path B (ESP-DL HumanFaceDetect) passed on the board, so path A is no
    longer needed. Record its measured timing, accuracy by camera position,
    the 90-degree rotated camera image, and the small eye size at QVGA.
    Face detect plus WiFi already needs 3.18 MB, so the plan moves to a
    custom partition table with two 6 MB OTA app slots and ~3.9 MB FFat.
    The camera mounting position is still open.
2026-10-16 Add DrowsyFW skeleton with custom partitions, tasks, and web OTA
    Start the real firmware: tasks pinned per core (vision, alert, sensor
    on core 1; log, net, sync, web on core 0) sharing state through a
    mutex-guarded struct. Includes buzzer-safe boot, LDR/IR hysteresis,
    camera fps measurement, trip number in NVS plus FFat mount, AP that is
    always on with saved WiFi retries, NTP and browser time, mDNS, a basic
    status page, mute, and password-protected OTA upload.
    partitions.csv gives two 6 MB OTA app slots and ~3.9 MB FFat, since
    face detection plus WiFi no longer fits a 3 MB slot. secrets.h stays
    out of git; secrets.example.h shows its fields.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
2026-10-17 DrowsyFW 0.2.3: face detection, eye classifier, and live view
    Bring the ESP-DL HumanFaceDetect pipeline from the FaceSpike test into
    the firmware: rotate the sideways camera frame, compensate head tilt
    from the eye line, and use MSR score threshold 0.30. Crop a square
    Eye Region (0.8 x eye distance) around each eye, preprocess it with
    the bit-exact eye_preprocess.h, and run the 32x32 INT8 eye-state CNN
    on TFLite Micro for both eyes, averaging P(closed).
    Also switch the camera to HVGA for larger eye crops, adopt the
    0.5 / 0.3 thresholds from the MRL threshold analysis, keep the TFLM
    arena small enough for internal RAM with a PSRAM fallback, and add an
    upright /snapshot.jpg with face and eye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
2026-10-18 DrowsyFW 0.2.5: rotate inside face-detect preprocessing, deep2half eye model
    Stop rotating the whole HVGA frame before face detection (~32-38 ms per
    frame). FaceView (face_view.h) maps each pixel of the upright, tilt-
    compensated image to the raw frame with the same 16.16 fixed point as the
    old rotateInto. HumanFaceDetect::run_view() picks only the pixels each model
    input needs and converts them with esp-dl's own RGB565 -> BGR888 NormQuant
    template, so MSR/MNP inputs and Eye Regions are byte-identical to the old
    path. esp-dl 3.3.11 preprocess(img, M) is not used: its gen_xy_map()
    corrupts the heap for non-square inputs.
    Board A/B on the same frames: face found 78/78, eye points 0 px apart,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
2026-10-18 ml: preprocessing shared with firmware, bit-exact test, training notebook
    preprocess.py and eye_preprocess.h implement the same integer gray->32x32->int8
    pipeline; test_preprocess.py and golden_test/ check PC and board match.
2026-10-18 enclosure: build123d CAD for windshield-mount box, print set 2026-10-18
    Horizontal layout with IR row on top, 1/4"-20 nut for the suction mount,
    check.py for clearances, STEP/STL outputs and the shop print request.
2026-10-18 Add CLAUDE.md: build/flash, DrowsyFW architecture, ML and CAD commands
2026-10-18 DrowsyFW 0.2.8: drowsiness logic (PERCLOS, levels, Distraction, Unmonitored)
    - DrowsinessJudge (drowsiness.h/.cpp, no Arduino dependency): time-based,
    holds Eye State 0.5 s on face loss, PERCLOS over 60 x 1 s buckets
    (Open+Closed only, ready after 30 s), closed-run latch until eyes open
    1 s, PERCLOS hysteresis, events in a ring queue
    - Closed run tolerates a short Open misread (< 0.3 s), Uncertain up to
    1 s and face loss up to 2 s (desk test: model and face detector both
    drop frames while eyes are closed)
    - Events go through a FreeRTOS queue to the log task: printing Serial
    from the vision task stalled it ~3 s when COM6 was not open
    - Frame dt capped at 400 ms so one frame after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
2026-10-18 DrowsyFW 0.2.9: arm Distraction on first visible eyes, stop after 60 s absent
    - No Distraction at boot until eyes are seen once (it used to fire 3 s
    after boot with nobody in front)
    - Eyes not visible > DRIVER_ABSENT_MS (60 s) = driver left: Distraction
    clears and re-arms on the next visible eyes, so a parked device left
    powered does not beep forever
    - A latched level 3 is unaffected by either rule
    - PC tests: boot with no face, away 70 s, microsleep + head drop 70 s (74 checks)
2026-10-18 enclosure: mark hex keys 1.5/2.5 as on hand
2026-10-18 DrowsyFW 0.3.1: trip history on FFat, Supabase sync, Cloud Dashboard
    - trip_record/trip_log: 1 Sample per second + Events per Trip on FFat,
    Trip Summary, delete synced Trips at 80% full; /trips, /api/trips
    - sync: upload unsynced Samples/Events to the Postgres RPC ingest in
    resumable batches; mbedTLS buffers in PSRAM (internal RAM too small)
    - cloud/sql: trips/samples/events with RLS, trip_summary view, ingest +
    claim_device (ADR 0003: RPC instead of Edge Function)
    - docs/dashboard: Cloud Dashboard (email login, trip list, timeline)
    - OTA: abort an unfinished upload before starting a new one
    - PC tests: firmware/tests/trip_record_test.cpp, cloud/test/sql_test.mjs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
2026-10-18 docs: update firmware plan to DrowsyFW 0.3.1 status; enclosure sandpaper bought
    Adds a status table, the deep2_half model results, drowsiness logic rules,
    the Trip file format, the Supabase RPC ingest, and a new day plan to 4 Nov.
2026-10-18 DrowsyFW 0.3.2: closed run needs real Closed frames; Trip 411 regression test
    On Trip #411 the bridging rules stitched NotVisible and Uncertain frames into
    3 s closed runs and raised two false Microsleeps while the driver was not
    facing the camera. A closed run now needs Closed frames to lead Open/Uncertain
    by 0.3 s and to cover at least 25% of the run.
    firmware/tests reconstructs 150 ms frames from the board's 1 Hz samples of
    Trip 411: old rules reproduce both Microsleeps, new rules give none.
    80 PC tests pass. Cued desk test on the board not run yet.
2026-10-18 DrowsyFW 0.3.3: closed run needs the face seen >= 40%; Trip 412 regression test
    Trip 412 (0.3.2, 18 Oct 22:12/22:14): looking down at homework/phone with eyes
    open raised 2 Microsleeps. The face was lost most of the time; the few frames
    with a face read Closed, and EYE_HOLD + bridging stretched them into 5-7 s runs.
    New rule CLOSED_VISIBLE_MIN_PCT 40: a closed run counts toward L2/L3 only if
    raw Closed+Open+Uncertain frames cover >= 40% of it (held + bridged
    NotVisible <= 60%). Trip 412 runs reach at most 38%; real closure with
    dropouts (0.2.8 desk) is 52%; the 1.8 s face-loss bridge test is exactly 40%.
    Tests: trip412_frames.h rebuilt from samples 3143-3323 with
    reconstruct_trip.cpp --loo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
2026-10-18 DrowsyFW 0.3.4: latched level releases when no eyes are seen for long
    Trip 413 (0.3.3, 18-19 Oct): the user walked away, L2 entered at sample 2451
    from unseen frames and stayed latched 3294 s with no eyes seen, because the
    only release was 1 s of open eyes. The buzzer would sound on while parked.
    Now a latched eye level 2 clears after DRIVER_ABSENT_MS (60 s) with no raw
    visible frame, and level 3 after MICROSLEEP_ABSENT_CLEAR_MS (5 min), so a
    microsleep followed by a head drop still keeps L3 (70 s test unchanged).
    The usual LevelChange event is emitted.
    Tests: level 2 + 70 s not visible -> clears between 60 and 61 s; level 3
    stays at 4 min and 299.85 s, clears by 301 s; Trip 413 samples 24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
2026-10-23 CLAUDE.md: PCB v2 bench test results (23 Oct)
    Board v2 passes boot, camera, IR, buzzer, LEDs, LDR, OLED, USB-C power
    and Supabase sync. Notes SW1 direction, the camera seeing 940 nm IR,
    ~17% cam_hal FB-SIZE frame drops (not PCB related), LDR readings, and
    how to flash test sketches without wiping DrowsyFW's FFat partition.
2026-10-23 docs: add STATUS.md with work done and work remaining (23 Oct)
    One place for the project timeline, what is finished in firmware, ML,
    cloud, PCB v2 and the enclosure, the remaining tasks with status and
    owner, and pointers to the detailed docs.
2026-10-23 docs: firmware plan section 0 lists remaining work as of 23 Oct
    Replace the 18 Oct status table with the remaining tasks grouped as in
    docs/STATUS.md (status, explanation, owner) plus the suggested order.
    Header now says updated 23 Oct, DrowsyFW 0.3.4 on the board. Sections
    1-9 are still the 18 Oct text.
2026-10-25 enclosure: SW1 extender v2 with long plate under the lid
    The 18 Oct extender tilted on the switch lever when pushed at the top,
    so the switch did not move (pushing near the base worked). The small
    flange is now a 12 x 5 mm plate 0.2 mm under the lid, so the extender
    cannot tilt and has to slide. Stem is 3.6 mm along the slide (was 3.0);
    socket depth stays 3 mm. check.py now also checks the extender against
    the board dummies and reports its gap to the MH posts (0.43 mm).
    New print set print_2026-10-26 holds only the extender, with socket
    fit 0.3 (as before) and 0.2. Not yet printed or tested.
2026-10-25 enclosure: drop the 0.2 mm socket-fit variant of the SW1 extender
    The print shop's parts come out to size, so one extender with the 0.3 mm
    socket fit (same as the 18 Oct part that fitted the lever) is enough.
    Shop message now asks for 1 piece.
2026-10-25 enclosure: replace SW1 slide extender with a rocker on a glued bracket
    The long-plate slider (ce36122) still fails on paper: the knob sits
    ~18 mm above the lever, so with a 12 mm plate friction eats most of the
    push (about 10x the switch force at mu ~0.3). The SW1 lever itself also
    bends a lot: pushing its tip only tilts it, pushing its root next to the
    switch body slides it (tested on the board).
    New parts: sw1_rocker pivots on a paper-clip pin (1.4 mm holes, z 25.0)
    in sw1_bracket, which is epoxied under the lid with two tabs that key
    into the existing lid slot. The fork touches the lever only in a 1 mm
    band 0.4 mm above the switch body, with a 3.5 mm relief above it so the
    lever tip is n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
2026-10-25 enclosure: printed pivot pin for the SW1 rocker
    Replace the paper-clip pin with a printed ASA pin (sw1_pin, 1.8 mm shaft,
    3.2 x 0.8 mm head). Bracket holes are now 1.9 mm (pin does not turn) and
    the rocker hole 2.1 mm (rocker turns on the pin). The rocker gets a round
    boss of radius 2.15 mm around the hole so the wall is not 0.45 mm thin;
    its top stays 0.4 mm below the glue flange at any angle. The tail sticks
    out 0.3 mm on the far cheek for a dot of epoxy. check.py also checks the
    pin against bracket, lid, board parts and the rocker at every swing
    position (all clear; pin 0.82 mm from the nearest MH post). Shop message
    asks for 2 pins (1 spare). Not yet printed.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
2026-10-25 CLAUDE.md: cloud test and dashboard commands, SW1 rocker notes
    Add the PGlite SQL test command and how to serve the dashboard locally
    (Pages builds from main /docs). Enclosure section now covers
    assembly.py, the two fixed print sets, the SW1 rocker (lever bends, so
    only its root may be pushed; knob moves opposite to the lever), what
    check.py verifies for it, and restoring timestamp-only lid/base .step
    diffs before committing. README.md is listed as stale (3 Oct status).
2026-10-27 DrowsyFW 0.3.5-hw: OLED status, IR mode, hardware tests, BOOT mute, new Device Dashboard
    - OLED SSD1306 status screen (own driver, Core 0 task)
    - IR mode auto/on/off from the web, saved in NVS
    - /api/test buttons for buzzer, LEDs, IR, OLED
    - BOOT button mutes level 1-2 alerts for 5 minutes
    - Device Dashboard: status cards and 2-minute live graph
    - Point Sync at the new Supabase project
2026-10-27 cloud: store samples.ldr as integer
    A partly written sample record on the device reads ldr = 65535, which
    overflows smallint and made ingest reject the whole batch, so every later
    trip stalled behind it. Re-running the file widens existing projects too.
2026-10-27 Cloud Dashboard: plain-language driver view with safety score and trip delete
    - Safety score 0-100 per trip and weighted over the last 7 days, with grade
    - Overview tiles, per-trip score trend and rule-based driving tips
    - Trip cards, plain-language summary, state breakdown, timeline chart,
    readable event log and advice
    - Drivers can delete their own trips (RLS delete policy); trips still
    syncing are locked
2026-10-27 Cloud Dashboard: logout clears the local session even when offline
    signOut() with the default global scope calls the server first and keeps
    the local session if that call fails, so the button looked dead.
2026-10-28 DrowsyFW 0.3.6-wifi: set WiFi networks from the Device Dashboard
    - /wifi page (admin / OTA_PASSWORD): scan nearby networks, add, forget
    - Up to 5 networks saved in NVS, tried in order; secrets.h stays as fallback
    - Saving or forgetting reconnects right away instead of waiting a minute
2026-11-01 DrowsyFW 0.3.5-camtest: serial camera/IR test commands; night IR too weak
    Serial commands in loop() let the camera and IR be measured over USB
    without WiFi: force IR on/off/auto, set gain ceiling, AE level, exposure
    and gain, and log frame/center/eye brightness, face hits and the real
    OV5640 gain/exposure registers every 2 s. Normal behaviour is unchanged.
    CLAUDE.md: dark-room result from 27 Oct (board IR changes the image by
    only 1-4 levels even at 10 cm; camera does pass IR from a TV remote, so
    the LEDs are too weak, plan is an external 850 nm USB lamp), OV5640
    gainceiling units, DTR reset on opening the serial port, arena size.
2026-11-01 DrowsyFW 0.3.6-oled: OLED display task (untested on board)
    - display.cpp: SSD1306 128x64 via U8g2 on Core 0, 5 Hz. English text,
    full-screen alerts on black without blinking, priority
    WAKE UP! > DROWSY > EYES ON > NO READ > TIRED > WAITING > OK + PERCLOS,
    status bar WIFI/SYNC/IR/MUTE, dims with the IR LDR thresholds,
    exits quietly when no display answers at 0x3C/0x3D
    - DrowsyResult/SharedState: driverPresent for the WAITING screen
    - tests: driverPresent checks (102/102 pass)
    - CLAUDE.md: OLED notes, U8g2 dependency, repo/Arduino diff check,
    STATUS.md pointer · GLOSSARY: Unmonitored avoid list
2026-11-01 DrowsyFW 0.3.7-oled: driver-facing OLED, one screen at a time (untested on board)
    - oled.cpp: the friend's SSD1306 driver, font, retry and web test pattern
    are kept; only the drawing changes. One big word + one small line,
    5x7 font scaled x1-x4, no blinking, dims with the IR LDR thresholds
    - Boot phase: CONNECTING + SSID being tried -> WIFI OK + SSID or
    NO WIFI + AP name for 3 s (net.cpp exposes staTrying / staTried)
    - Running: WAKE UP! > DROWSY > EYES ON THE ROAD > 2 s notices
    (MUTED x MIN, WIFI LOST / WIFI OK) > NO READ > TIRED > WAITING > AWAKE
    - driverPresent (ported from 0.3.6-oled) drives WAITING, with 5 test checks
    - OLED_PERIOD_MS 500 -> 200; debug values stay on the Device w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
2026-11-02 Docs: friend's work as the base, OLED 0.3.7, new Supabase project
    - CLAUDE.md: main = friend's branch (PR #6), firmware branch kept for
    reference only; Device Dashboard endpoints, BOOT mute, WiFi page;
    Sync uses Supabase project iatzjmxj and needs the device re-registered
    - STATUS.md: timeline 27 Oct - 2 Nov, items 3.1 (OLED waits for the board),
    3.4 and 5.1 done, 5.3 device registration, 7.2 report dropped
2026-11-03 DrowsyFW 0.3.8-oled-info: one info screen with status, eyes, sound, AP and URL
    The OLED now shows a single screen instead of one phase at a time:
    - top bar (x2): AWAKE / TIRED / SLEEPY / WAKE UP! / LOOK AHEAD / UNCLEAR / NO DRIVER,
    inverted for the three alert states
    - EYE: OPEN / CLOSED x.xs / UNSURE / NOT FOUND / NO FACE
    - SOUND: ALARM / TEST / MUTED m:ss / BEEPING / ON (same rules as the buzzer in alert.cpp)
    - AP name, URL via the AP (192.168.4.1) and the IP on WiFi
    Flashed and checked on the v2 board on 3 Nov. Docs updated, including the
    arduino-cli cache gotcha (compile --clean after removing a sketch file).
2026-11-03 DrowsyFW 0.3.9-face-roi: face ROI, live view fixes, WiFi diagnostics
    - Face detection: send a 4:3 ROI to the MSR stage instead of the whole
    320x480 upright frame. The whole frame shrank faces to 1/2 x 1/4 in the
    160x120 input; A/B on the board found 0% of faces at 0.5-1.5 m, the ROI
    path 75-100%. Track the face with a ROI 2.5x its size (at least 160x120,
    at most a 320x240 band); search full frame, bands, 160x120 tiles, then
    tilt angles. FACE_ROI 0 restores the old path.
    - Status shows face_roi; /snapshot.jpg draws the ROI in grey.
    - Live view: release the snapshot mutex before JPEG encoding so vision no
    longer skips frames (frozen image on the dashboard), and give each JPEG
    res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
2026-11-03 DrowsyFW 0.3.10-dash: redesigned Device Dashboard
    Mobile-first page for demos and the driver, following the system light or
    dark theme: a large status card coloured by level (pulses at level 3 and
    for distraction), a full-width mute button with a countdown, a large live
    camera view with face/eye chips and a box legend, tiles for eyes,
    PERCLOS (bar with level marks) and connection/sync, the 2-minute chart,
    and icon links to Trips, WiFi and OTA. Developer details (timings, face
    score, ROI, IR/LDR, free RAM, 32x32 eye crops, IR mode, hardware tests,
    raw status) sit in a collapsed section. Eye crops load only while that
    section is open, and image polling pauses while the page is hidden.
    Co-Auth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
2026-11-03 CLAUDE.md: Device Dashboard 0.3.10 notes and branch status
2026-11-03 Dashboards: cartoon look for Cloud Dashboard and Device Dashboard (0.3.11-toon)
    Cloud Dashboard (docs/dashboard): car mascot whose headlight eyes droop
    with the safety score, day/night road scene following the device theme,
    sticker-style cards and buttons, drawn icons instead of emoji, and a
    motion layer (road, wheels, blink, card entrance) that respects
    prefers-reduced-motion. Supabase queries, scoring and delete flow are
    unchanged; the score chart now sizes its viewBox to the real width so
    its labels stay readable on phones.
    Device Dashboard: same 0.3.10 layout restyled to match, with the mascot
    in the status card mirroring the driver (closed eyes, looking away,
    shake at level 3). System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
2026-11-03 Docs: Cloud Dashboard section, offline preview, SW1 toothpick
    - CLAUDE.md: Cloud Dashboard gets its own section (data it reads,
    client-side score, live-trip guard, look), notes the friend's Render
    deploy that does not redeploy on merge, line-ending tip for comparing
    the sketch folder with the repo, and the 0.3.11-toon status.
    - cloud/test/dashboard_preview.py + dashboard_stub.js: serve
    docs/dashboard with a fake supabase-js so the logged-in views can be
    checked without an account (?out=1 ?nodev=1 ?empty=1 ?delok=1).
    - SW1: the 3D-printed rocker broke and the replacement switch did not
    work, so the original SW1 is pushed with a toothpick through the lid
    slot (CLAUDE.md, enclosur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
2026-11-03 In-car test before fine-tuning: cartest.py + /eyes.raw (0.3.13-raw)
    - ml/incar/cartest.py: speaks cues (parked protocol: 2 min eyes open with
    mirror glances, phone, blinking, squint; then 5 s closes x5 and one 8 s
    close; or a cue-less drive recording), polls /api/status ~5 Hz, and
    scores the board's own result: alarms on each close and their delay,
    false alarms and false distractions while eyes are open. Also saves the
    32x32 eye inputs from /eyes.raw when the firmware has it, so the same
    session can feed a fine-tune.
    - ml/incar/score.py re-scores saved sessions and says whether misses come
    from face detection or from the eye model; fake_board.py dry-runs the
    script on a PC. R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
2026-11-03 Fine-tune tools ready for after the car test: review, finetune, replay
    - ml/incar/review.py: local page to check the labels of captured eye
    crops (click to cycle cue/open/closed/drop, "suspicious only" filter
    where the board's P disagrees with the label), saved to labels.json.
    - ml/incar/finetune.py: trains the on-board architecture (deep2_half,
    same 5 ops) on MRL + in-car crops split by session, oversampling the
    in-car crops; exports INT8 model_data.h and a per-eye report against
    the model currently in firmware/DrowsyFW/eye_model_data.h, plus per
    frame P for replay.
    - firmware/tests/replay.cpp + ml/incar/replay.py: feed a session's P
    (from the board, the board's model, or the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
2026-11-04 Car test plan: use friend's 0.3.15-p15 already on the board
    The board runs 0.3.15-p15, which is newer than main (0.3.13-raw) and has
    no source on GitHub yet, so flashing main would undo the friend's tuning.
    The in-car test now runs on the board as it is: no flashing, results
    only, no eye crops because this build has no /eyes.raw. Fine-tuning needs
    the friend's source merged with /eyes.raw first. CLAUDE.md records the
    board version, where the source is, and the flash backup.
2026-11-04 Car test results: 0.3.18-p50 settings and better test tools
    Firmware set from parked in-car tests on 4 Nov:
    - P(closed) threshold 0.5 (0.3 was too sensitive with glasses, 0.6 missed
    closed eyes because one eye read 0.1-0.3 through the frame)
    - PERCLOS alarm at 0.40 and level 1 (TIRED) removed, so OLED, LED and web agree
    Test tools:
    - cartest prints the steps first, polls more slowly and saves the board's
    event log, because web stalls lost status rows (showed 1/6, board had 6/6)
    - score fills gaps from the event log
    - oled_check shows what the OLED should display
    Docs now say the board runs this firmware, not friend's 0.3.15-p15.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
2026-11-04 Update CLAUDE.md with current alarm rules and car test commands
    - Fix eye state thresholds, where settings live, BOOT mute and model status
    - Add the current alarm rules and limits the user accepted
    - Add car test commands, how to run one test and the trip JSON cut-off
    - Record the LDR reading 4095 in the car
2026-11-04 Record the board timing test in the car test notes
2026-11-04 Show the 0.40 PERCLOS limit on the Device Dashboard
    The PERCLOS card still showed the old 15% and 25% limits after level 1
    was removed. The label, bar mark, bar colour and chart line now match
    the 0.40 alert limit. Alert rules are unchanged.
    Flashed as 0.3.20-dash and checked on the board.
2026-11-04 docs: organize docs and print folders, refresh README
    Move status, bench wiring, and old spec docs into subfolders, group
    enclosure print sets under enclosure/print, and update the path references.
    Rewrite the outdated README status and repo layout.
2026-11-05 จัดโค้ด DrowsyFW เป็นโฟลเดอร์ใต้ src/
    แยกไฟล์ตามหน้าที่เป็น core, vision, logic, device, trip และ net
    แก้ include, คำสั่งเทสต์, สคริปต์ ML และเอกสารให้ตรงกับ path ใหม่
    ไม่แก้ logic ของ firmware
2026-11-05 เพิ่มบทรายงานการใช้ FreeRTOS ใน DrowsyFW
    แบ่ง task ตาม core, เหตุผลของ priority, mutex/queue/try-lock
    ระหว่าง task, ปัญหาที่เจอ และข้อจำกัด
    Claude-Session: https://claude.ai/code/session_01LtuXybPxtG59wjCDZMzm1b
